ACwing-UAV/ACwing_HW/01 - FC_KiCadProj/README.md

# ACwing FC rev A – KiCad project

**Project:** ACwing · **Author:** Andrea Cirillo

KiCad sources of the ACwing FC rev A board (KiCad 10 project files, 2026-11-07). The board description, schematic PDF, BoM,
JLCPCB files, Gerber, STEP and board views are in [`00 - Docs/00 - FC_Docs`](../00%20-%20Docs/00%20-%20FC_Docs/).

| File / folder | What |
|---|---|
| `ACwing_FC_A.kicad_pro`, `.kicad_sch`, `.kicad_pcb` | project, schematic, routed PCB |
| `*.kicad_sym`, `*.pretty/`, `fp-lib-table`, `sym-lib-table` | project library (symbols, footprints, ACwing logos) |
| `3d/` | STEP models, referenced as `${KIPRJMOD}/3d/...` |
| `generator/` | scripts that generated, routed and checked the design (build_all_h.sh) |
