ACwing-UAV/ACwing_HW/02 - ESC_1S_KiCadProj/README.md

# ACwing ESC 1S rev A – KiCad project

**Project:** ACwing · **Author:** Andrea Cirillo

KiCad sources of the ACwing ESC 1S rev A board (KiCad 10 project files, 2026-11-07). The board description, schematic PDF, BoM,
JLCPCB files, Gerber, STEP and board views are in [`00 - Docs/01 - ESC_1S_Docs`](../00%20-%20Docs/01%20-%20ESC_1S_Docs/).

| File / folder | What |
|---|---|
| `ACwing_ESC1S_A.kicad_pro`, `.kicad_sch`, `.kicad_pcb` | project, schematic, routed PCB |
| `*.kicad_sym`, `*.pretty/`, `fp-lib-table`, `sym-lib-table` | project library (symbols, footprints, ACwing logos) |
| `3d/` | STEP models, referenced as `${KIPRJMOD}/3d/...` |
| `generator/` | scripts that generated, routed and checked the design (build_all_esc.sh) |
