ACwing-UAV/ACwing_HW/00 - Docs/03 - FLOW_Docs/README.md

# ACwing Flow rev A – optical flow + ToF height board for ACwing FC rev A

**Project:** ACwing · **Author:** Andrea Cirillo · **Overview:** [repository README](../../Readme.md)

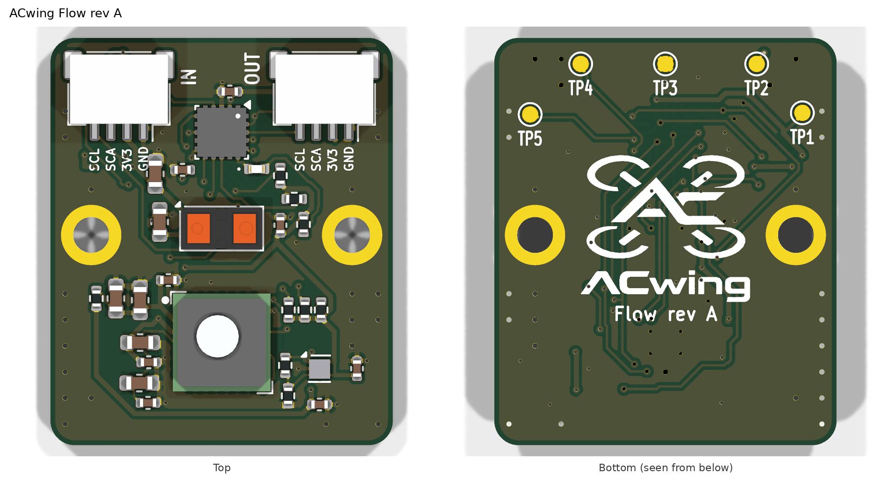
[picture p4: 00 - Docs/03 - FLOW_Docs/ACwing_Flow_A_pcb.png]
ACwing_Flow_A


> **Revisions.** Rev A is the first released revision.

> **Flow board cover (2026-11-13, mechanics, board unchanged).** Frame A1 rev R adds a PETG cover over the sensor side:
> only the PMW3901 lens, the VL53L1X window and LED D1 stay open; the J1 / J2 edge is open. The two board screws become
> **M2 × 6 nylon from below** through the cover. Keep-outs for a future revision: [mechanical handoff §0.24](../04%20-%20System_Docs/ACwing_mechanical_handoff.md).

> **Silkscreen with connector pin names (2026-11-12, still rev A).** The connector labels now carry the pin names (commit 568e74d). Layout and copper unchanged. `ACwing_Flow_A_pcb.png` and `ACwing_Flow_A_3D.png` regenerated with the KiCad 10.0.6 raytracer (`99 - Tools/outputs/k10_renders.sh`, `compose_board_renders.py`).

> **45° routing (2026-11-08, still rev A).** Every track is now at 0 / 45 / 90° (house rule for all ACwing boards):
> 165 off-angle runs replaced by octilinear doglegs, same end points, pads and vias; 0 segments off 45° left; 170 duplicated segments left by the router removed.
> Checked and saved with KiCad 10.0.6: DRC 0 / 0, ERC unchanged; Gerber, drill, STEP, schematic PDF, DRC report and renders regenerated.

> **Back to 1.0 mm (2026-11-07 evening, still rev A).** To save weight, all ACwing boards are **1.0 mm** again (the
> 1.6 mm step of the same morning is reverted): 2 layers, 0.91 mm core, KiCad 10 files, vias unchanged. Layout unchanged.
> The board back is 0.6 mm closer to the tray face again (M2 × 4 nylon screws). Board mass −0.6 g. DRC 0 / 0.

> **Layout and routing update (2026-11-02, still rev A).**
> - **Both Qwiic connectors on the top edge** (they were on the left and right edges): J1 IN at (−6.3, +8.95), J2 OUT
>   at (+6.3, +8.95), mouth +t, labels QWIIC IN / QWIIC OUT under them. The cables to the FC and to the GPS board now
>   leave from the same edge: update cable C in the mechanical handoff.
> - **SWD test pads on the back side (2026-11-03), along the top edge, symmetric**, behind the Qwiic connectors and
>   close to the bridge MCU: TP1 3.3 V (−8.4, +7.9), TP2 NRST (−5.6, +10.9), TP3 GND (0, +10.9), TP4 SWDIO (+5.2, +10.9),
>   TP5 SWCLK (+8.3, +7.8) (sensor-side view; the layout chosen by A. Cirillo mirrored to the top edge). SWD lines
>   SWDIO 7 mm, SWCLK 6 mm (they were 41 / 17 mm with the pads on the bottom edge). The board is programmed off the
>   drone. Schematic numbering as 2026-11-02.
> - **Plated mounting holes (2026-11-03):** H1 / H2 are now Ø2.2 mm PTH with a 3.6 mm copper ring on both sides,
>   tied to GND (as the FC holes).
> - **Bridge MCU pins changed for the routing:** ToF XSHUT on **PA8** (pin 13, was PA0), status LED on **PA10**
>   (pin 15, was PA8). Firmware must follow.
> - No via in an SMD pad (the STM32C011 exposed pad keeps its ground vias); DRC 0.
> - Solder mask expansion 0.05 mm, minimum web 0.09 mm: every pad gap ≥ 0.19 mm, except the LDK130 DFN-6 (0.4 mm
>   pitch, 0.12 mm gaps, "allow solder mask bridges" on the footprint: JLC opens the mask over the pad row).

KiCad 10 project (2026-11-07). A 21 × 25 mm board for indoor flight: it measures ground motion
(optical flow) and height (time of flight). It sits under the battery tray, sensor side down, and connects to the
FC expansion bus (Qwiic) with a standard JST SH 4-pin cable.

## Decisions (2026-10-17)
| Topic | Choice | Why |
|---|---|---|
| Flow sensor | PixArt **PMW3901MB-TXQT** + LN03-ZSZ lens | the de-facto drone flow sensor (80 mm to infinity); no ST part does far-field optical flow |
| Height | ST **VL53L1X** ToF, on the Qwiic bus (0x29) | ST part, 4 m range indoors, standard driver (ULD) |
| Bridge MCU | ST **STM32C011F4U6** (UFQFPN-20) | the PMW3901 needs SPI with exact timing; the bridge reads it at 100 Hz and serves the data over I2C, so the FC needs no extra SPI/CS lines to a cable |
| Link | Qwiic / STEMMA QT (JST SH 4-pin) × 2, pass-through | same bus as the GPS board: flow and GPS boards chain in any order |
| Supply | 3.3 V from the FC expansion LDO (VEXP); 2.0 V for the PMW3901 core from an adjustable LDK130 | the PMW3901 VDD is 1.8–2.1 V |
| Mounting | under the battery tray, sensor side down, 2 × M2 | the FC bottom has no room (1.2 mm limit, frame deck 3 mm below); see the mechanical handoff |

## Contents
| File | What |
|---|---|
| `ACwing_Flow_A_pcb.png` | top and bottom renders of the assembled board |
| [`ACwing_Flow_A_schematic.pdf`](ACwing_Flow_A_schematic.pdf) | schematic |
| `ACwing_Flow_A_BoM.xlsx` | assembly BoM (sheet `BoM`) and costing (sheet `Costing`) |
| `ACwing_Flow_A_BoM_JLCPCB.xlsx`, `ACwing_Flow_A_CPL.xlsx` | JLCPCB BoM (LCSC part numbers) and pick-and-place with rotation corrections (30 parts) |
| `ACwing_Flow_A_gerber.zip` | Gerber (2 copper layers) + Excellon drill files, origin at the lower-left corner: upload as is to JLCPCB |
| `ACwing_Flow_A_DRC.rpt` | KiCad DRC report (0 violations, 0 unconnected pads) |
| `ACwing_Flow_A.step`, `ACwing_Flow_A_3D.png` | STEP of the assembled board; 3D renders (top, isometric, bottom) |
| `ACwing_Flow_A_mech_outline.dxf` | mechanical outline for the frame design |

KiCad sources in [`04 - FLOW_KiCadProj/`](../../04%20-%20FLOW_KiCadProj/):

| File | What |
|---|---|
| `ACwing_Flow_A.kicad_pro / .kicad_sch / .kicad_pcb` | KiCad 10 project, schematic, routed PCB |
| `ACwing_Flow.pretty/`, `3d/` | project library (symbols, footprints incl. the ACwing logos) and STEP models |
| `generator/` | scripts that generated and checked the design (see Regeneration) |

## Circuit
- **J1, J2 (Qwiic).** JST SM04B-SRSS-TB, both on the top edge (J1 IN left, J2 OUT right), wired in parallel: 1 GND, 2 3.3 V,
  3 SDA, 4 SCL. No pull-ups here (they are on the FC).
- **Power.** +3V3 from the bus (FC U11, 300 mA shared with the GPS board). The board draws about 35 mA (flow 9 mA,
  ToF up to 20 mA peak, MCU 3 mA).
  - U2 LDK130PU-R (DFN-6) set to 2.0 V by R5/R6 (15k/10k: 0.8 V × 2.5).
  - PMW3901 VDD through R1 3 Ω with C1/C2 22 µF + C3 100 nF; VDDIO on 3.3 V (C4 10 µF + C5 100 nF); VREG C6 4.7 µF +
    C7 100 nF. This is the datasheet reference circuit (Fig. 8).
- **U1 PMW3901MB.** SPI mode 3, 2 MHz, to the bridge: NCS PA4, SCK PA5, MISO PA6, MOSI PA7, MOTION PA3, NRESET PA2.
  R2/R3/R4 10 k pull-ups keep it deselected and out of reset while the bridge boots.
- **U3 VL53L1X.** On the Qwiic bus at 0x29. XSHUT (PA8) and GPIO1/INT (PA1) go to the bridge, with 10 k pull-ups.
  The bridge can hold the ToF in reset, which allows an address change if a second ToF is ever added.
- **U4 STM32C011F4U6 (flow bridge).** I2C1 target at **0x3B** on PB6/PB7. Planned firmware: read the PMW3901 motion
  burst at 100 Hz, accumulate dX/dY and publish them with SQUAL and shutter, plus a data-ready counter. The register
  map is part of the indoor firmware work.
  - SWD on test pads TP1 3.3 V, TP2 NRST, TP3 GND, TP4 SWDIO, TP5 SWCLK (first programming; later updates through the
    FC are possible with an I2C bootloader).
  - D1 green status LED on PA10 (low = on).
- **Bus map (whole drone).** GPS 0x42, GPS compass 0x1E, ToF 0x29, flow bridge 0x3B: no clash.

## Mechanics
- 21.0 × 25.0 × 1.0 mm (1.6 mm on 2026-11-07 only), R1.5 corners, 2 layers. Two M2 holes (Ø2.2 PTH, 3.6 mm GND ring both sides) at (±8.0, +0.4), keep-out r 2.4 mm.
- **All parts on one side** (the sensor side). Tallest: Qwiic connectors ≈ 2.9 mm, PMW3901 lens 2.28 mm, VL53L1X 1.56 mm.
  The back side has no parts: board name, logo and the five flat SWD test pads (program the board before mounting it).
- Sensor axes (sensor-side view): PMW3901 at (0, −6.2), field of view 42°; VL53L1X at (0, +0.8), 27°.
- Mount it parallel to the propeller plane, no window in front of the sensors. Everything for the frame designer is
  in [`ACwing_mechanical_handoff.md`](../04%20-%20System_Docs/ACwing_mechanical_handoff.md) and the DXF.

## PCB
- Rules: 0.15 mm tracks / 0.12 mm clearance (Default), 0.3 mm for power; vias 0.45/0.2 mm; copper to edge 0.3 mm.
- GND pours on both layers. Every small GND pad has its own via (the sensor side is crowded and its pour breaks up),
  4 vias at the PMW3901 ground pad corners, GND stitching on a grid, and a final check that joins any isolated
  ground island with a via.
- The LDK130 DFN-6 (0.4 mm pitch) escape is pre-routed and locked: IN/EN joined outside pin 5, GND via, short stubs.
- Routing: 733 tracks, 92 vias (2026-11-03: SWD lines re-routed to the back-side test pads), no via in an SMD or test pad.

## Checks
- Netlist: 0 errors (`check_net.py`, 44 nets).
- KiCad DRC (`ACwing_Flow_A_DRC.rpt`): 0 violations, 0 unconnected pads, 0 footprint errors.
- Silkscreen: QWIIC IN / QWIIC OUT on the sensor side; TP1–TP5, logo and board name on the back; no part references.

## Fabrication (JLCPCB)
- 2 layers, **1.0 mm** FR-4 (0.91 mm core), 1 oz. All parts on the top (sensor) side: single-sided assembly.
- BoM `ACwing_Flow_A_BoM_JLCPCB.xlsx`; every line has an LCSC number (PMW3901 C43496881, VL53L1X C190004,
  STM32C011F4U6TR C5456188, LDK130PU-R C157446).
- **PMW3901 lens.** The LN03-ZSZ lens is a separate item in the PixArt ordering table. Check that the LCSC/JLC part
  includes it; otherwise order the lens separately and press it on after reflow (it is not reflow-safe if it is a
  plastic lens).
- CPL rotations: the corrections learned on the FC are applied (DFN-6 +270°). Check U1 pin 1, U2, U3 and U4 in the JLC
  preview before ordering.
- Cost: about **11.1 USD per board at 10 boards, 9.4 USD at 100** (components only). The PMW3901 is about half of it.

## To check before ordering
1. ERC: **done with KiCad 10.0.6 (2026-11-07)**. The 1 error is a power-flag case: PMW_VDD is fed through R1 (a
   passive pin), so add a PWR_FLAG on it. The library warnings come from the KiCad setup.
2. PMW3901 land pattern: COB-28, 6 × 6 mm, 28 pads at 0.65 mm pitch on rows ±2.625 mm, centre pad 2.4 × 1.9 mm.
   The optical axis is at the footprint centre, which the mechanics use (t = −6.2 on the board, frame centre).
3. Lens: LCSC stocks the PMW3901MB-TXQT (C43496881, 162 pcs on 2026-11-07), not the LM19-LSI lens. JLC does not list
   lens fitting during assembly. Buy the LM19-LSI from a PixArt distributor and fit it by hand after assembly, following the PixArt
   lens mounting note.
4. JLC preview of the CPL.
5. The STM32C011 bridge firmware is not written yet: the board can be tested first with the ToF only (direct on the bus).

## Regeneration
`generator/run_sch.sh`, `gen_pcb_flow.py`, `loop_route.sh`, `post_route.sh`. Uses `kisch.py`, `sexp.py`, `silk_refs.py`,
`step_mesh.py` from the FC generator and `make_3d_e.py` for the missing STEP models. Freerouting is not deterministic:
`loop_route.sh` reruns it until the DRC has no unconnected item.

> The generator scripts were run in the original build environment: absolute paths inside them (`/home/claude/...`) must be adapted before running them again. The ACwing logos and silkscreen labels were added afterwards with the tools in [`brand/tools`](https://github.com/ACwing-UAV/ACwing/tree/main/brand/tools) of the ACwing system repository.
