ACwing-UAV/ACwing_HW/00 - Docs/00 - FC_Docs/README.md

# ACwing FC rev A – universal flight controller: 1S–6S, commercial 4-in-1 ESCs, up to 8 motors

**Project:** ACwing · **Author:** Andrea Cirillo · **Overview:** [repository README](../../Readme.md)

ACwing_FC_A

> **Revisions.** Rev A is the first released revision. Earlier letters, marked *draft* in this document (drafts C–G), are internal design iterations that were never manufactured.

> **Silkscreen with connector pin names (2026-11-12, still rev A).** The connector labels now carry the pin names (commit 568e74d). Layout and copper unchanged. `ACwing_FC_A_pcb.png` and `ACwing_FC_A_3D.png` regenerated with the KiCad 10.0.6 raytracer (`99 - Tools/outputs/k10_renders.sh`, `compose_board_renders.py`).

> **45° routing and no battery pads (2026-11-08, still rev A).**
> - **Every track is now at 0 / 45 / 90°** (house rule for all ACwing boards): 374 off-angle runs from Freerouting
>   replaced by octilinear doglegs or a short octilinear A* detour, same end points, pads and vias; 0 segments off 45°
>   left (checked on the exact coordinates). 93 duplicated segments and 3 dangling stubs left by the router removed.
> - **Battery pads J7 / J8 removed** (and the "- BAT +" label). The FC is supplied **only through ESC link A J2 pin 2
>   (VBAT)**, as on commercial FC / 4-in-1 ESC stacks. The Qwiic ports stay 3.3 V I2C only (VEXP is an output of the FC).
>   With separate ESCs + PDB, crimp a JST SH 8-pin lead with GND / VBAT on pins 1 / 2 (JST SH: 1 A per contact, the FC
>   draws < 0.5 A).
> - Checks with KiCad 10.0.6: zones refilled, DRC 0 violations / 0 unconnected, schematic parity: no missing or extra
>   footprint, ERC the same 2 power-flag errors as before. Gerber, drill, STEP, schematic PDF, DRC report, renders and
>   routing plot regenerated; CPL checked against the KiCad position export (unchanged).

> **Layout update 2 and 1.0 mm (2026-11-07 evening, still rev A).**
> - **ESC A (J2) on the front edge just after the front-left arc**: centre (−10.5, +16.85), body u −16.4 … −4.6
>   (0.6 mm from the end of the R3 arc), right above ESC 1S J1: cable A is a short, straight 1:1 loop. **ESC B (J6)**
>   takes the old ESC A place, (+3.64, +16.85). ESC A M1–M4 run from J2 to R20–R23 as a B.Cu bus under J2 / J6.
> - **Front-left corner R3 again** (the ESC 1S charge port moved under the FC USB-C at the rear-right chamfer).
> - **RGB LEDs at the corner tips, the same on both corners** (point-symmetric): D1 (−15.1, −18.4), D2 (−18.4, −15.1),
>   D3 (+15.1, +18.4), D4 (+18.4, +15.1); each pair 5.4 mm apart (was 10.5 mm). Decoupling C40 / C41 / C42 / C45 next to them.
> - ~~Battery pads J7 / J8 down the left edge~~ (removed on 2026-11-08, see above).
> - **BLE antenna AE1 down the left edge**: (−18.6, +4.3), keep-out u −20.5 … −17.5, v −1.2 … +10.3; RF line from
>   the MLPF ≈ 16 mm, straight, 50 Ω on F.Cu over In1 GND (was 22.4 mm).
> - **Magnetometer U3 and barometer U4** right of the MCU, front-right quadrant: U3 (+16.0, +10.0), U4 (+13.4, +13.8),
>   ≈ 36 mm from the buck inductor L3. Decoupling on the bottom below them. LED supply kept ≥ 4.5 mm from U3.
>   `generator/emi_check.py`: static field at U3 39.5 µT upper bound (was 42.6 µT), L3 stray field 0.05 µT; IMU unchanged.
> - **Board 1.0 mm again** (JLC04101H-7628: same 0.21 mm 7628 prepreg under F.Cu, so RF line and USB pair unchanged).
>   J1 USB-C shell legs stick out ≈ 0.8 mm under the board again. Board mass −1.8 g.

KiCad 10 project (2026-11-07). Rev A turns the FC into a **standard FC that works with any power
stage that uses the common 4-in-1 ESC connector**:
- **Mini drone (1S, brushed coreless):** the ACwing 1S power board (ACwing ESC 1S rev A) carries the
  motor stages, the battery connector and pads, the 1S USB-C charger and the current sensor. To the FC it looks like
  any ESC: VBAT (1S) and CUR on the 8-pin cable.
- **Larger drone (3S–6S brushless, payload > 2 kg):** a commercial 20 × 20 4-in-1 ESC replaces the power board and
  supplies the FC through the same cable. Hexa / octo frames add a second 4-in-1 ESC on ESC link B.

The FC has one USB-C port for data, DFU flashing and bench supply only. Battery charging lives on the 1S power board
(its own USB-C), because only the 1S battery can be charged that way.

## Layout update (2026-10-24, still rev A: no board made yet)
| Item | Before | Now | Why |
|---|---|---|---|
| **MCU U2** | (−3.0, +3.0) | **(0, 0), board centre** | symmetric layout; RF line to the antenna 22.4 mm (≈ 0.2 dB more loss than before), 50 Ω microstrip over solid In1 GND |
| **IMU U1** | (0, −3.6), rot 0 | **(0, −7.6), rot 270** | room for the pin escape south of the centred MCU; INT1 / MISO face MCU pins 42 / 44 (straight pre-routed lines). **Firmware: remap the IMU axes** (sensor X = board −v, Y = board +u) |
| **J6 ESC link B** | left edge | **front edge, next to J5 (ELRS)**, same mouth direction, centre (−8.2, +16.85) | both cable ports together on the front edge; J6 body ≥ 3.4 mm from the antenna keep-out |
| **Input buck U12 / L3** | rear-left corner, between the rear LEDs D1 / D2 | **left edge** (old J6 spot): L3 (−16.9, −4.6), U12 (−12.1, −5.0) | L3 no longer between the two LEDs; 41 mm from the magnetometer, 17 mm from the IMU |
| LDO U5, C8, R3, R4 | south of the IMU | west of the IMU, (−4.6, −7.8) | IMU escape channel |
| **LEDs D3 / D4** | supply pins toward the magnetometer | **rotated 180°**, supply (VSYS since 2026-10-27, was VLED behind D11) pre-routed on B.Cu along the board interior | the LED current changes with the colour: kept ≥ 4.8 mm from the magnetometer (was 3.9 mm, and a LED data line crossed it) |

Stack: the GPS board Qwiic J1 moved to v = +3.6 so it sits right above FC J3 (straight cable). The ESC link (FC J2 /
ESC J1) stays 8 mm offset: FC J2 can move only 0.8 mm before the USB-C, and ESC J1 cannot reach the rear-edge centre
(motor M1 pads, fixed by the frame).

## Layout and routing update (2026-11-02, still rev A: no board made yet)
| Item | Before | Now | Why |
|---|---|---|---|
| **J2 ESC link A** | rear edge, (+1.5, −16.9), mouth −v | **front edge, next to J6**, (+3.6, +16.85), mouth +v | both ESC links on the same edge (one cable direction for one or two 4-in-1 ESCs) |
| **J5 ELRS** | front edge, (+2.0, +16.85) | **rear edge**, J2's old spot, (+1.5, −16.9), mouth −v | swapped with J2 |
| C2 (VBAT at J2), R42 (CUR) | (−1.6, −12.4) / bottom (+0.6, −17.2) | top (+5.2, +12.35) / bottom (+0.6, +12.4) | follow J2 |
| R21–R23 (PWM M2–M4, bottom) | — | moved 2 mm east | room for the new J2 escape |
| **Test pads TP1–TP8** (pogo grid, bottom) | numbered out of order | **ascending in reading order (bottom view)**: TP1 BOOT0, TP2 NRST, TP3 SWCLK, TP4 SWDIO (upper row), TP5 CRSF_RX, TP6 CRSF_TX, TP7 GND, TP8 VDD (lower row) | readable pogo fixture; schematic renumbered to match |
| **Vias in pads** | vias on several SMD pads (GND, PWM, HSE, VBAT_SNS, USB ESD) | **none**: vias moved next to the pad with a short stub (dog-bone), or the net rerouted | no solder wicking, no via plugging needed. Only the exposed thermal pads of U2 (STM32WB55, its VSS is the EP) and U12 (LM5166) keep their vias, by design |
| **U8 MLPF-WB55 (CSP-6, 0.5 × 0.587 mm pitch)** | 0.20 mm pads, own mask margin | **0.25 mm pads**, board mask expansion; 0.25 mm gap between pads | the 0.25 mm minimum asked for the ball pads; still ≥ 0.19 mm pad-to-pad for the mask dams |
| **U1 / U3 / U4 LGA pads** | 0.35 mm wide, 0.15 mm gaps | **0.31 mm wide** (U3 IIS2MDC 0.30 × 0.35, U4 LPS22HH 0.31 × 0.38): every gap ≥ 0.19 mm | solder mask dam between every pad (see Fabrication) |
| Silkscreen | references of passives and ICs removed (2026-11) | connector labels only: ESC A / ESC B (front), ELRS (rear), GPS / FLOW, USB, TP1–TP8 on the bottom, logo and board name on both sides | |

ESC link A now leaves from the front edge: the cable to the ESC 1S (its J1 is on the rear side) is longer than the
17 mm of the Mech A1 stack. **Update the cable A length and route in the mechanical handoff before ordering cables.**

## EMI check (magnetometer U3, IMU U1)
`generator/emi_check.py`: Biot–Savart on every routed track of the current-carrying nets (contributions added in
magnitude, no cancellation by the return path: an upper bound), dipole estimate for the inductors, distances on every
layer, In1 GND under the sensors.

| Source at the magnetometer | Before | Now |
|---|---|---|
| LED supply (VSYS branch to the LEDs, 144 mA at full white, **varies with the colour**) | 6.3 µT, LED data line under the sensor | **4.7 µT**, nothing crosses the sensor |
| VSYS / VBAT / VBUS / VEXP / VDD / VREG (DC, calibrated as hard iron) | 18.0 µT | 14.9 µT |
| Buck switch node / L3 stray field | 0.23 / 0.02 µT | 0.39 / 0.03 µT |
| Closest aggressor copper | LED data line 0 mm | LED data line 3.4 mm, LED supply 4.1 mm |

**2026-11-02 rerun** (J2 on the front edge, rerouted board): static field at the magnetometer, upper bound,
**42.6 µT** (was 32.1 µT on the 2026-10-27 board with the same script): VSYS 31.6 µT (was 23.7), VBAT 5.3 µT
(was 2.7: the battery now enters 9.8 mm from the sensor, on the top layer), the rest unchanged. All DC terms, removed
by the hard-iron calibration; the closest switching / colour-dependent copper is unchanged (LED data line 3.4 mm).
IMU: unchanged (VBUS on In2 under the sensor, UART ≥ 1.7 mm).

- Magnetometer: In1 GND 84 % under the sensor (+1 mm), no slots. The only colour-dependent term is the LED supply:
  firmware either compensates it (LED current is known from the commanded colour) or keeps the LED pattern fixed while
  the compass is used. The motor currents on the ESC 1S below (≈ 2 µT per motor at full throttle, 18 mm away) are
  throttle-dependent: calibrate them with a throttle/compass fit. Outdoors, use the GPS board compass for the heading.
- IMU: nearest switching node ≥ 7 mm (STM32 SMPS L1), buck ≥ 12 mm; In1 GND 83 % under the IMU, no slots. Only the
  USB 5 V (DC, bench) and the ELRS UART (≥ 1.7 mm) pass nearby: no concern for a digital MEMS sensor. Vibration remains
  the dominant disturbance (tap test on the first build).

## Changes from draft G
| Item | Draft G | Rev A | Why |
|---|---|---|---|
| **Input converter** | TPS62160 buck, 3–17 V (1S–3S) | **U12 LM5166DRCT**: 3–65 V in (abs. max 68 V), 500 mA, PFM, PFET high side with 100 % duty cycle, L3 22 µH (SWPA5040S, Isat 1.9 A), C47 4.7 µF 50 V + C49 10 nF in, C6 100 µF + C46 22 µF out, R47/R48 470k/200k → **VREG 4.1 V** | one converter for **1S–6S** with margin for ESC voltage spikes; on 1S it passes the battery through (VREG ≈ VBAT − I × 1.1 Ω), as drafts F/G did |
| RC filter R1 / C6 | 1 Ω + 100 µF on VREG | removed (C6 is now the buck output capacitor) | VREG is regulated |
| **USB charger, 1S charge gate** | U6 STC4054, D10, R5–R7, C10, C11; Q6/Q7, R43, R45 | **removed** | charging moves to the 1S power board |
| **External current input** | TP9/TP10 → PA6 | removed | PA6 is now motor M8 |
| **Motor outputs** | 4 (TIM2) | **8**: M1–M4 TIM2 (J2), M5–M7 TIM1 CH1–CH3 (PA8–PA10), M8 TIM16 CH1 (PA6) on **ESC link B (J6)** | hexa / octo frames with two 4-in-1 ESCs |
| **ESC link B (new)** | – | J6 JST SH 8-pin, top side, **front edge next to J5** (layout update), mouth toward the front; R25–R28 100 Ω; pins 2–4 (VBAT, CUR, TLM) open | same connector and cable as ESC link A; two ESC supplies are never tied together on the FC |
| **Second Qwiic port (new)** | J3 only | J3 (right edge, front) + **J4 (right edge, rear)** in parallel | GPS board and flow board get their own cables; no daisy chain under the stack |
| ELRS (J5) | USART1 PA9/PA10 | USART1 **PB6/PB7** (alternate pins) | PA9/PA10 are TIM1 for M6/M7 |
| RGB LEDs | PB6 TIM16_CH1N | **PA7 TIM17_CH1** + DMA | PB6 is USART1 TX |
| ESC A telemetry | PB7 | PB0 (GPIO/EXTI, optional) | bidirectional DShot / EDT is the main telemetry path |
| VBAT sense | 470k/100k (17 V max) | **100k/10k**: × 1/11, 25.2 V → 2.29 V, full scale 34 V | 6S |
| C2 (VBAT at J2) | 10 µF 25 V 0805, bottom | 4.7 µF **50 V** 1206 X7R, top | 6S; the 1206 is too tall for the bottom side |
| Power path | Q5 / D9 rear-left | same circuit, moved east of the IMU | the input buck takes the rear-left corner |

Outline: preliminary-draft frame outline (40 × 40, R3) + 0.8 mm USB-corner step as drafts F/G (the **front-left chamfer** v − u = 36.6 of 2026-10-18 was removed on 2026-11-07; it came from the stack check with the
power board rev A charge port below; the chip antenna stays inside, DRC 0). Unchanged: 20 × 20 grommet holes, MCU / IMU / compass / baro / flash,
RF front end and antenna, LDOs U5 (3.1 V) and U11 (VEXP 3.31 V), 4 RGB LEDs and their positions, J1 USB-C, J2 ESC A,
J3 Qwiic, J5 ELRS positions, pogo grid.

## Supported configurations
| Power stage | Battery | VREG | Charging | Current measurement |
|---|---|---|---|---|
| ACwing 1S power board (brushed coreless) | 1S | ≈ VBAT (100 % duty cycle) | on the power board (its USB-C) | CUR pin, 0.1 V/A |
| Commercial 20 × 20 4-in-1 ESC (2–6S class) | 2S–6S | 4.1 V | external balance charger | CUR pin (scale in firmware) or EDT |
| Two 4-in-1 ESCs (hexa / octo) | 2S–6S | 4.1 V | external | ESC A CUR + EDT on all motors |
| Separate ESCs + PDB | 2S–6S | 4.1 V | external | EDT; FC supplied through a JST SH lead on J2 pins 1 / 2 |

- **Maximum 6S (25.2 V).** LM5166 abs. max is 68 V, so 6S has a wide margin for regenerative spikes. The 50 V input
  capacitors and the 100k/10k divider (34 V full scale) set a practical limit of 6S–7S.
- **FC load on VREG ≤ 0.5 A** (LM5166). Typical load: MCU + BLE + sensors ≈ 60 mA, ELRS receiver 50–150 mA, GPS board
  ≤ 100 mA, flow board 35 mA, 4 LEDs up to 150 mA at full white.
- **1S end of discharge:** below about 3.3 V the 3.1 V LDO (VDD) and the 3.31 V VEXP leave regulation (dropout).
  The buck itself runs down to 2.45 V. Same behaviour as drafts F/G.

## Power architecture
```
ESC A J2 pin 2 ─── VBAT 1S–6S ── U12 LM5166 (PFM) ── VREG 4.1 V ── Q5 ──┬── VSYS ── U5 LDO 3.1 V (VDD: MCU, sensors)
                         │                                           │         ├─ U11 LDO 3.31 V (VEXP: Qwiic J3/J4)
                         └─ R8/R9 → VBAT_SNS (PA5)          USB VBUS ── D9 ─┘         ├─ 4 × XL-2020RGBC-WS2812B (data: PA7 → U13 buffer)
                                                                                        └─ J5 ELRS supply
```
- Q5 (AO3401A) is on with the battery only; USB on its gate turns it off, so USB never back-feeds the buck or the
  ESC (the LM5166 high-side body diode would otherwise connect VREG to VBAT).
- Q5's body diode points from VREG to VSYS. With USB and battery both present, VSYS comes from USB (4.65 V > 4.1 V –
  body-diode drop).
- **LEDs on VSYS, data through U13** (2026-10-27): the XL-2020RGBC-WS2812B needs VDD ≥ 3.5 V and a data high level of
  0.7 × VDD (2.45–3.26 V over the VSYS range), above or too close to the 3.1 V GPIO. U13 (TI **SN74LV1T34DCKR**,
  single-supply buffer, SC-70-5, bottom side next to D1) runs from VSYS: its input threshold is TTL-level
  (VIH ≤ 2.0 V at 5 V, 5 V tolerant) and its push-pull output swings to VSYS, so the LED input always sees a full-level
  edge, on battery and on USB alone. C50 100 nF decouples it; R39 33 Ω sits between U13 and D1. Propagation delay
  ≈ 5 ns, negligible against the 800 kHz WS2812 bit time.

## ESC link A (J2) and ESC link B (J6)
| Pin | J2 (ESC A, front edge) | J6 (ESC B, front edge) |
|---|---|---|
| 1 | GND | GND |
| 2 | VBAT 1S–6S → U12, VBAT_SNS, C2 | open |
| 3 | CUR → R42 1 k → PA4 (ADC IN9), C1 | open |
| 4 | TLM → R24 100 Ω → PB0 (optional) | open |
| 5–8 | M1–M4 → 100 Ω → PA0–PA3 (TIM2 CH1–CH4) | M5–M8 → 100 Ω → PA8, PA9, PA10 (TIM1 CH1–CH3), PA6 (TIM16 CH1) |

1:1 JST SH 8-pin cables, ≈ 50 mm. Check the pin order of any third-party ESC before plugging it in; re-pin the
cable if it differs.

## Firmware pin map (rev A)
See `ACwing_FC_A_pinmap.md`. Summary:
| Function | Pin | Peripheral |
|---|---|---|
| Motors M1–M4 / M5–M7 / M8 | PA0–PA3 / PA8–PA10 / PA6 | TIM2 CH1–CH4 / TIM1 CH1–CH3 / TIM16 CH1, all with DMA: 32 kHz PWM (brushed) or DShot300/600 + bidirectional DShot / EDT |
| ESC current / VBAT sense | PA4 / PA5 | ADC1 IN9 / IN10 |
| ESC A telemetry (optional) | PB0 | GPIO / EXTI (software UART) |
| ELRS (J5) | PB6 TX / PB7 RX | USART1, CRSF 420 kbaud |
| SPI1 IMU + flash | PB3 / PB4 / PB5, CS PC14 (IMU), PE4 (flash) | SPI1 |
| IMU INT1 / RGB LEDs / VBUS detect | PA15 / PA7 / PB1 | EXTI / TIM17 CH1 + DMA / GPIO |
| Qwiic J3 + J4 / USB / SWD / BOOT0 / HSE | PB8–PB9 / PA11–PA12 / PA13–PA14 / PH3 / 32 MHz | as draft F |

- Free: PB2. Not connected: PC15. No second UART is free: GNSS goes on I2C (ACwing GPS, u-blox DDC).

## Add-on boards
- **GPS board (ACwing GPS rev A)**, optional (outdoor variant), stacked above on the 20 × 20 holes with a **6 mm** gap
  (GPS rev A has its Qwiic connectors on the top side; the GPS draft C needed 8 mm): cable from FC **J3** (right edge, front) to
  GPS J1 (right edge). GPS J2 is an optional pass-through.
- **Flow board (ACwing Flow rev A)**, under the frame: cable from FC **J4** (right edge, rear) down through the deck to
  flow J1.
- Bus addresses: GNSS 0x42, GPS compass 0x1E, ToF 0x29, flow bridge 0x3B (no clash). VEXP 300 mA covers both boards.

## Placement (board frame u right, v front; FC top view)
| Part | Where |
|---|---|
| U2 MCU | top, **(0, 0)**, rot 180; MLPF U8 (−1.0, +6.1), crystal Y1 (−5.6, +2.4) |
| U1 IMU | top, (0, −7.6), rot 270; LDO U5 (−4.6, −7.8) west of it |
| U12 LM5166, L3 (5 × 5 × 4 mm), C47, C49, R47/R48 | top, **left edge**: L3 (−16.9, −4.6), U12 (−12.1, −5.0), C47 (−11.8, −1.9) rot 180 (VBAT pad toward U12 pin 7), C49 (−9.0, −2.8) |
| C6, C46 (VREG bulk) | top, (−15.6, −9.7), (−13.45, −13.3) |
| C2 (VBAT at J2) | top, (−4.7, +11.3) |
| Q5, D9, C7, R2 (power path) | top, east of the IMU, (+6.6, −4.4) / (+5.2, −7.3) |
| **J2 ESC A** | top, **front edge after the front-left arc**, (−10.5, +16.85), mouth +v; pins v = +14.85, u = −7.0 (pin 1) … −14.0 (pin 8); right above ESC 1S J1 |
| **J6 ESC B** | top, **front edge**, (+3.64, +16.85), mouth +v; pins v = +14.85, u = +7.14 (pin 1) … +0.14 (pin 8) |
| J5 ELRS | top, **rear edge**, (+1.5, −16.9), mouth −v |
| J3 Qwiic (GPS) | top, right edge, (+16.9, +3.6), mouth +u; GPS J1 right above it |
| J4 Qwiic (flow) | top, right edge, (+16.9, −4.3), mouth +u |
| LEDs D1–D4 | top, corner tips, point-symmetric: D1 (−15.1, −18.4) rot 180, D2 (−18.4, −15.1) rot 270, D3 (+15.1, +18.4) rot 0, D4 (+18.4, +15.1) rot 90 |
| U3 magnetometer, U4 baro | top, front-right quadrant, (+16.0, +10.0) / (+13.4, +13.8) |
| J1 USB-C, antenna AE1, pogo grid, flash U10 (bottom) | J1 (+15.8, −15.8) at the chamfer, AE1 left edge middle (−18.6, +4.3), pogo grid TP1–TP8 bottom rear centre (ascending, bottom view), U10 bottom (+8.9, −3.6) |

## PCB
- **4 layers, 1.0 mm (1.6 mm on 2026-11-07 only), JLCPCB JLC04101H-7628:** F.Cu 35 µm · 7628 prepreg 0.21 mm · In1 15 µm ·
  core 1.065 mm · In2 15 µm · 7628 prepreg 0.21 mm · B.Cu 35 µm (stack-up stored in the board file). The F.Cu → In1
  dielectric is the same 0.21 mm 7628 as the 1.0 mm stack-up, so the **0.36 mm RF line stays 50 Ω** and the USB pair
  is unchanged. Rules as drafts F/G. Net class **HV** (VBAT, BUCK_SW): 0.3 mm tracks, 0.15 mm
  clearance (6S). VREG in the Power class (0.3 mm).
- U12: GND pins (3 ILIM, 5 RT, 10) tied straight into the exposed pad, two 0.3 mm vias in the pad to the In1 GND plane;
  VIN pin 7 pre-routed (0.3 mm) to C47.
- Routing (2026-11-02): 1498 tracks, 205 vias, **no via in an SMD pad** (exposed thermal pads of U2 and U12 excepted).
  Locked pre-routes: RF chain, crystal, MCU ground, DFN / VSON details, pogo stubs, IMU fan-out; the rest Freerouting
  plus a grid A* router for the reroutes around J2 and the via-in-pad fixes. Some VSYS / VBUS runs on In2 are 0.2 mm
  (≤ 0.3 A, inner layer); PWM_M2 has one 0.127 mm section between the MCU and R21.

## Checks
- Netlist: 0 errors (`check_net.py`, 91 nets).
- KiCad DRC (`ACwing_FC_A_DRC.rpt`, 2026-11-07): **0 violations, 0 unconnected pads, 0 footprint errors**. Rerun after the 2026-11-08 changes with KiCad 10.0.6: 0 / 0 / 0.
- EMI check (`emi_check.py`): see above.
- Silkscreen: connector labels, + / − at the battery pads, TP1–TP8, logo and board name; no references of passives
  or ICs (they stay on the Fab layer for the assembly drawing). No text over pads or clipped by the mask.

## Fabrication (JLCPCB)
- 4 layers, **1.0 mm** FR-4 (JLC04101H-7628); parts on both sides (top 36, bottom 57).
- **Solder mask (2026-11-02):** JLCPCB keeps a mask dam between pads only if the pad spacing is ≥ 0.19 mm (green,
  blue, red, purple). Board setup: mask expansion **0.05 mm** per side, minimum mask web **0.09 mm** (0.19 − 2 × 0.05),
  so the KiCad DRC flags any pad pair closer than 0.19 mm. All pads pass, except the two DFN-6 LDOs U5 and U11
  (0.4 mm pitch, 0.12 mm gaps, footprint flag "allow solder mask bridges"): JLC opens the mask over the whole pad row
  there (gang relief), which is normal for this package.
- New LCSC parts: **LM5166DRCT C181495** (350 in stock on 2026-10-18: check before ordering), SWPA5040S220MT C68434,
  4.7 µF 50 V 1206 X7R C29823 (Basic), 470 kΩ C25790, 200 kΩ C25764, 10 nF 50 V C15195.
- CPL: rotation corrections learned from the JLC placement previews (2026-10-16 and 2026-10-27, see `generator/cpl.py`).
  Fixed after the 2026-10-27 preview:
  - **bottom side**: JLC mirrors bottom parts about the Y axis and counts the angle from below, so the CPL rotation is
    180° − KiCad rotation + correction (it was KiCad rotation + correction: U10, U11, U13 were 90° / 180° off);
  - U10 WSON-8 270° (bottom → 90), U11 → 90, U13 SOT-353 180° (bottom → 0), U12 VSON-10 0° (→ 90, was 90° off);
  - LEDs D1–D4 (XL-2020 library part) 180°: the DO / DI / + / − marks were 180° off;
  - J1 USB-C: the JLC part origin is the pad-area centre, 1.46 mm behind the KiCad origin (body centre), so the CPL
    position is moved 1.46 mm toward the pins (the receptacle was drawn ~1.5 mm outside the board edge).
  Check the new preview once more before paying: pin-1 dots on U2, U10–U13, the LED marks and J1 on its pads.
- **Cost:** about **29.4 USD per board at 10 boards, 24.6 USD at 100** (components only, 2026-10-27 prices with the
  LPS22HH barometer and the U13 buffer; draft G 26.1 / 20.6). The LM5166
  (3.7 USD) replaces the TPS62160 + charger + charge gate (≈ 2.4 USD).

## To check before ordering
0. **Parts (2026-10-27):** STM32WB55CGU6 out of stock at LCSC/JLC → consigned part (Mouser/DigiKey/ST) or JLC
   Global Sourcing. Barometer changed to **LPS22HHTR** (C2827824, same footprint and pinout as the LPS22HBTR, out of
   stock; firmware: WHO_AM_I 0xB3), low LCSC stock. R40 LCSC number fixed (C25792, 47 kΩ 0402).
   RGB LEDs changed to **XINGLIGHT XL-2020RGBC-WS2812B** (C5349955, same footprint and pinout; WS2812B-2020 out of
   stock). Its VDD minimum is 3.5 V (Worldsemi: 3.3 V), so the Schottky D11 is removed and the LEDs run straight from
   VSYS (3.5–4.2 V on 1S, 4.1 V on 2S–6S, ≈ 4.65 V on USB only; LED max 5.5 V). The LED data line goes through the
   new level-shifting buffer **U13 SN74LV1T34DCKR** (TI, C78541, SC-70-5) powered from VSYS, so the data level is right
   in every supply case (see Power architecture). Check the LED and U13 pin-1 marks in the JLC preview (CPL
   corrections updated after the 2026-10-27 preview).
1. ERC: **done with KiCad 10.0.6 (2026-11-07)**, no real error. The 2 errors are power-flag cases:
   - VREG is driven by the buck through L3 (a passive pin);
   - VLXSMPS (U2 pin 33) is the SMPS switch node, typed power input in the symbol.
   Add a PWR_FLAG on each net to clear them. Warnings: the QSPI flash IO2 / IO3 tied high to the LDO output, and one
   2.54 mm dangling wire stub near U5 OUT (cosmetic). The library warnings come from a KiCad setup without the global
   symbol libraries, not from the design.
2. Stock on 2026-11-07:
   - LM5166DRCR C481392: 2,509 at LCSC (the DRCT reel C181495 had 350 on 2026-10-18);
   - LPS22HHTR C2827824: 70 at LCSC, enough for a first batch but order now;
   - STM32WB55CGU6 C404023: still out of stock at LCSC (extended part, assembly possible): use a consigned part or
     JLC Global Sourcing.
3. Bench test of the buck at 1S (3.0–4.2 V, 100 % duty cycle) and 6S (25.2 V), with the full FC load: VREG ripple
   (PFM, 1.25 A peak) after the LDOs, and LDO dropout at the 1S end of discharge.
4. C6/C46 effective capacitance at 4.1 V (≈ 50 µF together, against ≈ 100 µF asked for PFM by the datasheet
   formula): fine for the LDOs downstream. **Decision (2026-11-07): order as is**, and keep the footprint option of a
   second 22 µF 0805 near L3 for the bench, if the VREG ripple is high (bring-up list, issue #10).
5. Antenna tuning with the board above the ESC; JLC CPL preview (U10–U13, LEDs, J1).

## Contents
| File | What |
|---|---|
| `ACwing_FC_A_pcb.png` | top and bottom renders of the assembled board |
| [`ACwing_FC_A_schematic.pdf`](ACwing_FC_A_schematic.pdf) | schematic |
| [`ACwing_FC_A_pinmap.md`](ACwing_FC_A_pinmap.md) | pin map, ESC links, add-on ports |
| `ACwing_FC_A_BoM.xlsx` | assembly BoM (sheet `BoM`) and costing (sheet `Costing`) |
| `ACwing_FC_A_BoM_JLCPCB.xlsx`, `ACwing_FC_A_CPL.xlsx` | JLCPCB BoM (LCSC part numbers) and pick-and-place with rotation and origin corrections (94 parts) |
| `ACwing_FC_A_gerber.zip` | Gerber (4 copper layers) + Excellon drill files, origin at the lower-left corner: upload as is to JLCPCB |
| `ACwing_FC_A_DRC.rpt` | KiCad DRC report (0 violations, 0 unconnected pads) |
| `ACwing_FC_A.step`, `ACwing_FC_A_3D.png`, `ACwing_FC_A_routing.png` | STEP of the assembled board, 3D renders, copper routing |
| `ACwing_FC_A_outline.dxf` | mechanical outline for the frame design |

KiCad sources in [`01 - FC_KiCadProj/`](../../01%20-%20FC_KiCadProj/):

| File | What |
|---|---|
| `ACwing_FC_A.kicad_pro / .kicad_sch / .kicad_pcb` | KiCad 10 project, schematic, routed PCB |
| `ACwing.kicad_sym`, `ACwing.pretty/`, `3d/` | project library (symbols, footprints incl. the ACwing logos) and STEP models |
| `generator/` | scripts that generated and checked the design (see Regeneration) |

## Regeneration
`generator/build_all_h.sh` (helpers from the draft E generator, Freerouting 1.9 capped at 20 min). The result changes
with any placement change: check the DRC after editing the placement.

> The generator scripts were run in the original build environment: absolute paths inside them (`/home/claude/...`) must be adapted before running them again. The ACwing logos and silkscreen labels were added afterwards with the tools in [`brand/tools`](https://github.com/ACwing-UAV/ACwing/tree/main/brand/tools) of the ACwing system repository.

## Sources
- [TI LM5166 datasheet](https://www.ti.com/lit/ds/symlink/lm5166.pdf), [LCSC C181495](https://www.lcsc.com/product-detail/DC-DC-Converters_TI_LM5166DRCT_LM5166DRCT_C181495.html)
- [TI TPS55165-Q1 datasheet](https://www.ti.com/lit/ds/symlink/tps55165-q1.pdf): rejected, needs VIN ≥ 5.3 V to start (no 1S start)
- [TI LMR36506 datasheet](https://www.ti.com/lit/ds/symlink/lmr36506.pdf): smaller and cheaper, but its 2 × 2 mm VQFN-HR land pattern could not be verified here
- [Sunlord SWPA5040S220MT (JLCPCB C68434)](https://jlcpcb.com/partdetail/Sunlord-SWPA5040S220MT/C68434)
- ST pin data `STM32WB55CGUx.xml` (STM32_open_pin_data) for the alternate functions
