ACwing-UAV/ACwing_HW/00 - Docs/02 - GPS_Docs/README.md

# ACwing GPS rev A – GNSS + compass expansion board for ACwing FC rev A

**Project:** ACwing · **Author:** Andrea Cirillo · **Overview:** [repository README](../../Readme.md)

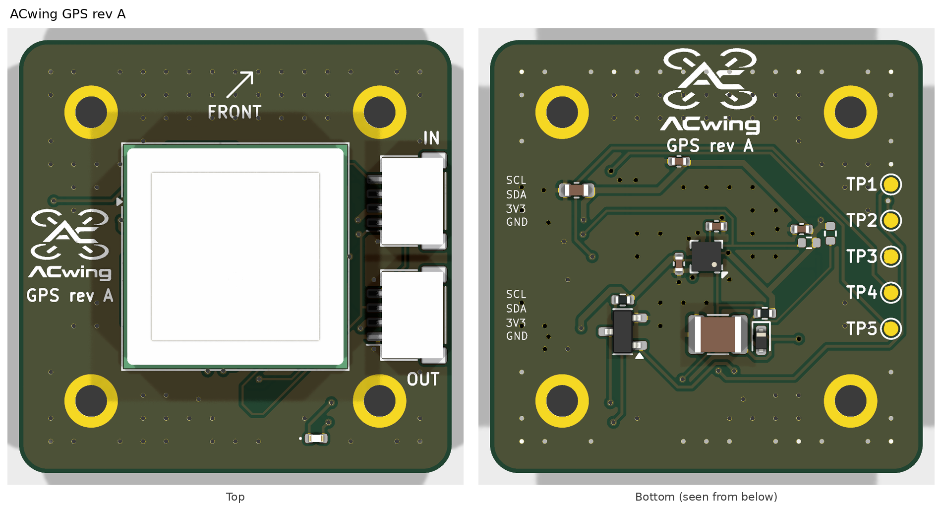
[picture p6: 00 - Docs/02 - GPS_Docs/ACwing_GPS_A_pcb.png]
ACwing_GPS_A


> **Revisions.** Rev A is the first released revision. Earlier letters, marked *draft* in this document (drafts A–C), are internal design iterations that were never manufactured.

> **Silkscreen with connector pin names (2026-11-12, still rev A).** The connector labels now carry the pin names (commit 568e74d). Layout and copper unchanged. `ACwing_GPS_A_pcb.png` and `ACwing_GPS_A_3D.png` regenerated with the KiCad 10.0.6 raytracer (`99 - Tools/outputs/k10_renders.sh`, `compose_board_renders.py`).

> **45° routing (2026-11-08, still rev A).** Every track is now at 0 / 45 / 90° (house rule for all ACwing boards):
> 11 off-angle runs replaced by octilinear doglegs, same end points, pads and vias; 0 segments off 45° left; 8 duplicated segments removed.
> Checked and saved with KiCad 10.0.6: DRC 0 / 0, ERC 0 errors; Gerber, drill, STEP, schematic PDF, DRC report and renders regenerated.

> **Back to 1.0 mm (2026-11-07 evening, still rev A).** To save weight, all ACwing boards are **1.0 mm** again (the
> 1.6 mm step of the same morning is reverted): 2 layers, 0.91 mm core, KiCad 10 files, vias unchanged. Layout unchanged.
> The GPS board sits 1.2 mm lower than with the 1.6 mm boards; 6 mm standoffs unchanged. Board mass −1.0 g. DRC 0 / 0.

> **Layout update (2026-10-24, still rev A).** Qwiic J1 moved from v = 0 to v = +3.6, right above FC J3; re-routed,
> DRC 0. Nothing else changed.

> **Layout and routing update (2026-11-02, still rev A).**
> - **Both Qwiic connectors on the right edge:** J1 IN at (u, v) = (+11.9, +3.85), right above FC J3 (v = +3.6);
>   J2 OUT at (+11.9, −4.05), both mouth +u. Labels "QWIIC IN" / "QWIIC OUT" at the two ends of the connector column.
>   The pass-through cable to the flow board now leaves from the right edge too.
> - No via in an SMD pad; re-routed, DRC 0.
> - Compass U3 (IIS2MDC LGA-12) pads 0.35 × 0.30 mm (were 0.375 × 0.35): every pad gap ≥ 0.19 mm, the JLCPCB
>   minimum for a solder mask dam. Board mask expansion 0.05 mm, minimum web 0.09 mm.
> - Mounting-hole courtyard r 2.0 mm (was 2.45: it blocked the connector column).
> - Silkscreen: connector labels, FRONT arrow, TP1–TP5, logo and board name only.

KiCad 10 project (2026-11-07). A 30 × 30 mm board that stacks on top of the flight controller on the
same **20 × 20 mm** holes, on **6 mm** nylon standoffs. Circuit identical to drafts B/C (Qwiic expansion bus, GNSS on
DDC, compass).

## Changes from draft C
| Draft C | Rev A | Why |
|---|---|---|
| Qwiic J1 / J2 on the bottom side | **J1 / J2 on the top side**: J1 right edge (11.88, **+3.6**, right above FC J3), mouth +u; J2 rear edge (0, −11.88), mouth −v | stack check with mated plugs: on the bottom, the J1 plug sat right above FC rev A J3/J4 and hit them (−0.6 mm at 6 mm standoffs) |
| SAM-M10Q rotated 45° | **SAM-M10Q axis-aligned (0°)**, centred | the 45° module leaves only 4 mm at the edge midpoints; at 0° there are 7.25 mm strips for the connectors |
| 8 mm standoffs needed with FC rev A | **6 mm standoffs** (as designed): bottom side ≤ 1.1 mm (compass, backup, test pads) | stack check: 0 clashes, closest items 0.39 mm (mounting hardware, unchanged) |

Schematic: notes and title block only. Same LCSC parts, same firmware, same compass rotation matrix.

### Notes on the change
- The connectors (2.9 mm) sit 0.6 mm from the module side walls (6.3 mm). They are lower than the antenna top and
  outside the module footprint; GNSS performance should be checked outdoors (C/N0) against draft C.
- Cable: FC J3 (FC top, right edge) → GPS J1 (GPS top, right edge, aligned with FC J3), a short straight loop outside the right edge.
  GPS J2 is a pass-through only: the flow board now has its own FC port (J4).

## Changes from draft A (kept in draft B and C)
| Draft A | Draft B | Why |
|---|---|---|
| JST SH 6-pin link (UART + I2C + VIN) to FC J3 draft D | **two Qwiic ports** (JST SH 4-pin, pass-through): J1 in (right edge), J2 out (rear edge) | draft E has one shared expansion bus for GPS and flow boards; J2 continues the chain down to the flow board |
| GNSS on the FC UART (USART1) | GNSS on **DDC (I2C, 0x42)** on the bus | USART1 is the ELRS port on draft E; u-blox M10 DDC carries the same UBX/NMEA stream |
| UART to the FC | UART on test pads TP4 TXD / TP5 RXD | u-center and firmware updates with a 3.3 V USB-UART |
| AP2112K LDO from FC VSYS | **no LDO**: 3.3 V from the FC expansion LDO (VEXP, 300 mA) | the bus already carries a clean, dedicated 3.3 V rail |
| — | GND fan-out via for every small GND pad | keeps every ground pad tied to the plane when tracks cut the pour |

Unchanged from draft B: IIS2MDC compass at the board centre (bottom), supercap backup (R1, D1, C5),
PPS LED (D2/Q1/R2), safeboot/reset pads, M2 holes and the stack.

## Contents
| File | What |
|---|---|
| `ACwing_GPS_A_pcb.png` | top and bottom renders of the assembled board |
| [`ACwing_GPS_A_schematic.pdf`](ACwing_GPS_A_schematic.pdf) | schematic |
| `ACwing_GPS_A_BoM.xlsx` | assembly BoM (sheet `BoM`) and costing (sheet `Costing`) |
| `ACwing_GPS_A_BoM_JLCPCB.xlsx`, `ACwing_GPS_A_CPL.xlsx` | JLCPCB BoM (LCSC part numbers) and pick-and-place with rotation corrections (15 parts) |
| `ACwing_GPS_A_gerber.zip` | Gerber (2 copper layers) + Excellon drill files, origin at the lower-left corner: upload as is to JLCPCB |
| `ACwing_GPS_A_DRC.rpt` | KiCad DRC report (0 violations, 0 unconnected pads) |
| `ACwing_GPS_A.step`, `ACwing_GPS_A_3D.png` | STEP of the assembled board; 3D renders (top, isometric, bottom) |

KiCad sources in [`03 - GPS_KiCadProj/`](../../03%20-%20GPS_KiCadProj/):

| File | What |
|---|---|
| `ACwing_GPS_A.kicad_pro / .kicad_sch / .kicad_pcb` | KiCad 10 project, schematic, routed PCB |
| `ACwing_GPS.pretty/`, `3d/` | project library (symbols, footprints incl. the ACwing logos) and STEP models |
| `generator/` | scripts that generated and checked the design (see Regeneration) |

## Circuit
- **J1 / J2 (Qwiic).** JST SM04B-SRSS-TB on the top side (rev A), both on the right edge (mouth +X, since
  2026-11-02): J1 IN toward the front, J2 OUT toward the rear. Wired in parallel: 1 GND, 2 3.3 V, 3 SDA, 4 SCL. Standard 1:1 Qwiic cables.
- **3.3 V.** From the bus (FC U11, VEXP 3.31 V). C1 10 µF at the input covers the GNSS start-up inrush (up to 100 mA).
- **GNSS U1, SAM-M10Q-00B.** VCC/V_IO on 3.3 V (C3/C4 100 nF under the pins).
  - DDC (I2C) on the bus: SDA pin 9, SCL pin 12, address 0x42, up to 400 kHz. The FC polls the DDC stream (register
    0xFD/0xFE = bytes available, 0xFF = data).
  - UART TXD/RXD only on TP4/TP5. Default 9600 baud: u-center works directly on the pads.
  - Backup: 3.3 V → R1 1 k → D1 → V_BCKP with C5 CPH3225A (11 mF), about 10 min of hot-start backup.
  - Recovery: TP1 SAFEBOOT_N, TP2 RESET_N, TP3 GND.
- **PPS LED.** D2 (top) driven by Q1 from TIMEPULSE (gate only, no pull-down on the SAFEBOOT strap).
- **Compass U3, IIS2MDCTR.** Bottom side, board centre, on the bus at 0x1E. CS to 3.3 V, C6 220 nF, C7 100 nF.
  R3/R4 4.7 k are DNP (pull-ups are on the FC).
- **Bus map.** GPS 0x42, compass 0x1E, ToF 0x29, flow bridge 0x3B.

### Compass orientation (firmware)
Same as draft A (bottom side, 0°, FC compass top side at 45°):
```
m_fc = R · m_gps,   R = [  0.7071  -0.7071   0 ]
                        [ -0.7071  -0.7071   0 ]
                        [  0        0       -1 ]
```

## Mechanics
- 30 × 30 × 1.0 mm (1.6 mm on 2026-11-07 only), R2 corners, centred on the FC. 4 × M2 (Ø2.2 PTH, 3.6 mm copper ring on both sides tied to GND, since 2026-11-03) on the 20 × 20 pattern, keep-out r 2.6 mm.
- Stack: FC on its grommets → 6 mm gap → GPS board (Mech A1: printed S2 spacer on the M2 screw column, titanium or
  A4 stainless screws, see `04 - System_Docs`). Top of the module ≈ 13.3 mm above the FC top.
- Cables: FC rev A J3 (top, right edge, v = +3.6) → GPS J1 (top, right edge, v = +3.6): the two connectors are
  aligned, the cable goes straight up outside the right edge (layout update 2026-10-24; J1 was at v = 0).
  The flow board has its own FC port (rev A J4); GPS J2 is an optional pass-through.
- Stack check (ACwing ESC 1S A + FC A + GPS A, 6 mm standoffs, all plugs mated): no clash; wherever a GPS bottom part sits above an
  FC rev A top part the vertical gap is ≥ 3.0 mm.
- RF: as draft C, 30 mm ground plane; nothing conductive above the module. The top-side connectors stay lower than the
  module (2.9 vs 6.3 mm).

## PCB
- Rules (JLC 2-layer standard): Default 0.2/0.15 mm, Power (+3V3, GND) 0.4 mm, Fine (I2C, MAG_C1) 0.15 mm with
  0.15 mm clearance (draft B: the I2C runs are longer and pass vias). Vias 0.5/0.3 mm.
- GND pours on both layers, SAM-M10Q ground pads solid to the top pour. 127 GND vias (stitching grid + fan-out).
- Compass escape pre-routed and locked as draft A; the rest autorouted. 208 tracks, 123 vias (2026-11-02), no via in an SMD pad.

## Checks
- Netlist: 0 errors (`check_net.py`, 19 nets).
- KiCad DRC: 0 violations, 0 unconnected pads, 0 footprint errors.
- Silkscreen: QWIIC IN / QWIIC OUT, TP1–TP5, the FRONT arrow, logo and board name (no part references).
- Connectors: J1 at (u, v) = (+11.9, +3.85), J2 at (+11.9, −4.05), both top side, right edge, mouth +u.

## Fabrication (JLCPCB)
- 2 layers, **1.0 mm** FR-4 (0.91 mm core). Parts on both sides (top: U1, D2, J1, J2).
- Solder mask: expansion 0.05 mm, minimum web 0.09 mm, every pad gap ≥ 0.19 mm (JLCPCB dam rule for green / blue / red / purple mask).
- U1 SAM-M10Q and C5 CPH3225A are not stocked by LCSC: consigned parts or hand soldering (as draft A).
- CPL: SOT-23 +180° (Q1). Check U1 pin 1, J1/J2 (tabs toward the edges), C5 polarity and D1 in the JLC preview.
- Cost: about **27.6 USD per board at 10 boards, 23.4 USD at 100** (components only, the SAM-M10Q is ~80 %).

## To check before ordering
1. ERC: **done with KiCad 10.0.6 (2026-11-07): 0 errors** (library warnings only, from the KiCad setup).
2. SAM-M10Q land pattern. u-blox gives the SAM-M10Q as pin- and footprint-compatible with the SAM-M8Q. The
   footprint has 20 pads of 1.5 × 1.8 mm at 1.9 mm pitch on a 15.5 mm body, with the copper / paste keep-out pattern
   under the module, as the SAM-M8Q integration manual. DDC at 400 kHz with the flow board on the bus: bench test,
   issue #10.
3. CPH3225A on the 1210 (3225 metric) footprint: pads 1.15 × 2.7 mm, 2.95 mm apart. Check them against the Seiko
   land pattern in the JLC preview: the part has end terminals and needs no special pad.
4. JLC CPL preview.
5. Compass rotation on the bench.

## Regeneration
`generator/build_all_gps.sh` (uses `kisch.py`, `sexp.py`, `silk_refs.py`, `step_mesh.py` from the FC generator,
`gnd_bridge.py` from the flow generator and `make_3d_e.py`). Freerouting is not deterministic: `loop_route.sh` reruns
it until the DRC is clean.

> The generator scripts were run in the original build environment: absolute paths inside them (`/home/claude/...`) must be adapted before running them again. The ACwing logos and silkscreen labels were added afterwards with the tools in [`brand/tools`](https://github.com/ACwing-UAV/ACwing/tree/main/brand/tools) of the ACwing system repository.
