ACwing-UAV/ACwing_HW/00 - Docs/04 - System_Docs/ACwing_frame_C2_mechanical_answer.md

# ACwing frame C2 – mechanical answer to the electronics handoff

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

**Author:** Andrea Cirillo (ACwing). **From:** mechanical / frame design. **To:** electronics design (ACwing ESC 1S,
ACwing FC, ACwing GPS, ACwing Flow).
**Date:** 2026-10-19. **Answers:** `ACwing_mechanical_handoff.md` (§0.1–0.11, §2–§8) as of 2026-10-19.
**Inputs used:** the stack-check geometry of the GPS rev A package (`stack_data.js`, config D6 = ESC 1S A + FC A + GPS A,
6 mm standoffs), the FC A pin map, the ESC 1S A / Flow A hardware notes and the Flow A DXF.
**Electronics reply:** `ACwing_frame_C2_electronics_reply.md`.

> The frame files listed in §10 (STL, GLB, renders) belong to the frame design and are not part of this repository.

## 0. Decision 2026-10-19 – baseline configuration of the 1S mini drone: indoor, no GPS

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

## 1. What changed in the frame (C → C2)

| Item | Frame C2 | Handoff item |
|---|---|---|
| Stack bosses | 4 bosses on the **20 × 20** pattern (board (±10, ±10) = frame (0, ±14.14), (±14.14, 0)), Ø5.2 top (= ESC keep-out r 2.6), Ø6.6 at the deck, **3 mm** tall: the ESC sits directly on them, at the old FC height (bottom −2.0) | 0.1, 0.2 |
| Fastening | **Hangtife HLTI-M2-001** hot-melt insert (M2 × 3 × Ø3.0) in a Ø2.8 × 3.4 seat in each boss; Ø2.2 clearance below | 0.2 |
| Openings | top bridge removed on **both** ±X sides. The FC USB-C plug (+X) and the ESC 1S A charge-port plug (−X) pass between the two duct rings of that side: the gap between the rings is 13.2 mm, so a plug overmold up to **13.2 mm wide** fits (checked, 0 mm³). The rings are not cut (the 14 mm stack-check envelope with its +1.7 mm side margin would break them). Use slim USB-C cables. | 0.7, 0.10 |
| ESC cable | no frame part behind the rear edge between the board and the M1 duct ring; cable modelled and checked (§4) | 0.3, 0.7 |
| Qwiic slot | new deck slot for the flow cable, board (u 20.4…22.6, v −11.1…−6.9), behind FC J4 | 3 |
| Flow tray | 1.2 mm plate fused under the bay lips (front part of the bay, clear of the rear latch tongue), 2 downward bosses Ø4.8 × 2.4 with the same M2 inserts, lightening window | 2.4 |
| Mass | frame 15.6 g PETG (frame C 14.8 g): +0.8 g for the bosses and the flow plate | 0.3 |

All the frame-C items that do not depend on the stack (cage ducts, motor holders, TPU sleeves, legs, battery bay and
latch, motor-lead clips and deck slots, battery-lead notch) are unchanged. The motor leads still reach the ESC pads at
the edge midpoints exactly as they reached the frame-C FC pads.

## 2. Stack and hardware (per corner, bottom to top)

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

## 3. USB-C access, outline steps, LEDs

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

## 4. Cables (modelled wire by wire, pin 1 to pin 1)

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

- Colours in the model: A = GND black, VBAT red, CUR yellow, TLM white, M1 blue, M2 green, M3 orange, M4 purple;
  Qwiic = GND black, 3V3 red, SDA blue, SCL yellow.
- **Battery pads polarity:** modelled with pad 1 (inboard) = VBAT+ and pad 2 (corner tip) = GND, as the frame-C
  BattPads footprint (confirmed by the electronics reply).
- Cable C stays ≥ 10 mm from the M2 motor leads (§3 rule), and out of the propeller discs and the optical cones.
- Checked: wires × frame, × propellers, × all stack parts, × hardware, × the other cables, × optical cones: **0 mm³**.

## 5. Flow board (§2, §8.1–8.2)

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

## 6. Vibration (FC on the damping balls)

Same beam model as frame C for the isolation modes (it reproduces the frame-C isolation band, 62–95 Hz):

| Grommet stiffness per corner (axial / radial, N/mm) | FC A isolation modes |
|---|---|
| 0.7 / 0.6 (frame-C assumption) | **92–120 Hz** |
| 1.4 / 1.2 (both balls clamped, realistic for this column) | 130–167 Hz |
| 0.45 / 0.4 | 75–96 Hz |

The FC is lighter (≈ 5.5 g against 7.9 g) and the holes are farther out (r 14.1 against 11.3), so the same grommet
gives higher modes than in frame C. With both balls of each grommet working, the band is above the 60–100 Hz target.
**Action:** tap test on the first build (FC IMU at ≥ 1 kHz, FFT); if the peak is above ≈ 110 Hz, use softer (gel)
balls or a longer S1/S2 pair that preloads the balls less. The structural modes of the frame were not re-run with the
frame-C calibration; the structure is unchanged except for the bosses and the flow plate, but the central mass grew by
≈ 14 g, so re-check the frame modes on the bench with the same tap test.

## 7. Weight budget (§0.3)

| Item | g |
|---|---|
| Frame C2 (PETG, from the mesh) | 15.6 |
| TPU sleeves ×4 | 2.2 |
| Battery 1S 20 × 40 × 8 | 20.0 |
| Motors 8520 ×4 | 11.0 |
| Propellers + motor leads | 2.0 |
| ACwing ESC 1S A (doc) | 5.0 |
| ACwing FC A (estimate: 4.0 bare + parts) | 5.5 |
| ACwing GPS A (estimate, SAM-M10Q ≈ 4 g) | 6.0 |
| ACwing Flow A (doc) | 1.5 |
| Cables + PH pigtail | 1.2 |
| 4 × M2 × 16 steel, 6 inserts, 4 grommets, spacers | 3.4 |
| **Total** | **73.2** (frame C: 55.8) |

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

## 8. Larger battery (§6)

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

## 9. ELRS receiver (§4) – proposal, not modelled yet

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

## 10. Files (frame design, not in this repository)

| File | What |
|---|---|
| `C2_frame.stl` | frame C2, PETG, watertight, 15.6 g |
| `C2_spacers_S1x4_S2x4_PETG.stl` | 4 × S1 (2.57 mm) + 4 × S2 (3.57 mm) |
| `Variant_C_sleeve_TPU_x4.stl` | TPU sleeves (unchanged from frame C) |
| `ACwing_C2_assembly_view.glb` | colour assembly (frame, motors, propellers – front ones green, boards, hardware, cables wire by wire) |
| `ACwing_C2_3D_overview.png`, `ACwing_C2_hero.png`, `ACwing_C2_cables.png` | renders |
| `assembly_checks.json` | interference results and cable lengths |
