ACwing-UAV/ACwing_HW/00 - Docs/00 - FC_Docs/ACwing_FC_A_routing.png

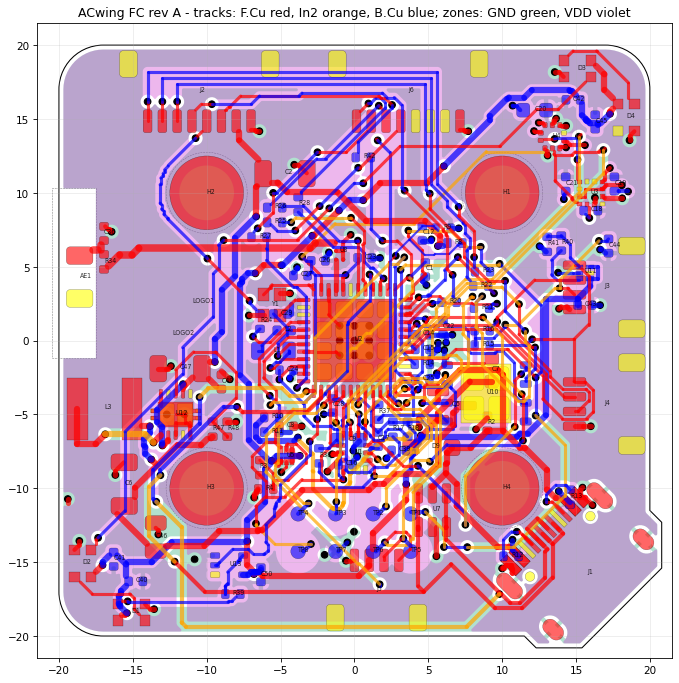
00 - Docs/00 - FC_Docs/ACwing_FC_A_routing.png
