ACwing-UAV/ACwing_HW/00 - Docs/01 - ESC_1S_Docs/ACwing_ESC1S_A_3D.png

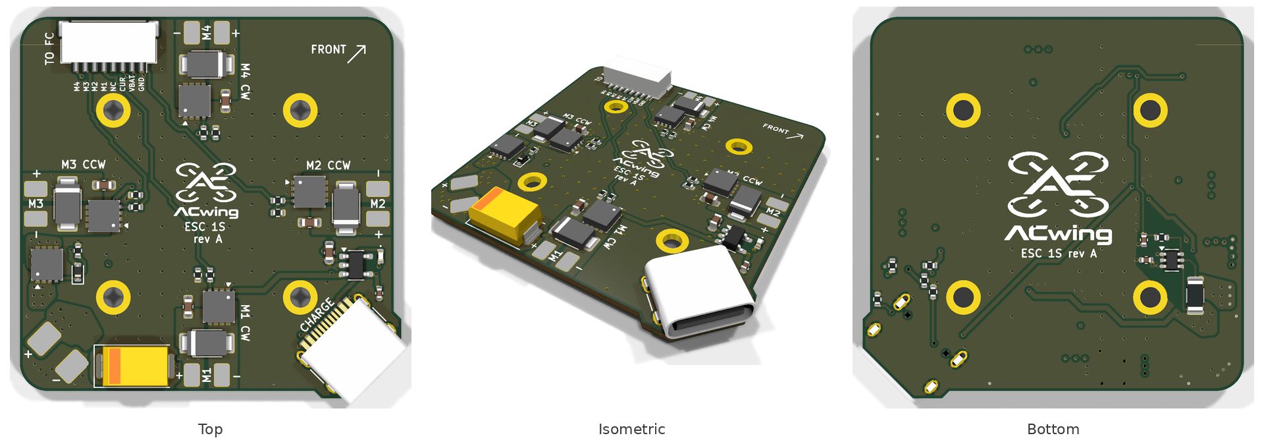
00 - Docs/01 - ESC_1S_Docs/ACwing_ESC1S_A_3D.png
