ACwing-UAV/ACwing_HW/00 - Docs/02 - GPS_Docs/ACwing_GPS_A_3D.png

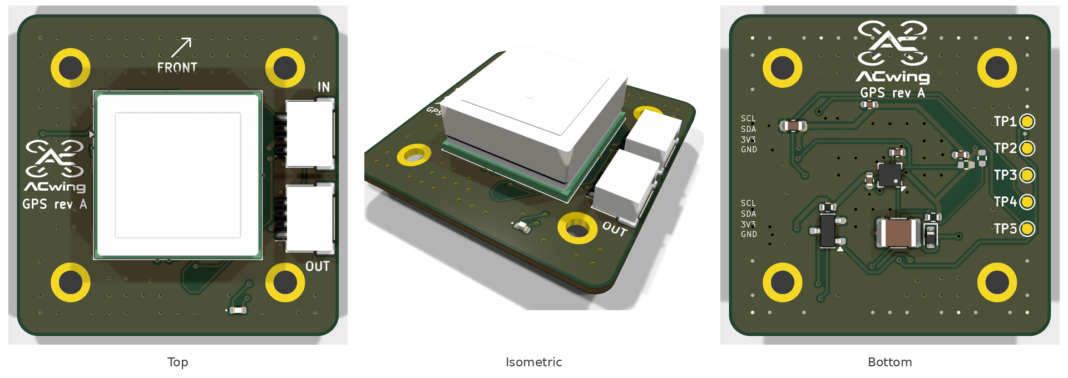
00 - Docs/02 - GPS_Docs/ACwing_GPS_A_3D.png
