ACwing-UAV/ACwing_HW/00 - Docs/03 - FLOW_Docs/ACwing_Flow_A_3D.png

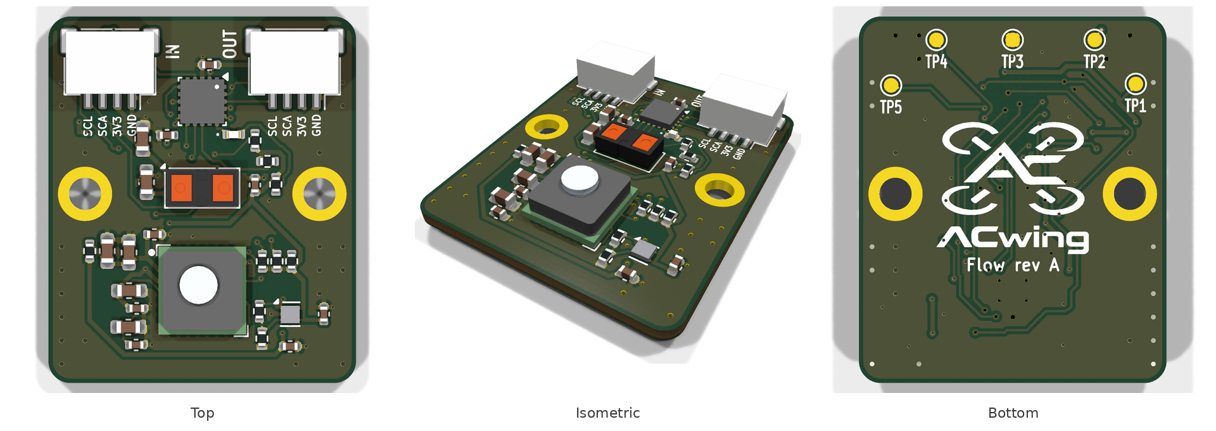
00 - Docs/03 - FLOW_Docs/ACwing_Flow_A_3D.png
