ACwing-UAV/ACwing_HW/00 - Docs/00 - FC_Docs/ACwing_FC_A_BoM.xlsx

ACwing FC rev A - assembly BoM (1 board)
Source: ACwing_FC_A.kicad_sch / ACwing_FC_A.kicad_pcb. MPNs = parts as assembled by JLCPCB (LCSC part numbers checked on 2026-10-16/18); equivalents are noted where they replace the originally specified part.
Item | Quantity | Part Reference | Value | MPN | Manufacturer | LCSC / JLCPCB # | Package | Description | Side | Notes
1 | 1 | AE1 | 2450AT18A0100001E | 2450AT18A0100001E | Johanson Technology | C17430588 | 1206 (3.2 x 1.6 x 1.3 mm) | Chip antenna, 2.4 GHz, 0.5 dBi, 50 Ohm | Top | Johanson global P/N of the legacy 2450AT18A100E (same part). Left board edge, in the copper keep-out; R34 = 0R, C36 not fitted
2 | 19 | C1, C12, C14, C15, C16, C17, C19, C21, C23, C24, C25, C26, C28, C39, C40, C41, C42, C45, C50 | 100nF | CL05B104KO5NNNC | Samsung Electro-Mechanics | C1525 | 0402 (1005 metric) | Capacitor, MLCC, 100 nF, 16 V, X7R, 10% | Bottom | Decoupling (MCU, sensors, NRST). JLC Basic part (replaces Murata GRM155R71C104KA88D)
3 | 2 | C2, C47 | 4.7uF 50V | 1206B475K500NT | FH (Guangdong Fenghua) | C29823 | 1206 (3216 metric), h 1.6 mm | Capacitor, MLCC, 4.7 uF, 50 V, X7R, 10% | Top | VBAT (up to 6S): buck input (C47), ESC link A (C2). JLC Basic part
4 | 1 | C6 | 100uF 6.3V | CL31A107MQHNNNE | Samsung Electro-Mechanics | C15008 | 1206 (3216 metric), h 1.6 mm | Capacitor, MLCC, 100 uF, 6.3 V, X5R, 20% | Top | Buck output (VREG). Replaces Murata GRM31CR60J107ME39L
5 | 1 | C7 | 4.7uF | CL10A475KO8NNNC | Samsung Electro-Mechanics | C19666 | 0603 (1608 metric), h 0.8 mm | Capacitor, MLCC, 4.7 uF, 16 V, X5R, 10% | Top | VSYS (C7) and MCU VDD bulk (C9). JLC Basic part, 16 V rating (replaces Murata GRM188R61A475KE15D)
6 | 1 | C8 | 1uF | CL05A105KA5NQNC | Samsung Electro-Mechanics | C52923 | 0402 (1005 metric) | Capacitor, MLCC, 1 uF, 25 V, X5R, 10% | Top | LDO output (C8), VDDA (C22). JLC Basic part (replaces Murata GRM155R61A105KE15D)
7 | 1 | C9 | 4.7uF | CL10A475KO8NNNC | Samsung Electro-Mechanics | C19666 | 0603 (1608 metric), h 0.8 mm | Capacitor, MLCC, 4.7 uF, 16 V, X5R, 10% | Bottom | VSYS (C7) and MCU VDD bulk (C9). JLC Basic part, 16 V rating (replaces Murata GRM188R61A475KE15D)
8 | 1 | C18 | 220nF | CL05B224KO5NNNC | Samsung Electro-Mechanics | C16772 | 0402 (1005 metric) | Capacitor, MLCC, 220 nF, 16 V, X7R, 10% | Bottom | IIS2MDC C1 (ESR < 200 mOhm). Replaces Murata GRM155R71C224KA12D
9 | 1 | C20 | 10uF 6.3V | CL10A106KP8NNNC | Samsung Electro-Mechanics | C19702 | 0603 (1608 metric), h 0.8 mm | Capacitor, MLCC, 10 uF, 10 V, X5R, 10% | Bottom | VDD bulk, bottom side. JLC Basic part, 10 V rating (replaces Murata GRM188R60J106ME47D)
10 | 2 | C22, C43 | 1uF | CL05A105KA5NQNC | Samsung Electro-Mechanics | C52923 | 0402 (1005 metric) | Capacitor, MLCC, 1 uF, 25 V, X5R, 10% | Bottom | LDO output (C8), VDDA (C22). JLC Basic part (replaces Murata GRM155R61A105KE15D)
11 | 1 | C27 | 100pF | 0402CG101J500NT | FH (Guangdong Fenghua) | C1546 | 0402 (1005 metric) | Capacitor, MLCC, 100 pF, 50 V, C0G, 5% | Bottom | VDDRF high-frequency decoupling. JLC Basic part (replaces Murata GRM1555C1H101JA01D)
12 | 1 | C29 | 4.7uF | CL05A475MP5NRNC | Samsung Electro-Mechanics | C23733 | 0402 (1005 metric) | Capacitor, MLCC, 4.7 uF, 10 V, X5R, 20% | Bottom | SMPS output (VFBSMPS). Replaces Murata GRM155R61A475MEAAD
13 | 1 | C44 | 2.2uF | CL05A225MQ5NSNC | Samsung Electro-Mechanics | C12530 | 0402 (1005 metric) | Capacitor, MLCC, 2.2 uF, 6.3 V, X5R, 20% | Bottom | Expansion LDO output (VEXP). JLC Basic part
14 | 1 | C46 | 22uF 25V | CL21A226MAQNNNE | Samsung Electro-Mechanics | C45783 | 0805 (2012 metric), h 1.25 mm | Capacitor, MLCC, 22 uF, 25 V, X5R, 20% | Top | Buck output (with C6). JLC Basic part
15 | 1 | C49 | 10nF | CL05B103KB5NNNC | Samsung Electro-Mechanics | C15195 | 0402 (1005 metric) | Capacitor, MLCC, 10 nF, 50 V, X7R, 10% | Top | -. JLC Basic part
16 | 4 | D1, D2, D3, D4 | XL-2020RGBC-WS2812B | XL-2020RGBC-WS2812B | XINGLIGHT | C5349955 | 2.0 x 2.0 x 0.65 mm, 4 pad (WS2812B-2020 footprint and pinout) | LED, RGB addressable, integrated driver, 2.0 x 2.0 mm | Top | Status LEDs D1 rear, D2 left, D3 front, D4 right: one chain from PA7 (TIM17_CH1 + DMA); D3 / D4 supply pins face away from the magnetometer. VDD 3.5-5.5 V, supplied from VSYS; data through the U13 buffer (replaces WS2812B-2020, out of stock)
17 | 1 | D9 | PMEG2010AEH | PMEG2010AEH,115 | Nexperia | C110921 | SOD-123F | Diode, Schottky, 20 V, 1 A, Vf ~0.35 V | Top | USB VBUS -> VSYS
18 | 1 | J1 | USB-C (HRO TYPE-C-31-M-12) | TYPE-C-31-M-12 | HRO (Korea Hroparts) | C165948 | USB-C receptacle, 16 pin, SMD + THT shell | Connector, USB Type-C receptacle, USB 2.0, top mount | Top | Mouth 0.35 mm past the right-corner chamfer
19 | 1 | J2 | ESC link | SM08B-SRSS-TB(LF)(SN) | JST | C160407 | JST SH 8P side entry, h 2.9 mm | Connector, JST SH, 8 positions, 1.0 mm pitch, side entry | Top | ESC links (top side): J2 ESC A rear edge (power, CUR, M1-M4); J6 ESC B front edge next to J5 (M5-M8)
20 | 2 | J3, J4 | Qwiic | SM04B-SRSS-TB(LF)(SN) | JST | C160404 | JST SH 4P side entry, SMD, h 2.9 mm | Connector, JST SH, 4 positions, 1.0 mm pitch, side entry, SMD | Top | Qwiic / STEMMA QT expansion port (GPS, flow): 1 GND, 2 3.3 V, 3 SDA, 4 SCL. Qwiic / STEMMA QT expansion port
21 | 1 | J5 | ELRS | SM04B-SRSS-TB(LF)(SN) | JST | C160404 | JST SH 4P side entry, SMD, h 2.9 mm | Connector, JST SH, 4 positions, 1.0 mm pitch, side entry, SMD | Top | ELRS receiver port (CRSF, USART1): 1 GND, 2 VSYS, 3 RX, 4 TX. ELRS receiver port (CRSF)
22 | 1 | J6 | ESC link B | SM08B-SRSS-TB(LF)(SN) | JST | C160407 | JST SH 8P side entry, h 2.9 mm | Connector, JST SH, 8 positions, 1.0 mm pitch, side entry | Top | ESC link B (M5-M8), top side, front edge next to the ELRS port J5, mouth toward the front
23 | 1 | L1 | 2.2uH | MPH201210S2R2MT | Sunlord | C55755 | 0805 (2012 metric), h 1.0 mm | Inductor, multilayer power, 2.2 uH, 20%, 420 mA, DCR 0.25 Ohm, 2.0 x 1.2 x 1.0 mm | Bottom | SMPS inductor for the 8 MHz SMPS clock (DS13252 table 6). SMPS inductor, 8 MHz SMPS clock; replaces Wurth 74479774222 (not at LCSC)
24 | 1 | L2 | 10nH | LQG15HS10NJ02D | Murata | C77103 | 0402 (1005 metric) | Inductor, multilayer, 10 nH, 5%, 500 mA | Bottom | SMPS output filter, AN5290. Replaces LQG15WZ10NJ02D (same value, LCSC stocked)
25 | 1 | L3 | 22uH | SWPA5040S220MT | Sunlord | C68434 | SMD 5 x 5 x 4 mm, shielded | Inductor, shielded power, 22 uH, 20%, Irated 1.5 A, Isat 1.9 A, DCR 168 mOhm, 5 x 5 x 4 mm | Top | Input buck inductor (top, left edge, ~41 mm from the magnetometer)
26 | 1 | Q5 | AO3401A | AO3401A | Alpha & Omega Semiconductor | C15127 | SOT-23 | MOSFET, P-channel, 30 V, 4 A | Top | Battery/USB load sharing
27 | 1 | R2 | 100k | 0402WGF1003TCE | UNI-ROYAL | C25741 | 0402 (1005 metric) | Resistor, 100 kOhm, 1%, 1/16 W | Top | Q5 gate pull-down (R2), VBUS sense divider (R10, R11). JLC Basic part
28 | 1 | R3 | 287k 1% | RC-02K2873FT | FH (Guangdong Fenghua) | C42921050 | 0402 (1005 metric) | Resistor, 287 kOhm, 1%, 1/16 W | Top | LDO feedback (VOUT = 3.10 V)
29 | 1 | R4 | 100k 1% | 0402WGF1003TCE | UNI-ROYAL | C25741 | 0402 (1005 metric) | Resistor, 100 kOhm, 1%, 1/16 W | Top | LDO feedback (R4), VBAT sense divider top (R8). JLC Basic part
30 | 1 | R8 | 100k 1% | 0402WGF1003TCE | UNI-ROYAL | C25741 | 0402 (1005 metric) | Resistor, 100 kOhm, 1%, 1/16 W | Bottom | LDO feedback (R4), VBAT sense divider top (R8). JLC Basic part
31 | 4 | R9, R14, R37, R38 | 10k | 0402WGF1002TCE | UNI-ROYAL | C25744 | 0402 (1005 metric) | Resistor, 10 kOhm, 1%, 1/16 W | Bottom | BOOT0 pull-down (R14), FLASH_CS / IMU_CS pull-ups (R37, R38), VBAT sense divider bottom (R9). JLC Basic part
32 | 2 | R10, R11 | 100k | 0402WGF1003TCE | UNI-ROYAL | C25741 | 0402 (1005 metric) | Resistor, 100 kOhm, 1%, 1/16 W | Bottom | Q5 gate pull-down (R2), VBUS sense divider (R10, R11). JLC Basic part
33 | 2 | R12, R13 | 5.1k | 0402WGF5101TCE | UNI-ROYAL | C25905 | 0402 (1005 metric) | Resistor, 5.1 kOhm, 1%, 1/16 W | Bottom | USB-C CC pull-downs. JLC Basic part
34 | 2 | R15, R16 | 2.2k | 0402WGF2201TCE | UNI-ROYAL | C25879 | 0402 (1005 metric) | Resistor, 2.2 kOhm, 1%, 1/16 W | Bottom | I2C1 pull-ups. JLC Basic part
35 | 2 | R17, R18 | 4.7k | 0402WGF4701TCE | UNI-ROYAL | C25900 | 0402 (1005 metric) | Resistor, 4.7 kOhm, 1%, 1/16 W | Bottom | Sensor hub pull-ups. JLC Basic part
36 | 9 | R20, R21, R22, R23, R24, R25, R26, R27, R28 | 100R | 0402WGF1000TCE | UNI-ROYAL | C25076 | 0402 (1005 metric) | Resistor, 100 Ohm, 1%, 1/16 W | Bottom | ESC link series resistors (M1-M8, TLM). JLC Basic part
37 | 1 | R34 | 0R | 0402WGF0000TCE | UNI-ROYAL | C17168 | 0402 (1005 metric) | Resistor, 0 Ohm jumper, 1/16 W | Top | R34: antenna tuning, series position (replace with L/C after tuning). JLC Basic part
38 | 1 | R39 | 33R | 0402WGF330JTCE | UNI-ROYAL | C25105 | 0402 (1005 metric) | Resistor, 33 Ohm, 1%, 1/16 W | Bottom | RGB data line series resistor. JLC Basic part
39 | 1 | R40 | 47k 1% | 0402WGF4702TCE | UNI-ROYAL | C25792 | 0402 (1005 metric) | Resistor, 47 kOhm, 1%, 1/16 W | Bottom | VEXP divider, top. JLC Basic part
40 | 1 | R41 | 15k 1% | 0402WGF1502TCE | UNI-ROYAL | C25756 | 0402 (1005 metric) | Resistor, 15 kOhm, 1%, 1/16 W | Bottom | VEXP divider, bottom. JLC Basic part
41 | 1 | R42 | 1k | 0402WGF1001TCE | UNI-ROYAL | C11702 | 0402 (1005 metric) | Resistor, 1 kOhm, 1%, 1/16 W | Bottom | ADC RC on ESC_CUR (R42). JLC Basic part
42 | 1 | R47 | 470k 1% | 0402WGF4703TCE | UNI-ROYAL | C25790 | 0402 (1005 metric) | Resistor, 470 kOhm, 1%, 1/16 W | Top | VBAT sense divider. JLC Basic part
43 | 1 | R48 | 200k 1% | 0402WGF2003TCE | UNI-ROYAL | C25764 | 0402 (1005 metric) | Resistor, 200 kOhm, 1%, 1/16 W | Top | Buck feedback, bottom. JLC Basic part
44 | 1 | U1 | LSM6DSV16X | LSM6DSV16XTR | STMicroelectronics | C5267406 | LGA-14, 2.5 x 3 x 0.83 mm | IMU, 6-axis (accelerometer + gyroscope), I2C/I3C/SPI, sensor hub | Top | Top, just south of the centred MCU (0, -7.6), rotated 270 deg (remap the axes in firmware); SPI1, shared with the log flash
45 | 1 | U2 | STM32WB55CGU6 | STM32WB55CGU6 | STMicroelectronics | C404023 | UFQFPN-48, 7 x 7 x 0.55 mm, EP 5.6 mm | MCU, Cortex-M4 + M0+ radio core, BLE 5 / 802.15.4, 1 MB flash, 256 KB RAM, SMPS | Top | EP to GND through a 3x3 via array. Out of stock at LCSC/JLC (2026-10-27): consigned part (buy at Mouser/DigiKey/ST and ship to JLC) or JLC Global Sourcing
46 | 1 | U3 | IIS2MDC | IIS2MDCTR | STMicroelectronics | C2655002 | LGA-12, 2 x 2 x 0.7 mm | Magnetometer, 3-axis, +-50 gauss, 16 bit, I2C/SPI, industrial grade (LIS2MDL-compatible) | Top | Front corner; read through the LSM6DSV16X sensor hub, address 0x1E
47 | 1 | U4 | LPS22HH | LPS22HHTR | STMicroelectronics | C2827824 | HLGA-10, 2 x 2 x 0.73 mm | Pressure sensor (barometer), 260-1260 hPa, I2C/SPI, 24-bit | Top | Altitude hold; address 0x5D (WHO_AM_I 0xB3). Keep the vent hole clear. Replaces LPS22HBTR (out of stock): same HLGA-10 2 x 2 footprint and pinout; low LCSC stock on 2026-10-27, check before ordering
48 | 1 | U5 | LD39130SPUR | LD39130SPUR | STMicroelectronics | C2798213 | DFN-6, 1.2 x 1.3 mm | LDO regulator, adjustable, 300 mA, 1 uA quiescent | Top | Set to 3.10 V by R3/R4
49 | 1 | U7 | USBLC6-2SC6 | USBLC6-2SC6 | STMicroelectronics | C7519 | SOT-23-6 | ESD protection, 2-line, low capacitance, for USB 2.0 | Top | Next to the USB-C connector
50 | 1 | U8 | MLPF-WB55-01E3 | MLPF-WB55-01E3 | STMicroelectronics | C2651048 | CSP-6 (bumps), 1.0 x 1.6 mm approx., pitch 0.5 mm | 2.4 GHz low-pass filter with integrated impedance matching for STM32WB55 RF1 | Top | Between U2 RF1 and the antenna feed (AN5290 IPD BoM)
51 | 1 | U10 | W25Q128JV | W25Q128JVPIQ | Winbond | C190862 | WSON-8, 6 x 5 x 0.75 mm | NOR flash, 128 Mbit (16 MB), SPI/QSPI 133 MHz, WSON-8 6x5 mm | Bottom | Flight log (blackbox); SPI1, CS PE4; bottom side
52 | 1 | U11 | LDK130PU-R | LDK130PU-R | STMicroelectronics | C157446 | DFN-6, 1.2 x 1.3 mm | LDO, adjustable 0.8-5.1 V, 300 mA, DFN-6 1.2 x 1.3 mm | Bottom | Expansion bus 3.3 V (VEXP), set to 3.31 V by R40/R41. Set to 3.31 V by R40/R41 (47k/15k)
53 | 1 | U12 | LM5166DRCT | LM5166DRCT | Texas Instruments | C181495 | VSON-10 (DRC), 3 x 3 mm | Step-down converter, 3-65 V in, 500 mA, PFET high side (100% duty cycle), VSON-10 3x3 | Top | 1S-6S input buck: VREG = 4.1 V (about VBAT on 1S). 350 in stock at LCSC on 2026-10-18: check before ordering
54 | 1 | U13 | SN74LV1T34DCKR | SN74LV1T34DCKR | Texas Instruments | C78541 | SC-70-5 (SOT-353) | Single buffer, single supply 1.6-5.5 V, TTL-level inputs (VIH 2.0 V at 5 V), 5 V tolerant, SC-70-5 | Bottom | LED data level shifter: PA7 (3.1-3.3 V) -> VSYS level for the LED chain; VCC = VSYS, C50 decoupling; bottom side. LED data level shifter; ~24k in stock at LCSC on 2026-10-27
55 | 1 | Y1 | 32MHz | NX2016SA-32MHZ-STD-CZS-5 | NDK | C843260 | SMD 2016, 4 pad, 2.0 x 1.6 mm | Crystal, 32 MHz, 8 pF, +-10 ppm, SMD 2016, HSE for the STM32WB radio | Top | No load capacitors: internal HSE trimming (AN5042). Also the RF wake-up (HSE/1024) and RTC (HSE/32) clock: no LSE. Same NDK NX2016SA family and load capacitance (8 pF) as the ST-listed EXS00A-CS06654; no load capacitors (internal HSE trimming)
Total |  | Total placements (assembled parts) | - |  | line items (unique MPN / side) | - | - | - | - | Not-assembled items listed below
Not assembled (PCB features / off-board)
Item | Quantity | Part Reference | Value | MPN | Manufacturer | LCSC / JLCPCB # | Package | Description | Side | Notes
NA1 | 8 | TP1, TP2, TP3, TP4, TP5, TP6, TP7, TP8 | pogo pad | N/A (PCB feature) | N/A | N/A | TestPoint_Pad_D1.0mm: 1.0 mm round SMD pad | Programming / debug pads, 2 x 4 grid at 2.54 mm pitch | Bottom | Row 1: SWDIO, SWCLK, NRST, BOOT0; row 2: VDD, GND, CRSF_TX, CRSF_RX (USART1, PB6/PB7). Use a 2.54 mm pogo-pin fixture
NA2 | 4 | H1, H2, H3, H4 | D3.2 PTH | N/A (PCB feature) | N/A | N/A | Grommet_PTH_3.2mm_Pad5.0mm: plated 3.2 mm hole, 5.0 mm ring | Mounting holes for M2 anti-vibration grommets, 20 x 20 mm pattern | Both (plated through) | Exposed 5.0 mm GND copper ring on both sides (grommet seat). Grommets supplied with the frame
NA3 | 1 | C36 | DNP | TBD after VNA tuning (C0G capacitor or chip inductor) | Murata (GRM1555C1H C0G or LQG15HS series) | - | 0402 (1005 metric) | Antenna tuning, shunt position at the antenna side | Top | Do not populate. Fit only if the VNA measurement asks for it; R34 (series) is the other tuning spot
