ACwing-UAV/ACwing_HW/00 - Docs/01 - ESC_1S_Docs/ACwing_ESC1S_A_BoM.xlsx

Sheet: BoM
ACwing ESC 1S rev A - assembly BoM (1 board)
Source: ACwing_ESC1S_A.kicad_sch / ACwing_ESC1S_A.kicad_pcb. LCSC part numbers from the draft E FC BoM (2026-10-15/17); J1 C160407, rev B parts (Q5 AON7423 C99711, U2 STC4054GR C262930, J4 TYPE-C-31-M-12 C165948) checked 2026-10-18. D1-D4: SS34F fitted in place of STPS3L45AF (same outline).
Item | Quantity | Part Reference | Value | MPN | Manufacturer | LCSC / JLCPCB # | Package | Description | Side | Notes
1 | 1 | C1 | 470uF 6.3V polymer | T520D477M006ATE015 | KEMET | C696809 | 7343-31 (EIA D), h 2.8 mm | Capacitor, tantalum polymer, 470 uF, 6.3 V, 15 mOhm | Top | Bulk at the battery entry, + to VBAT. Low LCSC stock: any 470 uF 6.3 V 7343 polymer fits
2 | 4 | C2, C3, C4, C5 | 10uF 10V | CL10A106KP8NNNC | Samsung Electro-Mechanics | C19702 | 0603 (1608 metric) | Capacitor, MLCC, 10 uF, 10 V, X5R | Top | Local decoupling next to each MOSFET (hot loop)
3 | 2 | C6, C7 | 100nF | CL05B104KO5NNNC | Samsung Electro-Mechanics | C1525 | 0402 (1005 metric) | Capacitor, MLCC, 100 nF, 16 V, X7R | Bottom | U1 supply (C7) and CUR filter (C6)
4 | 1 | C8 | 1uF | CL05A105KA5NQNC | Samsung Electro-Mechanics | C52923 | 0402 (1005 metric) | Capacitor, MLCC, 1 uF, 25 V, X5R | Top | Charger input (VBUS)
5 | 1 | C9 | 4.7uF 10V | CL10A475KO8NNNC | Samsung Electro-Mechanics | C19666 | 0603 (1608 metric) | Capacitor, MLCC, 4.7 uF, 16 V, X5R | Top | Charger output RC (with R16)
6 | 4 | D1, D2, D3, D4 | STPS3L45AF | SS34F | GOODWORK | C908669 | SMAF (DO-221AC) | Diode, Schottky, 40 V, 3 A, Vf 0.55 V @ 3 A | Top | Motor freewheel diode. Replaces STPS3L45AF (low LCSC stock), same DO-221AC outline. Cathode to VBAT
7 | 1 | D5 | RB521S30 | RB521S30T1G | onsemi | C8523 | SOD-523 | Diode, Schottky, 30 V, 200 mA | Top | VBUS -> Q5 gate (charge switch off while charging)
8 | 1 | D6 | green | XL-1005UGC | XINGLIGHT | C965793 | 0402 (1005 metric) | LED, green 525 nm, 0402 | Top | Charge LED (on = charging), top side next to the charge port
9 | 1 | J1 | ESC link | SM08B-SRSS-TB(LF)(SN) | JST | C160407 | JST SH 8P side entry, h 2.9 mm | Connector, JST SH, 8 positions, 1.0 mm pitch, side entry | Top | ESC link to the FC: 1 GND, 2 VBAT, 3 CUR, 4 TLM (n.c.), 5-8 M1-M4. Mouth at the rear edge
10 | 1 | J4 | USB-C (HRO TYPE-C-31-M-12) | TYPE-C-31-M-12 | HRO (Korea Hroparts) | C165948 | USB-C receptacle, 16 pin, SMD + THT shell | Connector, USB Type-C receptacle, top mount | Top | Charge port (power only), front-left chamfer
11 | 4 | Q1, Q2, Q3, Q4 | AON7524 | AON7524 | Alpha & Omega Semiconductor | C431195 | DFN 3x3 EP (DFN3x3A_8L_EP1) | MOSFET, N-channel, 30 V, 30 A, logic level | Top | Low-side motor switch, one per channel. Land pattern: Vishay PowerPAK 1212-8 (check against the AOS drawing)
12 | 1 | Q5 | AON7423 | AON7423 | Alpha & Omega Semiconductor | C99711 | DFN 3x3 EP | MOSFET, P-channel, 20 V, 50 A, 4.9 mOhm @ -2.5 V, Vgs +-8 V | Top | Charge switch Q5: board supply off while the charge port is plugged in
13 | 4 | R1, R2, R3, R4 | 22R | 0402WGF220JTCE | UNI-ROYAL | C25092 | 0402 (1005 metric) | Resistor, 22 Ohm, 5 %, 1/16 W | Top | MOSFET gate resistors
14 | 5 | R5, R6, R7, R8, R11 | 100k | 0402WGF1003TCE | UNI-ROYAL | C25741 | 0402 (1005 metric) | Resistor, 100 kOhm, 1 %, 1/16 W | Top | Gate pull-downs: MOSFETs off with the cable unplugged or the FC booting (R5-R8); Q5 gate pull-down (R11)
15 | 1 | R9 | 2m | RLM12FTCMR002 | TA-I Tech | C710257 | 1206 (3216 metric) | Resistor, current sense, 2 mOhm, 1 %, 1 W | Bottom | Battery shunt, bottom side, Kelvin-connected to U1
16 | 2 | R10, R15 | 1k | 0402WGF1001TCE | UNI-ROYAL | C11702 | 0402 (1005 metric) | Resistor, 1 kOhm, 1 %, 1/16 W | Bottom | CUR filter (1k / 100 nF, 1.6 kHz) (R10); charge LED (R15)
17 | 2 | R12, R13 | 5.1k | 0402WGF5101TCE | UNI-ROYAL | C25905 | 0402 (1005 metric) | Resistor, 5.1 kOhm, 1 %, 1/16 W | Bottom | USB-C CC pull-downs (sink)
18 | 1 | R14 | 2.2k 1% | 0402WGF2201TCE | UNI-ROYAL | C25879 | 0402 (1005 metric) | Resistor, 2.2 kOhm, 1 %, 1/16 W | Bottom | Charger R_PROG: 455 mA
19 | 1 | R16 | 1R | FRC0402F1R00TS | FOJAN | C2909329 | 0402 (1005 metric) | Resistor, 1 Ohm, 1 %, 1/16 W | Bottom | Charger output RC (with C9)
20 | 1 | U1 | TSC213 | TSC213ICT | STMicroelectronics | C1858319 | SC70-6 (SOT-363) | Current-sense amplifier, gain 50 V/V, zero drift | Bottom | Battery current: CUR = 0.1 V/A on J1 pin 3
21 | 1 | U2 | STC4054GR | STC4054GR | STMicroelectronics | C262930 | TSOT-23-5 | Li-ion linear charger, 4.2 V, up to 800 mA | Top | 1S charger, 455 mA (R14 2.2k)
Total |  | Total placements (assembled parts) | - |  | line items | - | - | - | - | Not-assembled items listed below
Not assembled (PCB features / DNP)
Item | Quantity | Part Reference | Value | MPN | Manufacturer | LCSC / JLCPCB # | Package | Description | Side | Notes
NA1 | 4 | H1, H2, H3, H4 | M2 | N/A (PCB feature) | N/A | N/A | NPTH 2.2 mm | Mounting hole, M2, 20 x 20 pattern | Top | Hard mount to the frame bosses; keep-out r 2.6 mm on both sides
NA2 | 4 | M1, M2, M3, M4 | coreless 8520 | N/A (PCB feature) | N/A | N/A | MotorPads_1x02_SMD | Motor lead solder pads (8.5 x 20 mm coreless brushed motors, 3.7 V) | Top | Soldered by hand; "+" pad (silk mark) to the red/blue lead. M1/M4 CW, M2/M3 CCW
NA3 | 1 | J2 | BATT 1S | N/A (PCB feature) | N/A | N/A | BattPads_1x02_SMD | Battery lead solder pads, 1S LiPo, AWG 22-24 | Top | Rear corner; "+" silk mark on the VBAT pad
NA4 | 1 | - (soldered to J2) | JST PH 2.0 pigtail | PH 2.0 male lead, 30-40 mm, 24 AWG (any brand) | N/A | N/A | off-board | Battery plug pigtail soldered to J2 (rated 2 A) | Top | Hand-soldered: red to +. Match the polarity of the battery plug (not standardised)

Sheet: Costing
ACwing ESC 1S rev A - component costing (assembled parts, USD)
Blue = input prices; black = formulas. "Estimate" rows are typical distributor prices, not quotes. PCB (4 layers), assembly fees, motors and the 8-pin cable are not included.
References | Qty / board | MPN | Source | Unit price @10 boards | Unit price @100 boards | Cost / board @10 | Cost / board @100 | Price basis
C1 | 1 | T520D477M006ATE015 | C696809 | $1.631 | $1.265 |  |  | LCSC quote
C2, C3, C4, C5 | 4 | CL10A106KP8NNNC | C19702 | $0.029 | $0.029 |  |  | LCSC quote
C6, C7 | 2 | CL05B104KO5NNNC | C1525 | $0.005 | $0.005 |  |  | LCSC quote
C8 | 1 | CL05A105KA5NQNC | C52923 | $0.007 | $0.007 |  |  | LCSC quote
C9 | 1 | CL10A475KO8NNNC | C19666 | $0.021 | $0.016 |  |  | LCSC quote
D1, D2, D3, D4 | 4 | SS34F | C908669 | $0.033 | $0.033 |  |  | LCSC quote
D5 | 1 | RB521S30T1G | C8523 | $0.030 | $0.020 |  |  | Estimate
D6 | 1 | XL-1005UGC | C965793 | $0.012 | $0.008 |  |  | Estimate
J1 | 1 | SM08B-SRSS-TB(LF)(SN) | C160407 | $0.350 | $0.250 |  |  | Estimate
J4 | 1 | TYPE-C-31-M-12 | C165948 | $0.173 | $0.137 |  |  | LCSC quote
Q1, Q2, Q3, Q4 | 4 | AON7524 | C431195 | $0.232 | $0.178 |  |  | LCSC quote
Q5 | 1 | AON7423 | C99711 | $0.899 | $0.766 |  |  | LCSC quote
R1, R2, R3, R4 | 4 | 0402WGF220JTCE | C25092 | $0.002 | $0.002 |  |  | Estimate
R5, R6, R7, R8, R11 | 5 | 0402WGF1003TCE | C25741 | $0.002 | $0.002 |  |  | Estimate
R9 | 1 | RLM12FTCMR002 | C710257 | $0.048 | $0.039 |  |  | LCSC quote
R10, R15 | 2 | 0402WGF1001TCE | C11702 | $0.002 | $0.002 |  |  | Estimate
R12, R13 | 2 | 0402WGF5101TCE | C25905 | $0.002 | $0.002 |  |  | Estimate
R14 | 1 | 0402WGF2201TCE | C25879 | $0.002 | $0.002 |  |  | Estimate
R16 | 1 | FRC0402F1R00TS | C2909329 | $0.003 | $0.002 |  |  | Estimate
U1 | 1 | TSC213ICT | C1858319 | $0.600 | $0.450 |  |  | Estimate
U2 | 1 | STC4054GR | C262930 | $1.447 | $1.096 |  |  | LCSC quote
Total per board
