ACwing-UAV/ACwing_HW/00 - Docs/02 - GPS_Docs/ACwing_GPS_A_BoM.xlsx

Sheet: BoM
ACwing GPS rev A - assembly BoM (1 board)
Source: ACwing_GPS_A.kicad_sch / ACwing_GPS_A.kicad_pcb. LCSC part numbers checked on 2026-10-17. U1 and C5 are not stocked by LCSC: consigned parts or hand soldering.
Item | Quantity | Part Reference | Value | MPN | Manufacturer | LCSC / JLCPCB # | Package | Description | Side | Notes
1 | 1 | C1 | 10uF | CL10A106KP8NNNC | Samsung Electro-Mechanics | C19702 | 0603 (1608 metric), h 0.9 mm | Capacitor, MLCC, 10 uF, 10 V, X5R | Bottom
2 | 3 | C3, C4, C7 | 100nF | CL05B104KO5NNNC | Samsung Electro-Mechanics | C1525 | 0402 (1005 metric) | Capacitor, MLCC, 100 nF, 16 V, X7R | Bottom
3 | 1 | C5 | 11mF | CPH3225A | Seiko Instruments | Consigned (not at LCSC) | 3225 (1210), h 0.9 mm | Electric double-layer capacitor, 11 mF, 3.3 V, reflow capable | Bottom | GNSS backup supply (hot start). Check the land pattern against the Seiko drawing; + toward D1
4 | 1 | C6 | 220nF | CL05B224KO5NNNC | Samsung Electro-Mechanics | C16772 | 0402 (1005 metric) | Capacitor, MLCC, 220 nF, 16 V, X7R | Bottom | IIS2MDC C1 (ESR < 200 mOhm)
5 | 1 | D1 | RB521S30 | RB521S30 | Changjiang (JCET) | C8523 | SOD-523 | Diode, Schottky, 30 V, 200 mA | Bottom | Backup supply blocking diode
6 | 1 | D2 | green | XL-1005UGC | XINGLIGHT | C965793 | 0402 (1005 metric) | LED, green, 0402 | Top | PPS indicator, top side
7 | 1 | J1 | Qwiic IN | SM04B-SRSS-TB(LF)(SN) | JST | C160404 | JST SH 4P side entry, h 2.9 mm | Connector, JST SH, 4 positions, 1.0 mm pitch, side entry | Top | Qwiic in: top side, right edge at v = +3.6 (aligned with FC J3), mouth +X; cable from FC J3
8 | 1 | J2 | Qwiic OUT | SM04B-SRSS-TB(LF)(SN) | JST | C160404 | JST SH 4P side entry, h 2.9 mm | Connector, JST SH, 4 positions, 1.0 mm pitch, side entry | Top | Qwiic out: top side, mouth at the rear edge; optional pass-through
9 | 1 | Q1 | 2N7002 | 2N7002 | Changjiang (JCET) | C8545 | SOT-23 | MOSFET, N-channel, 60 V, 115 mA | Bottom | PPS LED driver, gate on TIMEPULSE only
10 | 1 | R1 | 1k | 0402WGF1001TCE | UNI-ROYAL | C11702 | 0402 (1005 metric) | Resistor, 1 kOhm, 1 %, 1/16 W | Bottom | Supercap charge limit
11 | 1 | R2 | 220R | 0402WGF2200TCE | UNI-ROYAL | C25091 | 0402 (1005 metric) | Resistor, 220 Ohm, 1 %, 1/16 W | Bottom | LED current ~1.4 mA
12 | 1 | U1 | SAM-M10Q-00B | SAM-M10Q-00B | u-blox | Consigned (not at LCSC) | LGA-20 15.5 x 15.5 x 6.3 mm | GNSS antenna module, u-blox M10, GPS/Galileo/BeiDou/GLONASS, UART + I2C | Top | Buy from DigiKey/Mouser and send to JLC as consigned parts, or solder by hand. MSL 4: bake before reflow if the bag was opened
13 | 1 | U3 | IIS2MDC | IIS2MDCTR | STMicroelectronics | C2655002 | LGA-12 (2x2) | 3-axis magnetometer, I2C 0x1E | Bottom | Axes aligned with the FC; same part as the FC compass
Total |  | Total placements (assembled parts) | - |  | line items | - | - | - | - | Not-assembled items listed below
Not assembled (PCB features / DNP)
Item | Quantity | Part Reference | Value | MPN | Manufacturer | LCSC / JLCPCB # | Package | Description | Side | Notes
NA1 | 4 | H1, H2, H3, H4 | M2 | N/A (PCB feature) | N/A | N/A | NPTH 2.2 mm | Mounting hole, M2, 20 x 20 pattern | Top | Keep-out r 2.6 mm on both sides for the nylon standoff / nut
NA2 | 5 | TP1, TP2, TP3, TP4, TP5 | Test pad | N/A (PCB feature) | N/A | N/A | SMD pad 1.0 mm | Test pads SAFEBOOT_N, RESET_N, GND, GNSS TXD, GNSS RXD | Bottom | Firmware recovery: short TP1 to TP3 at power-up; u-center over a 3.3 V USB-UART on TP4/TP5
NA3 | 1 | R3 | 4.7k | 0402WGF4701TCE | UNI-ROYAL | C25900 (DNP) | 0402 (1005 metric) | Resistor, 4.7 kOhm, 1 %, 1/16 W | Bottom | Do not populate: the I2C pull-ups are on the FC (R15/R16). Fit only for a host without pull-ups
NA4 | 1 | R4 | 4.7k | 0402WGF4701TCE | UNI-ROYAL | C25900 (DNP) | 0402 (1005 metric) | Resistor, 4.7 kOhm, 1 %, 1/16 W | Bottom | Do not populate: the I2C pull-ups are on the FC (R15/R16). Fit only for a host without pull-ups

Sheet: Costing
ACwing GPS rev A - component costing (assembled parts, USD)
Blue = input prices; black = formulas. "Estimate" rows are typical distributor prices, not quotes. PCB, assembly fees and the cable are not included.
References | Qty / board | MPN | Source | Unit price @10 boards | Unit price @100 boards | Cost / board @10 | Cost / board @100 | Price basis
C1 | 1 | CL10A106KP8NNNC | C19702 | $0.029 | $0.029 |  |  | LCSC quote
C3, C4, C7 | 3 | CL05B104KO5NNNC | C1525 | $0.005 | $0.005 |  |  | LCSC quote
C5 | 1 | CPH3225A | Consigned (not at LCSC) | $1.300 | $1.000 |  |  | Estimate
C6 | 1 | CL05B224KO5NNNC | C16772 | $0.005 | $0.005 |  |  | LCSC quote
D1 | 1 | RB521S30 | C8523 | $0.012 | $0.008 |  |  | Estimate
D2 | 1 | XL-1005UGC | C965793 | $0.012 | $0.008 |  |  | Estimate
J1 | 1 | SM04B-SRSS-TB(LF)(SN) | C160404 | $0.250 | $0.180 |  |  | Estimate
J2 | 1 | SM04B-SRSS-TB(LF)(SN) | C160404 | $0.250 | $0.180 |  |  | Estimate
Q1 | 1 | 2N7002 | C8545 | $0.012 | $0.008 |  |  | Estimate
R1 | 1 | 0402WGF1001TCE | C11702 | $0.001 | $0.001 |  |  | Estimate
R2 | 1 | 0402WGF2200TCE | C25091 | $0.001 | $0.001 |  |  | Estimate
U1 | 1 | SAM-M10Q-00B | Consigned (not at LCSC) | $22.000 | $19.000 |  |  | Estimate
U3 | 1 | IIS2MDCTR | C2655002 | $3.690 | $2.980 |  |  | LCSC quote
Total per board
Share of U1 (SAM-M10Q) |  |  |  |  |  |  |  | The GNSS module is most of the cost
