ACwing-UAV/ACwing_HW/00 - Docs/03 - FLOW_Docs/ACwing_Flow_A_BoM.xlsx

Sheet: BoM
ACwing Flow rev A - assembly BoM (1 board)
Source: ACwing_Flow_A.kicad_sch / ACwing_Flow_A.kicad_pcb. LCSC part numbers checked on 2026-10-17. Check the PMW3901 lens (LN03-ZSZ) supply before ordering.
Item | Quantity | Part Reference | Value | MPN | Manufacturer | LCSC / JLCPCB # | Package | Description | Side | Notes
1 | 2 | C1, C2 | 22uF | CL10A226MQ8NRNC | Samsung Electro-Mechanics | C59461 | 0603 (1608 metric) | Capacitor, MLCC, 22 uF, 6.3 V, X5R | Top | PMW3901 VDD (PixArt reference)
2 | 6 | C3, C5, C7, C10, C12, C14 | 100nF | CL05B104KO5NNNC | Samsung Electro-Mechanics | C1525 | 0402 (1005 metric) | Capacitor, MLCC, 100 nF, 16 V, X7R | Top | Decoupling
3 | 1 | C4 | 10uF | CL10A106KP8NNNC | Samsung Electro-Mechanics | C19702 | 0603 (1608 metric) | Capacitor, MLCC, 10 uF, 10 V, X5R | Top | PMW3901 VDDIO
4 | 3 | C6, C11, C13 | 4.7uF | CL10A475KO8NNNC | Samsung Electro-Mechanics | C19666 | 0603 (1608 metric) | Capacitor, MLCC, 4.7 uF, 16 V, X5R | Top | PMW3901 VREG, VL53L1X and MCU bulk
5 | 2 | C8, C9 | 1uF | CL05A105KA5NQNC | Samsung Electro-Mechanics | C52923 | 0402 (1005 metric) | Capacitor, MLCC, 1 uF, 25 V, X5R | Top | LDO input / output
6 | 1 | D1 | green | XL-1005UGC | XINGLIGHT | C965793 | 0402 (1005 metric) | LED, green, 0402 | Top | Status LED (PA8)
7 | 2 | J1, J2 | Qwiic | SM04B-SRSS-TB(LF)(SN) | JST | C160404 | JST SH 4P side entry, h 2.9 mm | Connector, JST SH, 4 positions, 1.0 mm pitch, side entry | Top | Qwiic in/out (pass-through), left and right edges
8 | 1 | R1 | 3R | 0402WGF300KTCE | UNI-ROYAL | C423196 | 0402 (1005 metric) | Resistor, 3 Ohm, 1 %, 1/16 W | Top | PMW3901 VDD filter (PixArt reference)
9 | 5 | R2, R3, R4, R9, R10 | 10k | 0402WGF1002TCE | UNI-ROYAL | C25744 | 0402 (1005 metric) | Resistor, 10 kOhm, 1 %, 1/16 W | Top | Pull-ups (NRESET, NCS, MOTION, XSHUT, INT)
10 | 1 | R5 | 15k 1% | 0402WGF1502TCE | UNI-ROYAL | C25756 | 0402 (1005 metric) | Resistor, 15 kOhm, 1 %, 1/16 W | Top | LDO divider, top
11 | 1 | R6 | 10k 1% | 0402WGF1002TCE | UNI-ROYAL | C25744 | 0402 (1005 metric) | Resistor, 10 kOhm, 1 %, 1/16 W | Top | LDO divider, bottom
12 | 1 | R11 | 1k | 0402WGF1001TCE | UNI-ROYAL | C11702 | 0402 (1005 metric) | Resistor, 1 kOhm, 1 %, 1/16 W | Top | LED current
13 | 1 | U1 | PMW3901MB-TXQT | PMW3901MB-TXQT | PixArt Imaging | C43496881 | COB-28 6 x 6 mm (lens 6 x 6 x 2.28) | Optical flow sensor, far field (80 mm to infinity), SPI 2 MHz | Top | Needs the LN03-ZSZ lens assembly: check whether the LCSC/JLC part includes it, otherwise order the lens separately and fit it after reflow
14 | 1 | U2 | LDK130PU-R | LDK130PU-R | STMicroelectronics | C157446 | DFN-6 1.2 x 1.3 mm | LDO, adjustable, 300 mA | Top | PMW3901 VDD 2.0 V (R5/R6)
15 | 1 | U3 | VL53L1CXV0FY/1 | VL53L1CXV0FY/1 | STMicroelectronics | C190004 | LGA-12 4.9 x 2.5 x 1.56 mm | Time-of-flight distance sensor, up to 4 m, I2C 0x29 | Top | Height above ground; keep the cover-glass area clear (no window)
16 | 1 | U4 | STM32C011F4U6 | STM32C011F4U6TR | STMicroelectronics | C5456188 | UFQFPN-20 3 x 3 mm | MCU Cortex-M0+, 48 MHz, 16 KB flash, 6 KB RAM | Top | Flow bridge: reads the PMW3901 on SPI, I2C target 0x3B on the Qwiic bus
Total |  | Total placements (assembled parts) | - |  | line items | - | - | - | - | Not-assembled items listed below
Not assembled (PCB features / DNP)
Item | Quantity | Part Reference | Value | MPN | Manufacturer | LCSC / JLCPCB # | Package | Description | Side | Notes
NA1 | 2 | H1, H2 | M2 | N/A (PCB feature) | N/A | N/A | NPTH 2.2 mm | Mounting hole, M2, 16 x 16 pattern | Top | Keep-out r 2.4 mm on both sides for the nylon screw / standoff
NA2 | 5 | TP1, TP2, TP3, TP4, TP5 | Test pad | N/A (PCB feature) | N/A | N/A | SMD pad 1.0 mm | SWD pads: SWDIO, SWCLK, NRST, 3.3 V, GND | Bottom | First programming of the STM32C011 with a pogo fixture or tag-connect style probe

Sheet: Costing
ACwing Flow rev A - component costing (assembled parts, USD)
Blue = input prices; black = formulas. "Estimate" rows are typical distributor prices, not quotes. PCB, assembly fees and the cable are not included.
References | Qty / board | MPN | Source | Unit price @10 boards | Unit price @100 boards | Cost / board @10 | Cost / board @100 | Price basis
C1, C2 | 2 | CL10A226MQ8NRNC | C59461 | $0.012 | $0.010 |  |  | Estimate
C3, C5, C7, C10, C12, C14 | 6 | CL05B104KO5NNNC | C1525 | $0.005 | $0.005 |  |  | LCSC quote
C4 | 1 | CL10A106KP8NNNC | C19702 | $0.029 | $0.029 |  |  | LCSC quote
C6, C11, C13 | 3 | CL10A475KO8NNNC | C19666 | $0.021 | $0.016 |  |  | LCSC quote
C8, C9 | 2 | CL05A105KA5NQNC | C52923 | $0.007 | $0.007 |  |  | LCSC quote
D1 | 1 | XL-1005UGC | C965793 | $0.012 | $0.008 |  |  | Estimate
J1, J2 | 2 | SM04B-SRSS-TB(LF)(SN) | C160404 | $0.250 | $0.180 |  |  | Estimate
R1 | 1 | 0402WGF300KTCE | C423196 | $0.002 | $0.002 |  |  | Estimate
R2, R3, R4, R9, R10 | 5 | 0402WGF1002TCE | C25744 | $0.002 | $0.002 |  |  | Estimate
R5 | 1 | 0402WGF1502TCE | C25756 | $0.002 | $0.002 |  |  | Estimate
R6 | 1 | 0402WGF1002TCE | C25744 | $0.002 | $0.002 |  |  | Estimate
R11 | 1 | 0402WGF1001TCE | C11702 | $0.002 | $0.002 |  |  | Estimate
U1 | 1 | PMW3901MB-TXQT | C43496881 | $5.200 | $4.600 |  |  | Estimate
U2 | 1 | LDK130PU-R | C157446 | $0.419 | $0.318 |  |  | LCSC quote
U3 | 1 | VL53L1CXV0FY/1 | C190004 | $3.200 | $2.700 |  |  | Estimate
U4 | 1 | STM32C011F4U6TR | C5456188 | $1.633 | $1.230 |  |  | LCSC quote
Total per board
Share of U1 (PMW3901) |  |  |  |  |  |  |  | The flow sensor is the largest single cost
