ACwing-UAV/ACwing_HW/00 - Docs/00 - FC_Docs/ACwing_FC_A.step

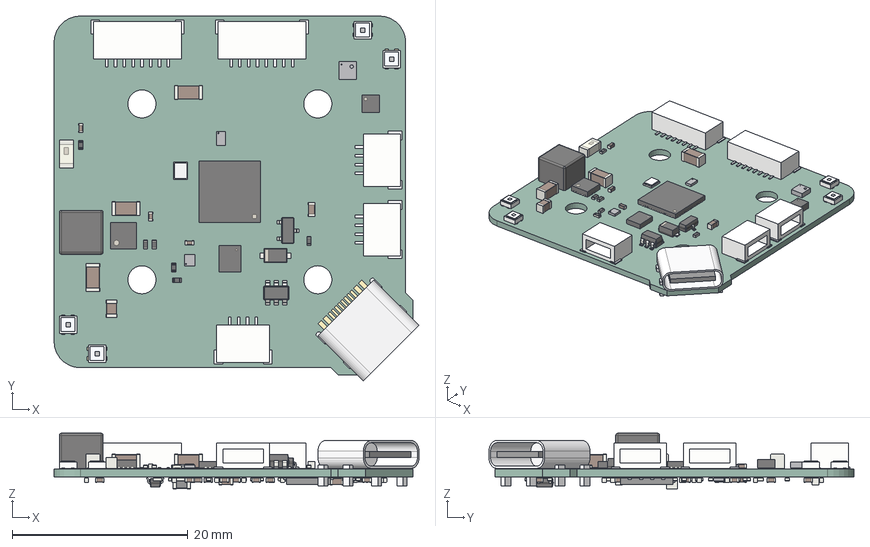
[picture p12: CAD file, 2026-11-08]
00 - Docs/00 - FC_Docs/ACwing_FC_A.step
41.5 x 41.5 x 6.34 mm
D_SOD_123F
DFN-6_1.3x1.2mm_P0.4mm x 2
C_1206_3216Metric x 3
JST_SH_SM04B-SRSS-TB_1x04-1MP_P1.00mm_Horizontal x 3
SOT_23
C_0805_2012Metric
R_0402_1005Metric x 32
a69dfe88-8551-11ed-a139-00155d22e2d7_part
a69dffdc-8551-11ed-a139-00155d22e2d7_part
a69e005e-8551-11ed-a139-00155d22e2d7_part
VSON_10_1EP_3x3mm_Pitch05mm_ThermalPad
QFN-48-1EP_7x7mm_Pitch0.5mm
LED_WS2812B-2020_PLCC4_2.0x2.0mm x 4
C_0603_1608Metric x 3
SOT_23_6
C_0402_1005Metric x 28
JST_SH_SM08B-SRSS-TB_1x08-1MP_P1.00mm_Horizontal x 2
ST_HLGA-10_2x2mm
LGA_14_3x25mm_P05mm_LayoutBorder3x4y
USB_C_Receptacle_HRO_TYPE-C-31-M-12
LGA_12_2x2mm_P05mm
ST_MLPF-WB55-01E3
Crystal_SMD_2016-4Pin_2.0x1.6mm
Johanson_2450AT18x100
SOT_353_SC_70_5
L_0402_1005Metric
L_0805_2012Metric
WSON-8-1EP_6x5mm_P1.27mm_EP3.4x4mm
ACwing_FC_A_PCB
