ACwing-UAV/ACwing_HW/00 - Docs/01 - ESC_1S_Docs/ACwing_ESC1S_A.step

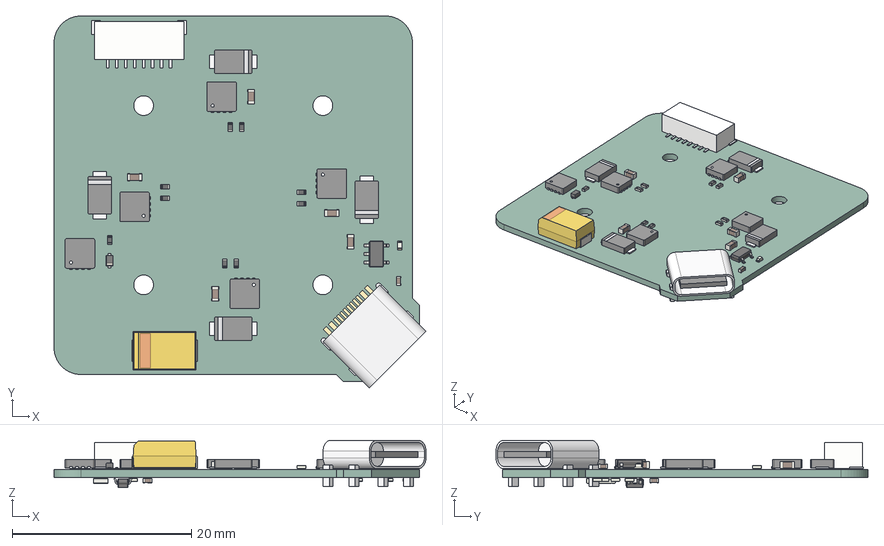
[picture p13: CAD file, 2026-11-08]
00 - Docs/01 - ESC_1S_Docs/ACwing_ESC1S_A.step
41.5 x 41.5 x 5.30 mm
R_0402_1005Metric x 15
C_0603_1608Metric x 5
D_SMAflat x 4
TSOT_23_5
JST_SH_SM08B-SRSS-TB_1x08-1MP_P1.00mm_Horizontal
PowerPAK_1212-8_Single x 5
D_SOD_523
LED_0402_1005Metric
CP_EIA_7343_31_Kemet_D
USB_C_Receptacle_HRO_TYPE-C-31-M-12
C_0402_1005Metric x 3
R_1206_3216Metric
SOT_363_SC_70_6
ACwing_ESC1S_A_PCB
