ACwing-UAV/ACwing_HW/00 - Docs/02 - GPS_Docs/ACwing_GPS_A.step

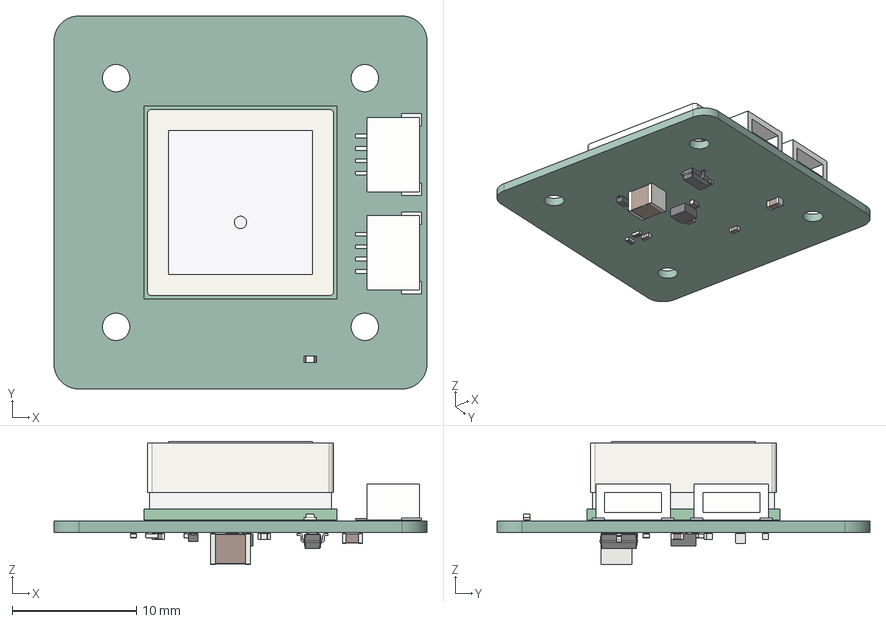
[picture p14: CAD file, 2026-11-08]
00 - Docs/02 - GPS_Docs/ACwing_GPS_A.step
30.0 x 30.0 x 9.90 mm
LED_0402_1005Metric
JST_SH_SM04B-SRSS-TB_1x04-1MP_P1.00mm_Horizontal x 2
ublox_SAM-M10Q
R_0402_1005Metric x 4
C_0402_1005Metric x 4
C_1210_3225Metric
SOT_23
D_SOD_523
C_0603_1608Metric
LGA_12_2x2mm_P05mm
ACwing_GPS_A_PCB
