ACwing-UAV/ACwing_HW/00 - Docs/03 - FLOW_Docs/ACwing_Flow_A.step

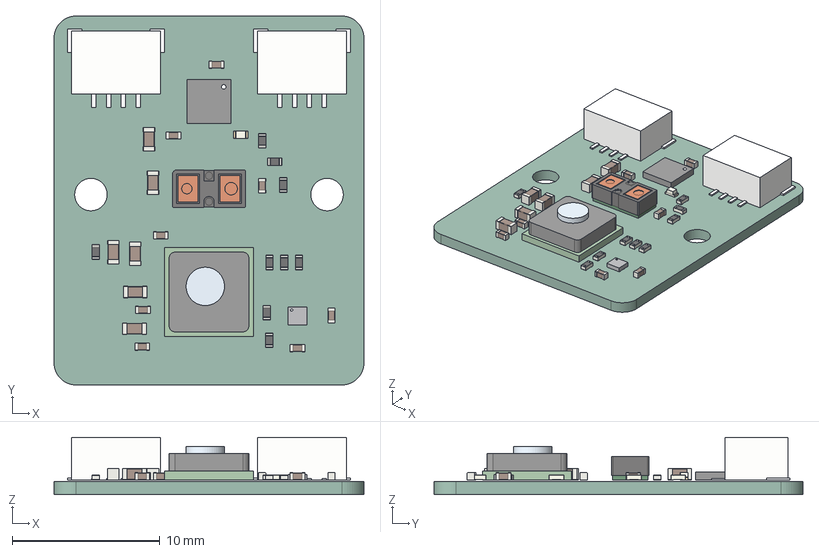
[picture p15: CAD file, 2026-11-08]
00 - Docs/03 - FLOW_Docs/ACwing_Flow_A.step
21.0 x 25.0 x 3.90 mm
ST_UFQFPN-20_3x3mm_P0.5mm
R_0402_1005Metric x 9
C_0402_1005Metric x 8
C_0603_1608Metric x 6
PixArt_PMW3901MB_COB-28_6x6mm
ST_VL53L1x
JST_SH_SM04B-SRSS-TB_1x04-1MP_P1.00mm_Horizontal x 2
DFN-6_1.3x1.2mm_P0.4mm
LED_0402_1005Metric
ACwing_Flow_A_PCB
