ACwing-UAV/ACwing_HW/01 - FC_KiCadProj/3d/SOT-353_SC-70-5.step

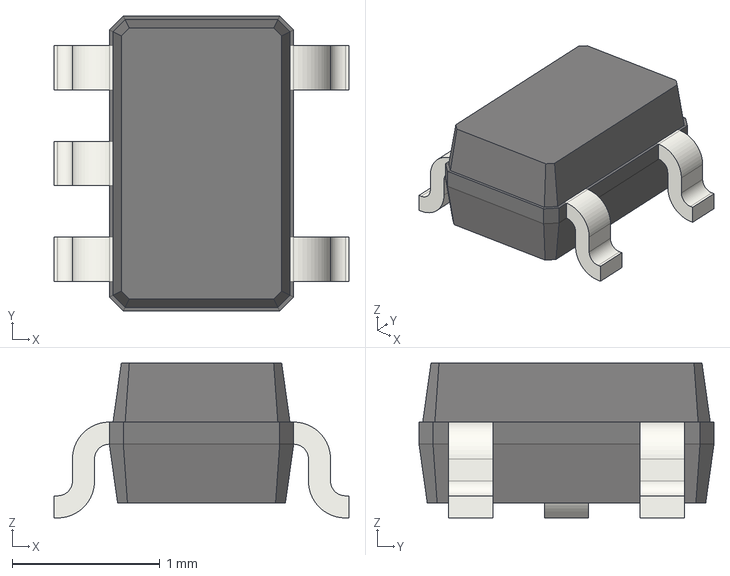
[picture p16: CAD file, 2026-10-27]
01 - FC_KiCadProj/3d/SOT-353_SC-70-5.step
2.00 x 2.00 x 1.05 mm
