ACwing-UAV/ACwing_HW/02 - ESC_1S_KiCadProj/3d/R_1206_3216Metric.step

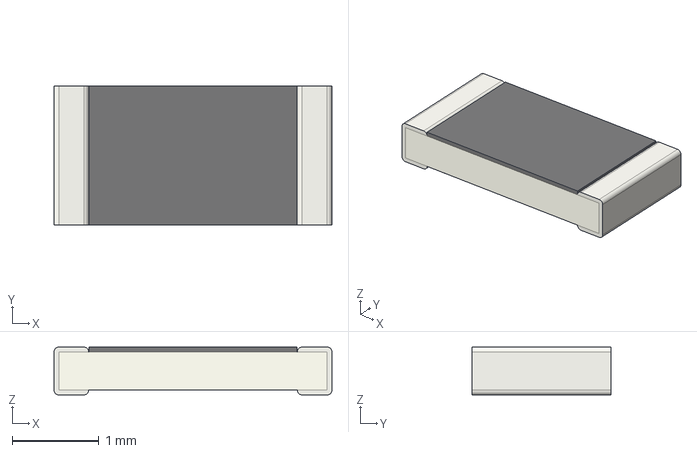
[picture p17: CAD file, 2026-10-19]
02 - ESC_1S_KiCadProj/3d/R_1206_3216Metric.step
3.20 x 1.60 x 0.55 mm
