ACwing-UAV/ACwing_HW/03 - GPS_KiCadProj/3d/C_1210_3225Metric.step

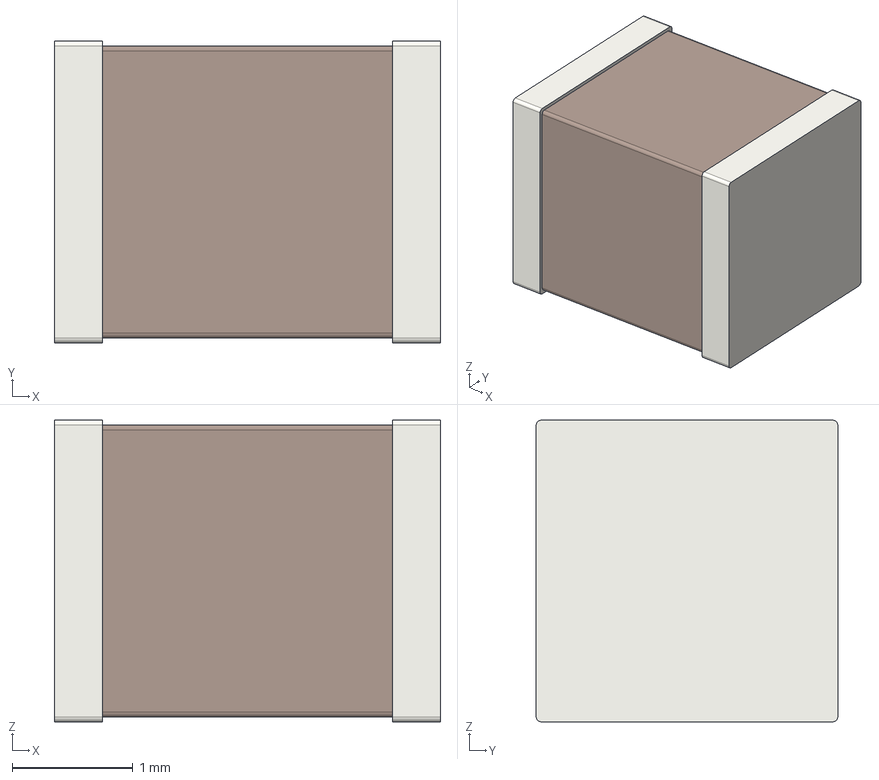
[picture p18: CAD file, 2026-10-19]
03 - GPS_KiCadProj/3d/C_1210_3225Metric.step
3.20 x 2.50 x 2.50 mm
