ACwing-UAV/ACwing_HW/04 - FLOW_KiCadProj/3d/JST_SH_SM04B-SRSS-TB_1x04-1MP_P1.00mm_Horizontal.step

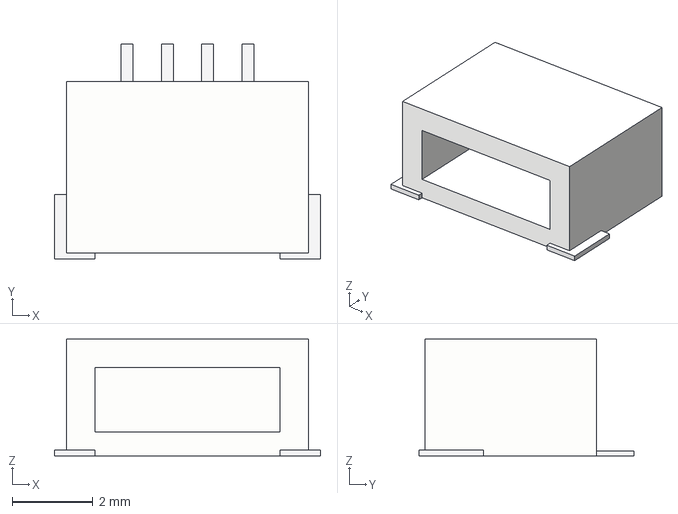
[picture p19: CAD file, 2026-10-19]
04 - FLOW_KiCadProj/3d/JST_SH_SM04B-SRSS-TB_1x04-1MP_P1.00mm_Horizontal.step
6.60 x 5.32 x 2.90 mm
