ACwing-UAV/ACwing_HW/00 - Docs/00 - FC_Docs/ACwing_FC_A_outline.dxf

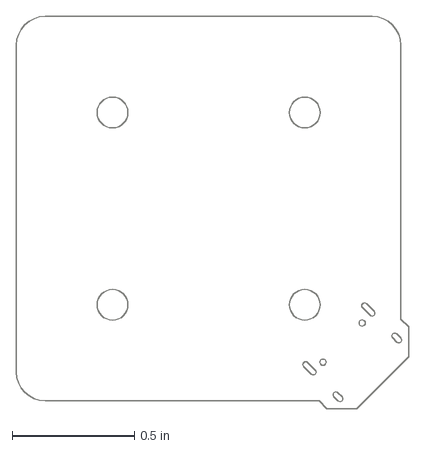
[picture p20: CAD file, 2026-11-08]
00 - Docs/00 - FC_Docs/ACwing_FC_A_outline.dxf
1.61 x 1.61 in
