ACwing-UAV/ACwing_HW/00 - Docs/03 - FLOW_Docs/ACwing_Flow_A_mech_outline.dxf

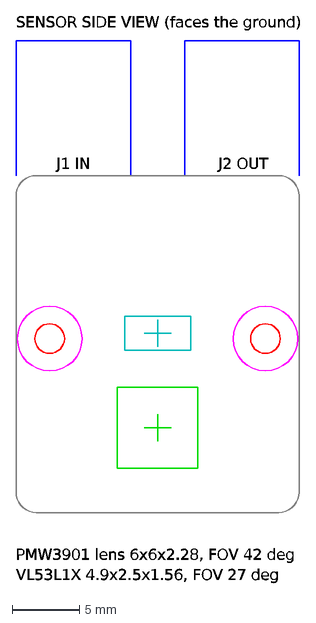
[picture p21: CAD file, 2026-11-03]
00 - Docs/03 - FLOW_Docs/ACwing_Flow_A_mech_outline.dxf
SENSOR SIDE VIEW (faces the ground)
PMW3901 lens 6x6x2.28, FOV 42 deg
VL53L1X 4.9x2.5x1.56, FOV 27 deg
J1 IN
J2 OUT
