ACwing-UAV/ACwing_HW/01 - FC_KiCadProj/3d/LED_WS2812B-2020_PLCC4_2.0x2.0mm.step

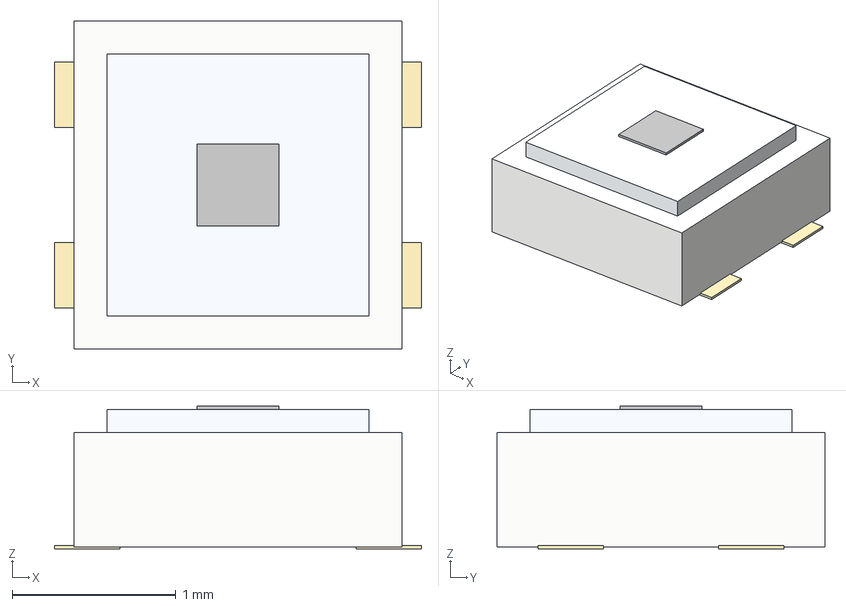
[picture p22: CAD file, 2026-10-19]
01 - FC_KiCadProj/3d/LED_WS2812B-2020_PLCC4_2.0x2.0mm.step
2.24 x 2.00 x 0.87 mm
