ACwing-UAV/ACwing_HW/02 - ESC_1S_KiCadProj/3d/D_SOD-523.step

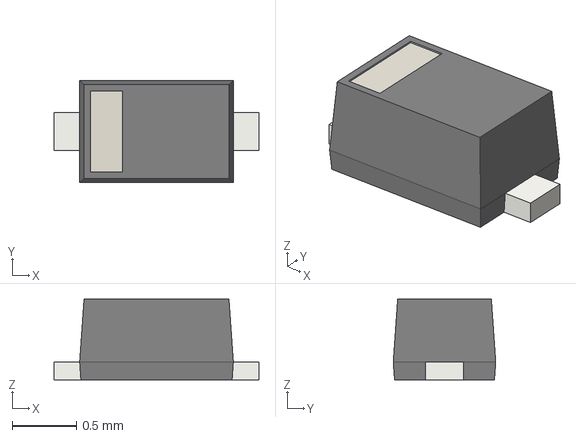
[picture p23: CAD file, 2026-10-19]
02 - ESC_1S_KiCadProj/3d/D_SOD-523.step
1.60 x 0.8 x 0.63 mm
