ACwing-UAV/ACwing_HW/04 - FLOW_KiCadProj/3d/ST_VL53L1x.step

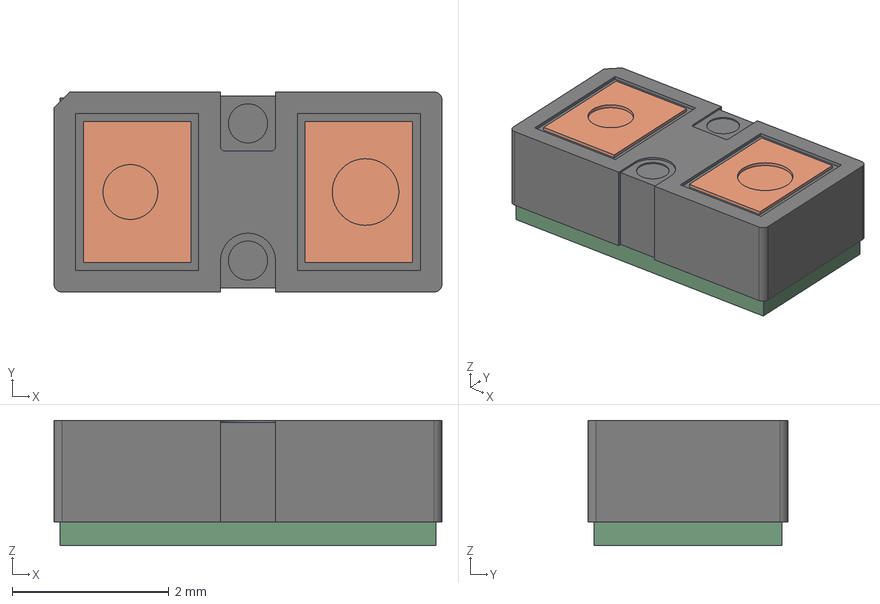
[picture p24: CAD file, 2026-10-19]
04 - FLOW_KiCadProj/3d/ST_VL53L1x.step
4.95 x 2.55 x 1.60 mm
