ACwing-UAV/ACwing_HW/01 - FC_KiCadProj/3d/C_0805_2012Metric.step

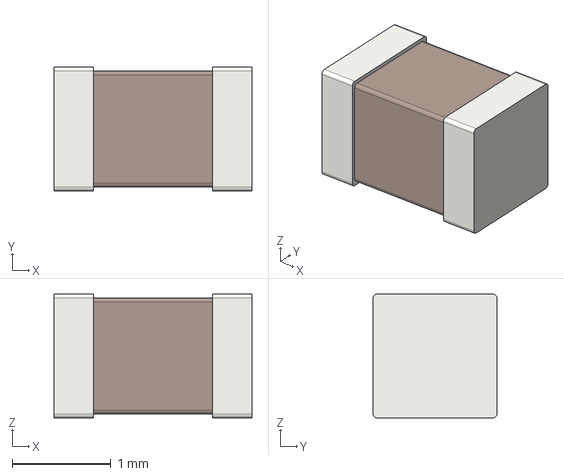
[picture p25: CAD file, 2026-10-19]
01 - FC_KiCadProj/3d/C_0805_2012Metric.step
2.00 x 1.25 x 1.25 mm
