ACwing-UAV/ACwing_HW/02 - ESC_1S_KiCadProj/3d/JST_SH_SM08B-SRSS-TB_1x08-1MP_P1.00mm_Horizontal.step

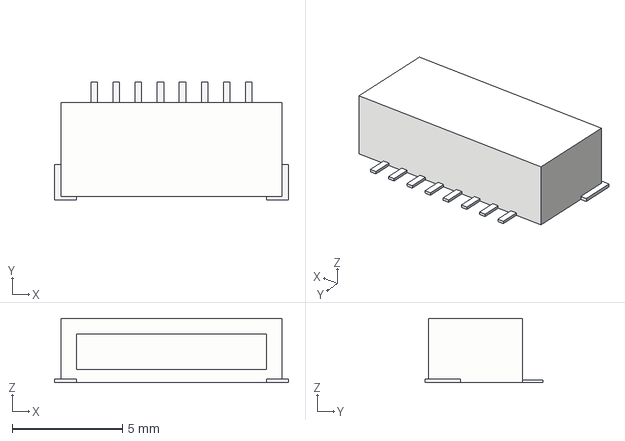
[picture p26: CAD file, 2026-10-19]
02 - ESC_1S_KiCadProj/3d/JST_SH_SM08B-SRSS-TB_1x08-1MP_P1.00mm_Horizontal.step
10.6 x 5.32 x 2.90 mm
