ACwing-UAV/ACwing_HW/03 - GPS_KiCadProj/3d/ublox_SAM-M10Q.step

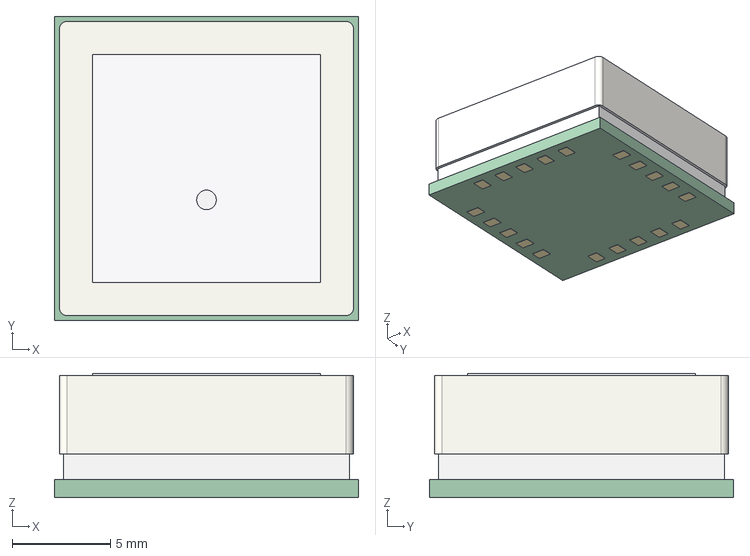
[picture p27: CAD file, 2026-10-19]
03 - GPS_KiCadProj/3d/ublox_SAM-M10Q.step
15.5 x 15.5 x 6.34 mm
