ACwing-UAV/ACwing_HW/04 - FLOW_KiCadProj/3d/PixArt_PMW3901MB_COB-28_6x6mm.step

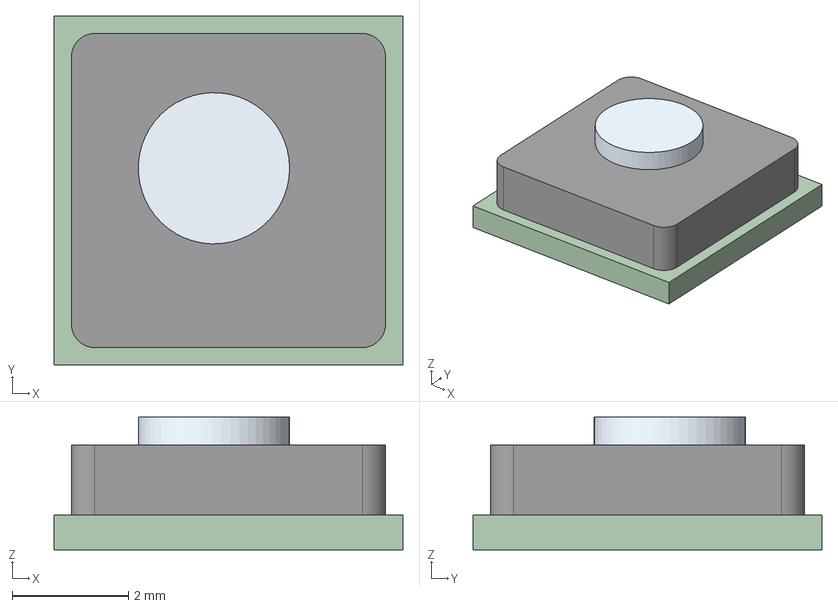
[picture p28: CAD file, 2026-10-19]
04 - FLOW_KiCadProj/3d/PixArt_PMW3901MB_COB-28_6x6mm.step
6.00 x 6.00 x 2.28 mm
