ACwing-UAV/ACwing_HW/02 - ESC_1S_KiCadProj/3d/D_SMAflat.step

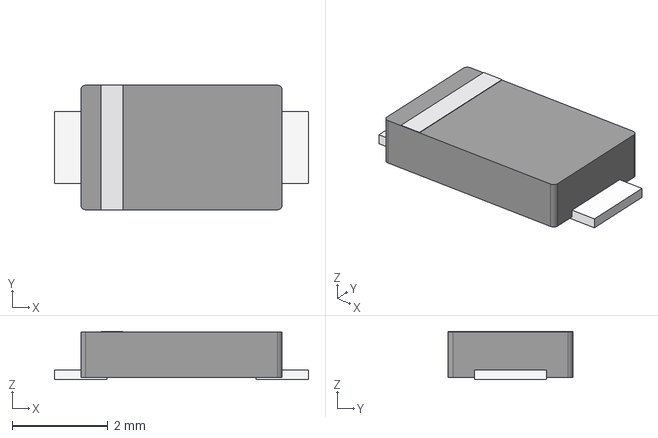
[picture p29: CAD file, 2026-10-16]
02 - ESC_1S_KiCadProj/3d/D_SMAflat.step
5.30 x 2.60 x 1.01 mm
