ACwing-UAV/ACwing_HW/04 - FLOW_KiCadProj/3d/ST_UFQFPN-20_3x3mm_P0.5mm.step

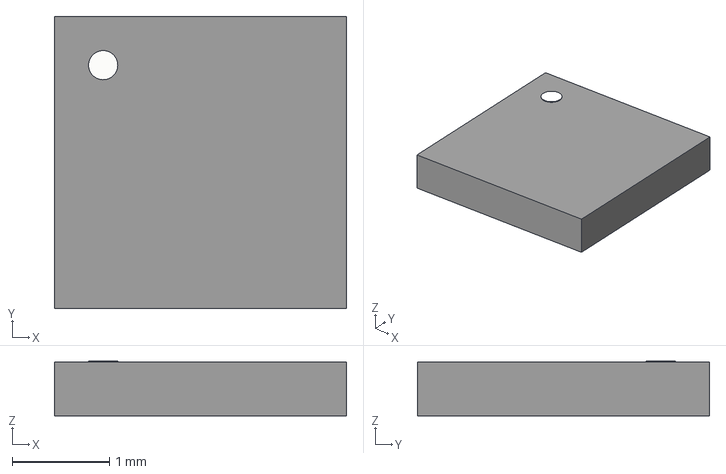
[picture p30: CAD file, 2026-10-19]
04 - FLOW_KiCadProj/3d/ST_UFQFPN-20_3x3mm_P0.5mm.step
3.00 x 3.00 x 0.56 mm
