ACwing-UAV/ACwing_HW/02 - ESC_1S_KiCadProj/3d/C_0402_1005Metric.step

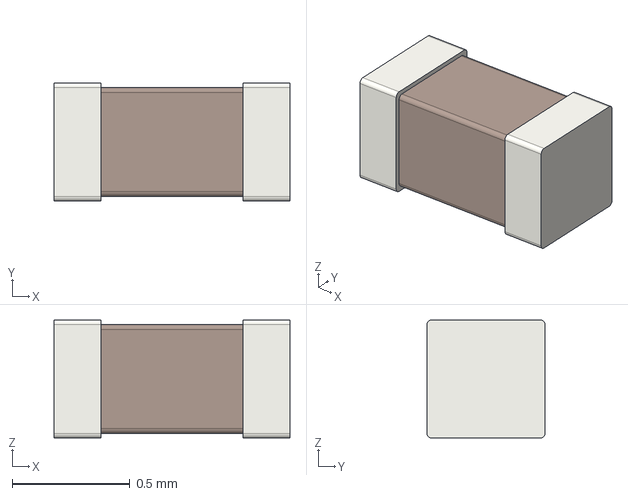
[picture p31: CAD file, 2026-10-16]
02 - ESC_1S_KiCadProj/3d/C_0402_1005Metric.step
1.00 x 0.5 x 0.5 mm
