ACwing-UAV/ACwing_HW/03 - GPS_KiCadProj/3d/LED_0402_1005Metric.step

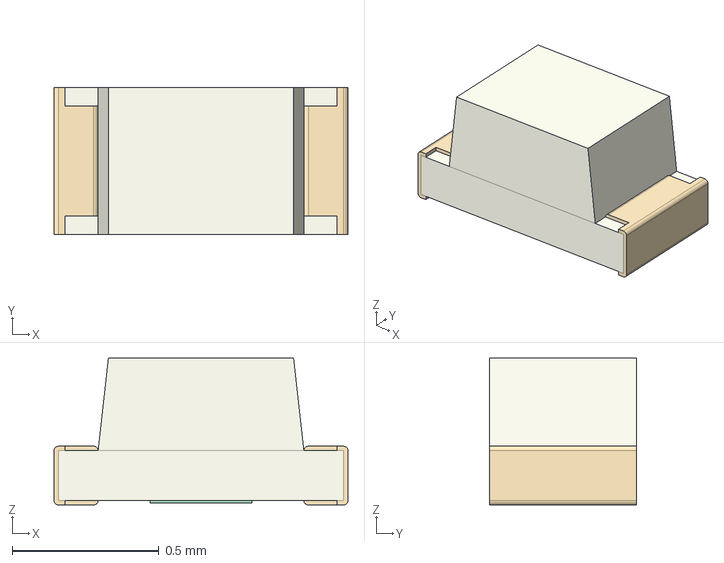
[picture p32: CAD file, 2026-10-16]
03 - GPS_KiCadProj/3d/LED_0402_1005Metric.step
1.00 x 0.5 x 0.5 mm
