ACwing-UAV/ACwing_HW/03 - GPS_KiCadProj/3d/SOT-23.step

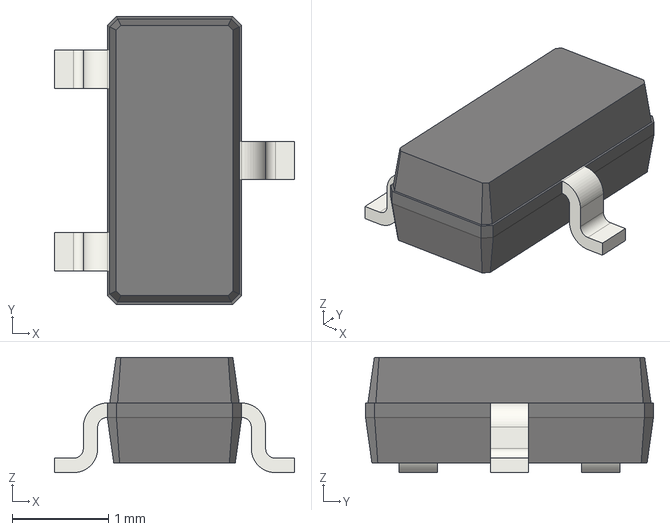
[picture p33: CAD file, 2026-10-16]
03 - GPS_KiCadProj/3d/SOT-23.step
2.50 x 3.00 x 1.20 mm
