ACwing-UAV/ACwing_HW/04 - FLOW_KiCadProj/3d/R_0402_1005Metric.step

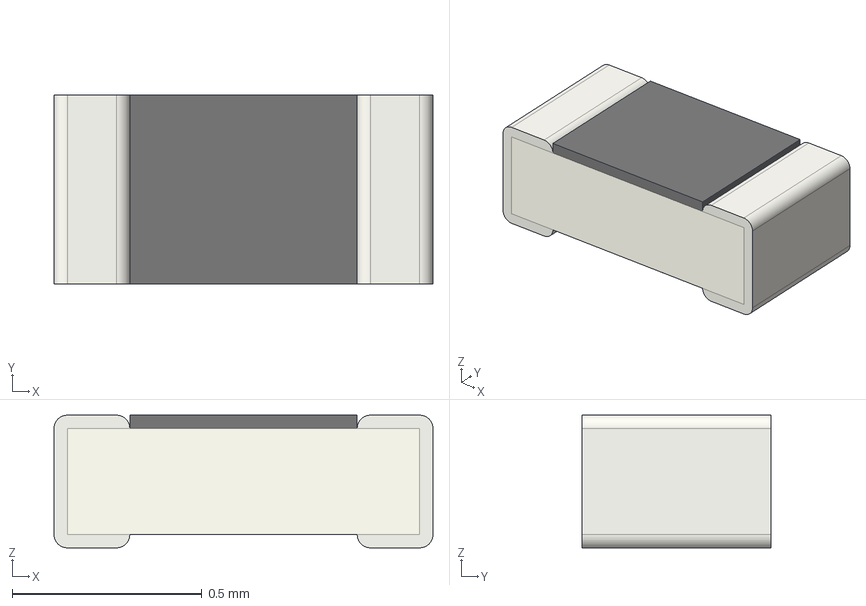
[picture p34: CAD file, 2026-10-16]
04 - FLOW_KiCadProj/3d/R_0402_1005Metric.step
1.00 x 0.5 x 0.35 mm
