ACwing-UAV/ACwing_HW/01 - FC_KiCadProj/3d/Crystal_SMD_2016-4Pin_2.0x1.6mm.step

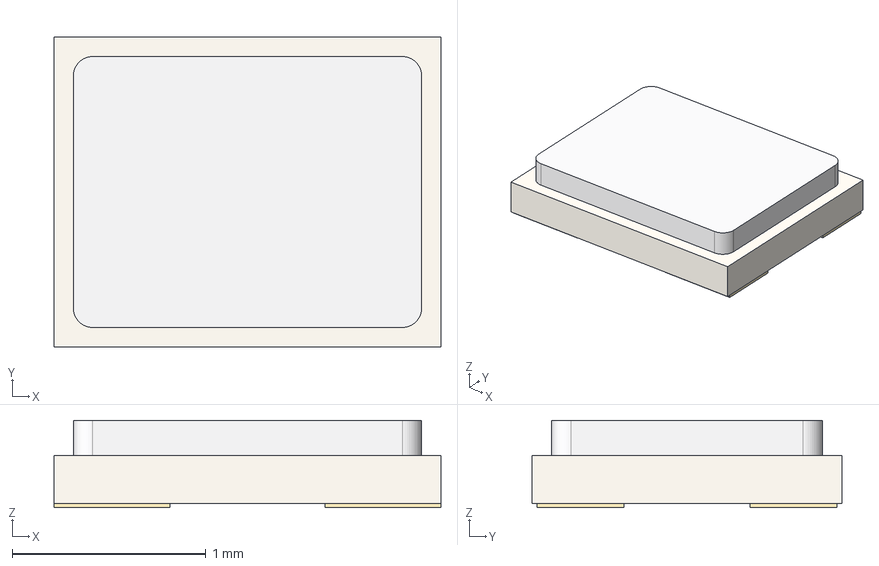
[picture p35: CAD file, 2026-10-19]
01 - FC_KiCadProj/3d/Crystal_SMD_2016-4Pin_2.0x1.6mm.step
2.00 x 1.60 x 0.45 mm
