ACwing-UAV/ACwing_HW/02 - ESC_1S_KiCadProj/3d/SOT-363_SC-70-6.step

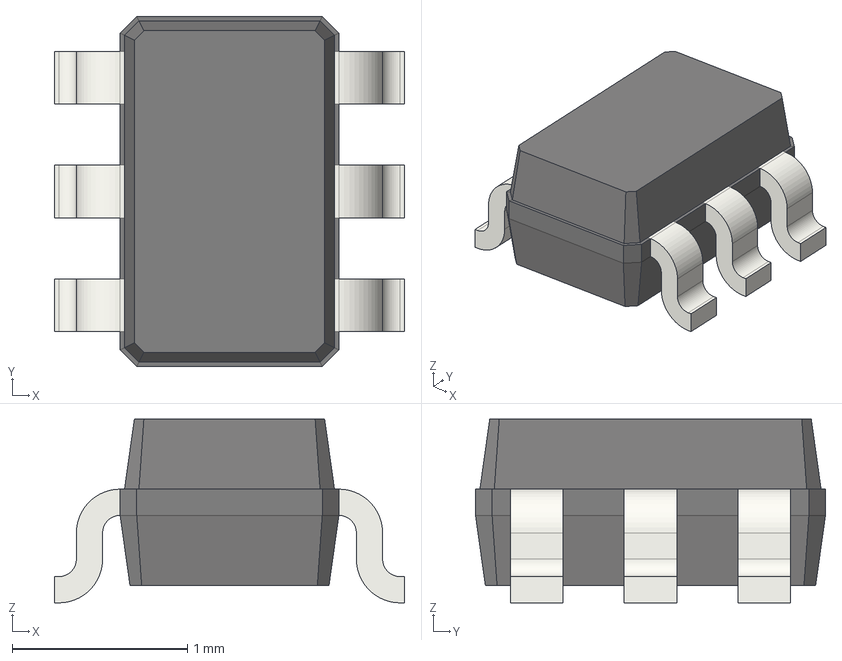
[picture p36: CAD file, 2026-10-16]
02 - ESC_1S_KiCadProj/3d/SOT-363_SC-70-6.step
2.00 x 2.00 x 1.05 mm
