ACwing-UAV/ACwing_HW/02 - ESC_1S_KiCadProj/3d/USB_C_Receptacle_HRO_TYPE-C-31-M-12.step

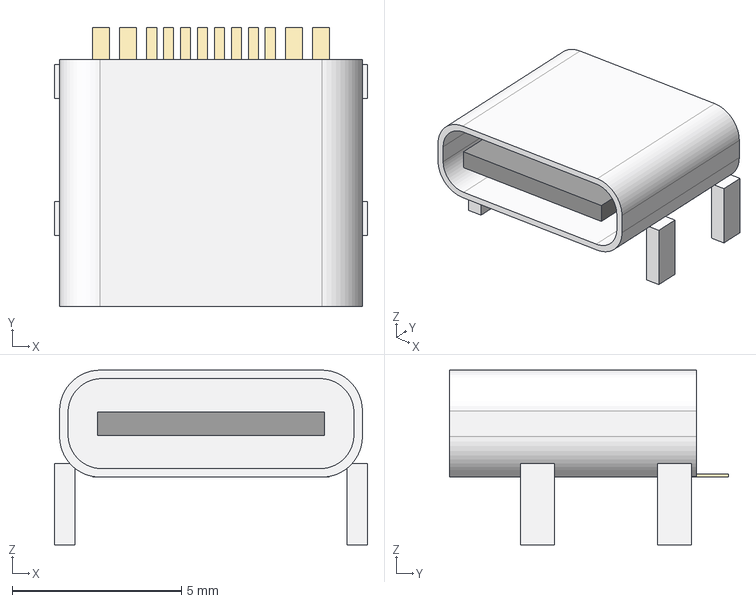
[picture p37: CAD file, 2026-10-16]
02 - ESC_1S_KiCadProj/3d/USB_C_Receptacle_HRO_TYPE-C-31-M-12.step
9.24 x 8.25 x 5.16 mm
