ACwing-UAV/ACwing_HW/03 - GPS_KiCadProj/3d/LGA-12_2x2mm_P0.5mm.step

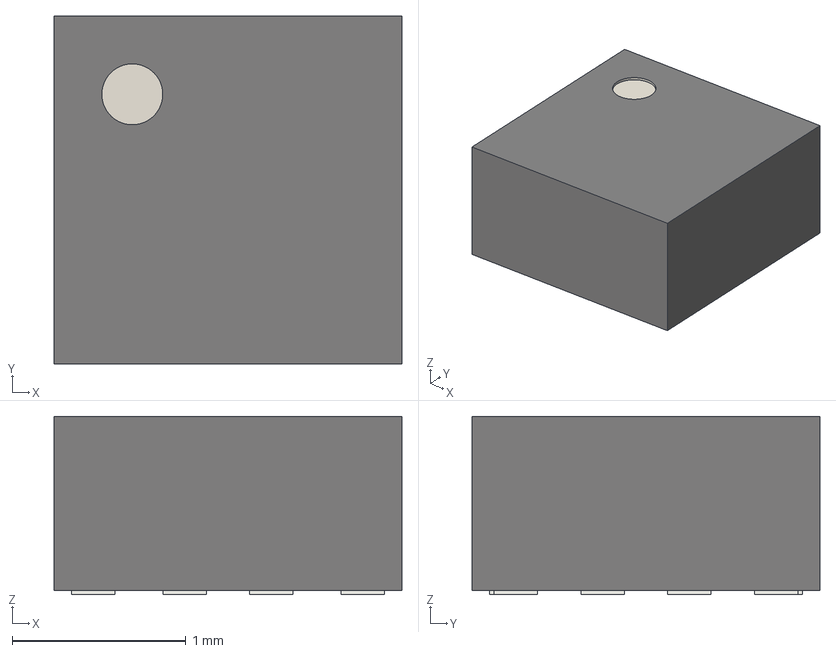
[picture p38: CAD file, 2026-10-16]
03 - GPS_KiCadProj/3d/LGA-12_2x2mm_P0.5mm.step
2.00 x 2.00 x 1.02 mm
