ACwing-UAV/ACwing_HW/04 - FLOW_KiCadProj/3d/DFN-6_1.3x1.2mm_P0.4mm.step

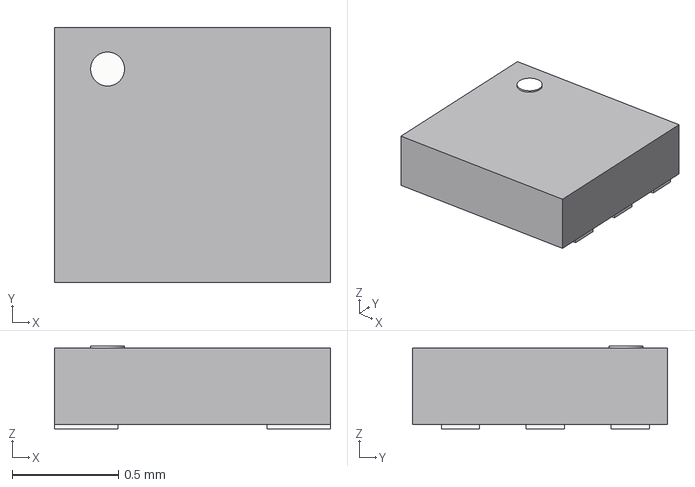
[picture p39: CAD file, 2026-10-16]
04 - FLOW_KiCadProj/3d/DFN-6_1.3x1.2mm_P0.4mm.step
1.30 x 1.20 x 0.39 mm
