ACwing-UAV/ACwing_HW/01 - FC_KiCadProj/3d/Texas_DRC0010J.step

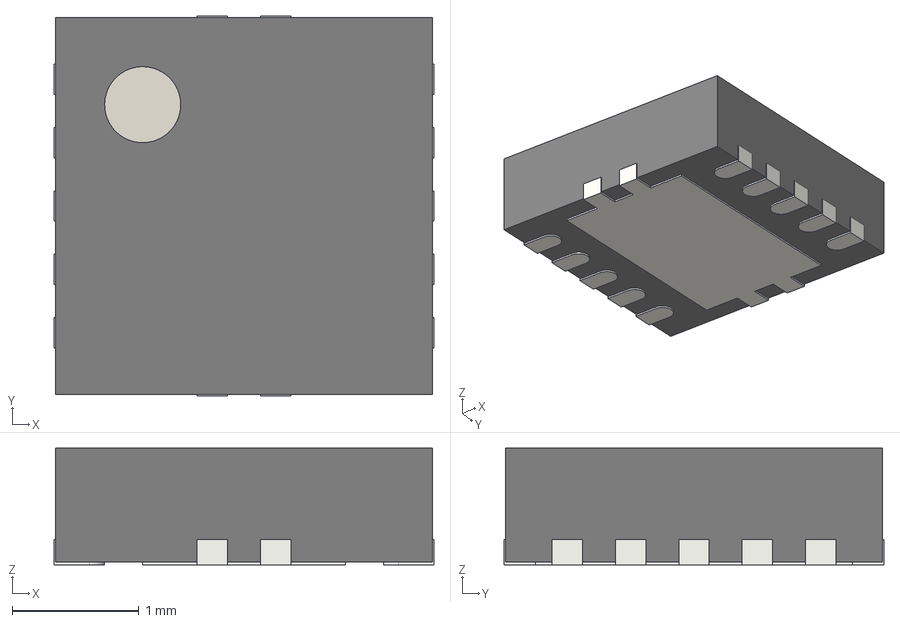
[picture p40: CAD file, 2026-10-19]
01 - FC_KiCadProj/3d/Texas_DRC0010J.step
3.00 x 3.00 x 0.92 mm
