ACwing-UAV/ACwing_HW/02 - ESC_1S_KiCadProj/3d/C_0603_1608Metric.step

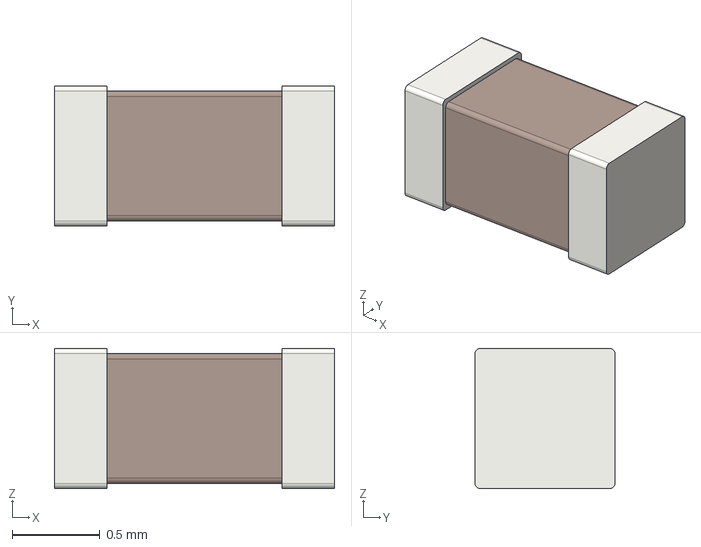
[picture p41: CAD file, 2026-10-16]
02 - ESC_1S_KiCadProj/3d/C_0603_1608Metric.step
1.60 x 0.8 x 0.8 mm
