ACwing-UAV/ACwing_HW/01 - FC_KiCadProj/3d/L_Sunlord_SWPA5040S.step

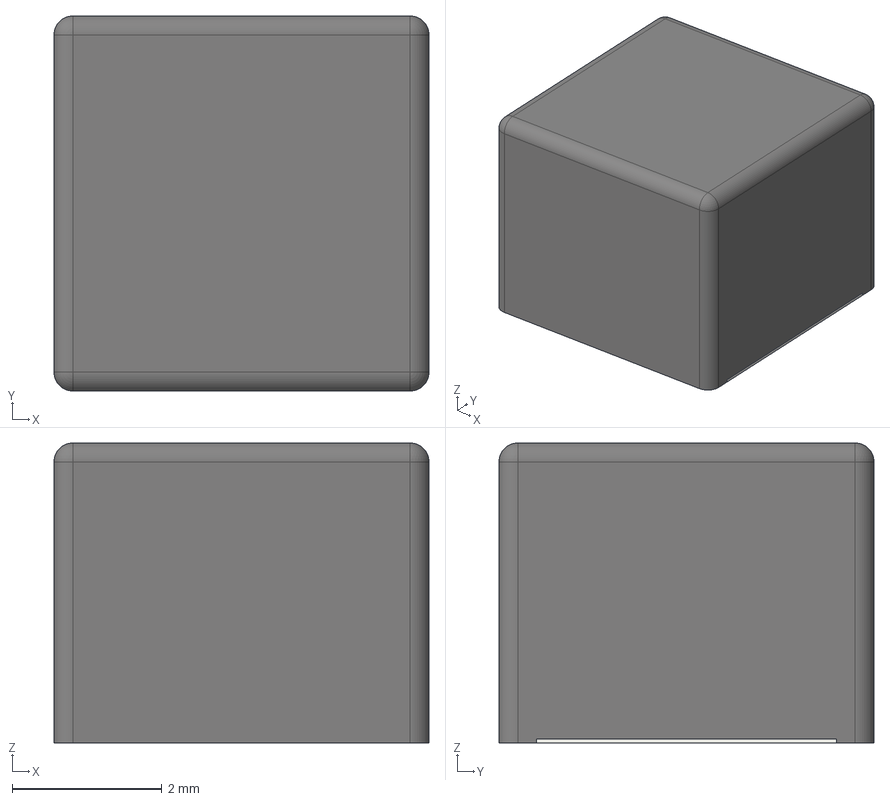
[picture p42: CAD file, 2026-10-19]
01 - FC_KiCadProj/3d/L_Sunlord_SWPA5040S.step
5.00 x 5.00 x 4.00 mm
a69dfe88-8551-11ed-a139-00155d22e2d7_part
a69dffdc-8551-11ed-a139-00155d22e2d7_part
a69e005e-8551-11ed-a139-00155d22e2d7_part
