ACwing-UAV/ACwing_HW/02 - ESC_1S_KiCadProj/3d/PowerPAK_1212-8_Single.step

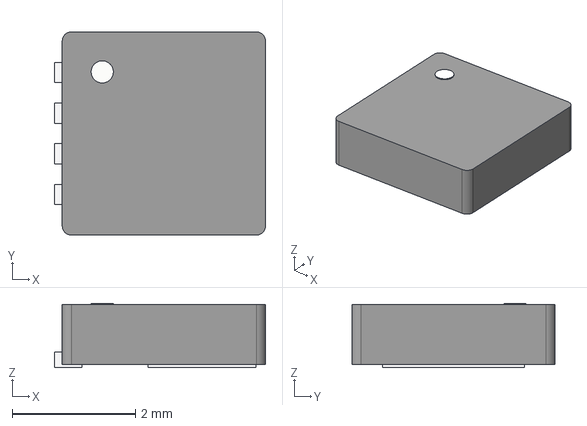
[picture p43: CAD file, 2026-10-16]
02 - ESC_1S_KiCadProj/3d/PowerPAK_1212-8_Single.step
3.42 x 3.30 x 1.04 mm
