ACwing-UAV/ACwing_HW/01 - FC_KiCadProj/3d/ST_MLPF-WB55-01E3.step

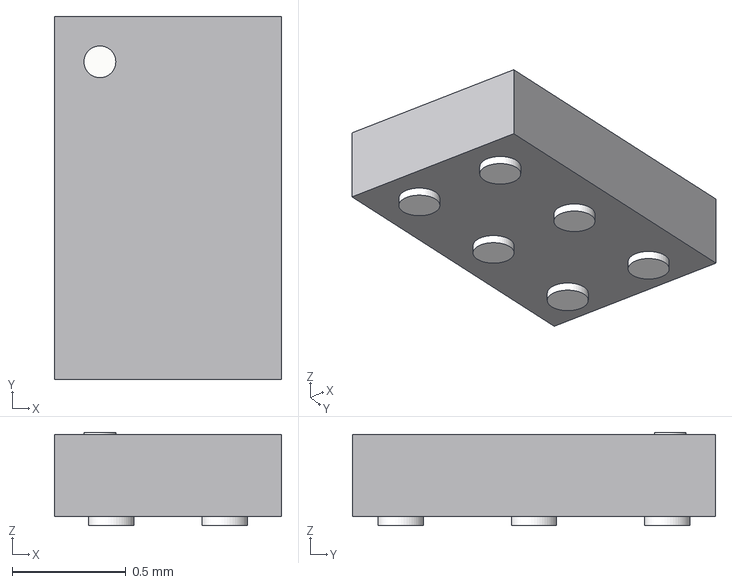
[picture p44: CAD file, 2026-10-19]
01 - FC_KiCadProj/3d/ST_MLPF-WB55-01E3.step
1.00 x 1.60 x 0.41 mm
