ACwing-UAV/ACwing_HW/02 - ESC_1S_KiCadProj/3d/CP_EIA-7343-31_Kemet-D.step

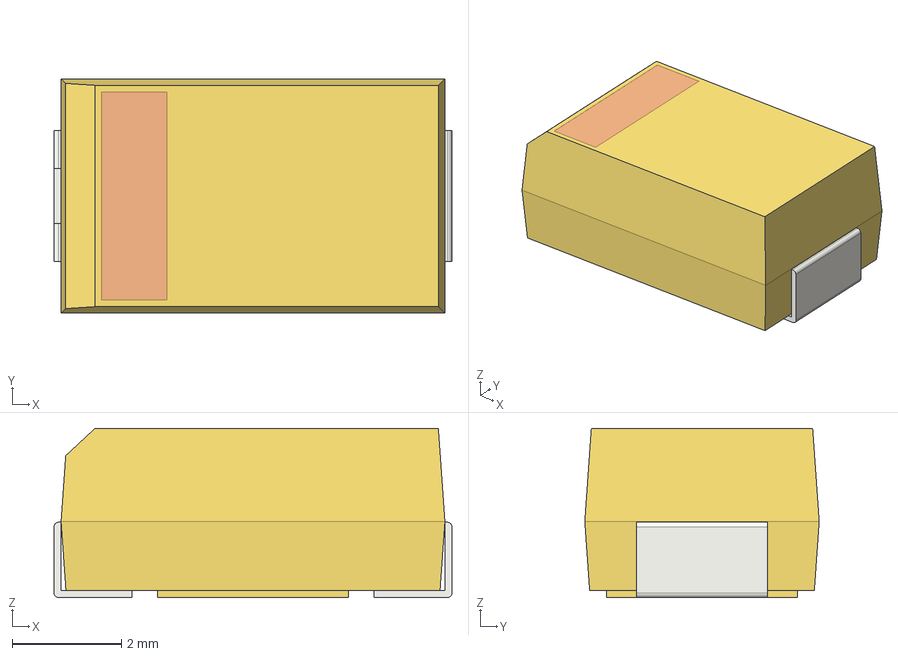
[picture p45: CAD file, 2026-10-16]
02 - ESC_1S_KiCadProj/3d/CP_EIA-7343-31_Kemet-D.step
7.30 x 4.30 x 3.10 mm
