ACwing-UAV/ACwing_HW/01 - FC_KiCadProj/3d/WSON-8-1EP_6x5mm_P1.27mm_EP3.4x4mm.step

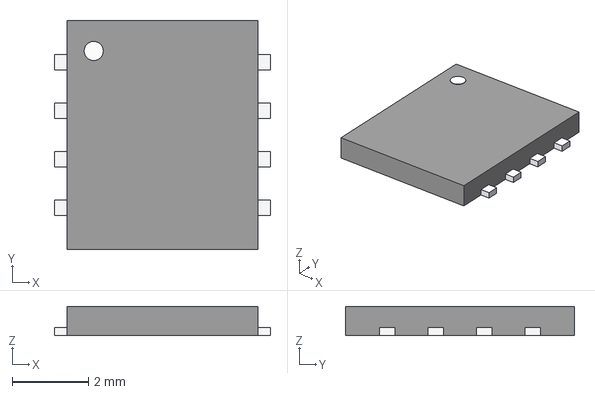
[picture p46: CAD file, 2026-10-19]
01 - FC_KiCadProj/3d/WSON-8-1EP_6x5mm_P1.27mm_EP3.4x4mm.step
5.65 x 6.00 x 0.77 mm
