ACwing-UAV/ACwing_HW/02 - ESC_1S_KiCadProj/3d/TSOT-23-5.step

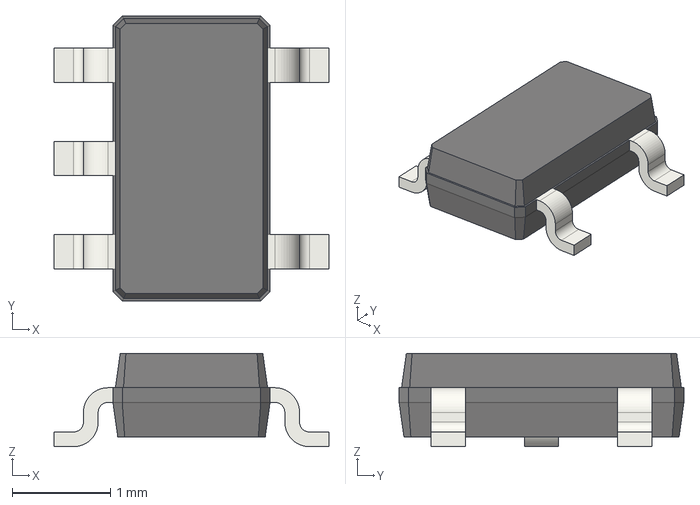
[picture p47: CAD file, 2026-10-16]
02 - ESC_1S_KiCadProj/3d/TSOT-23-5.step
2.80 x 2.90 x 0.95 mm
