ACwing-UAV/ACwing_HW/01 - FC_KiCadProj/3d/D_SOD-123F.step

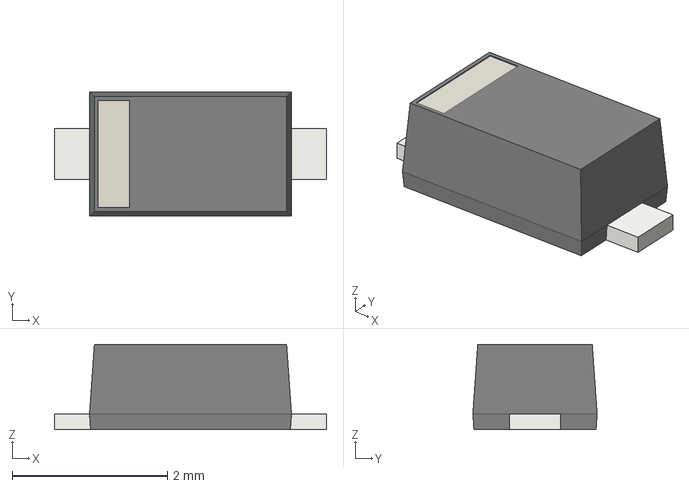
[picture p48: CAD file, 2026-10-16]
01 - FC_KiCadProj/3d/D_SOD-123F.step
3.50 x 1.60 x 1.10 mm
