ACwing-UAV/ACwing_HW/01 - FC_KiCadProj/3d/R_0603_1608Metric.step

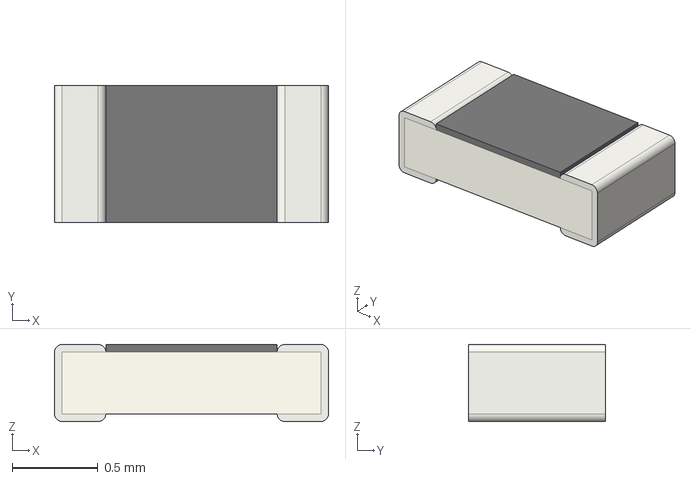
[picture p49: CAD file, 2026-10-16]
01 - FC_KiCadProj/3d/R_0603_1608Metric.step
1.60 x 0.8 x 0.45 mm
