ACwing-UAV/ACwing_HW/01 - FC_KiCadProj/3d/ST_HLGA-10_2x2mm.step

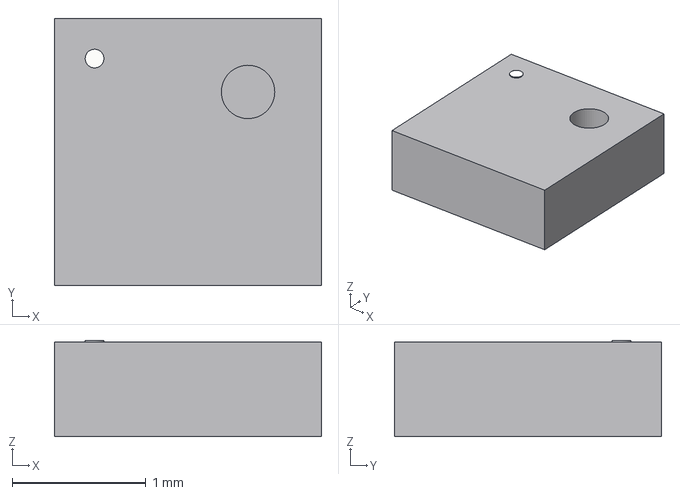
[picture p50: CAD file, 2026-10-16]
01 - FC_KiCadProj/3d/ST_HLGA-10_2x2mm.step
2.00 x 2.00 x 0.72 mm
