ACwing-UAV/ACwing_HW/01 - FC_KiCadProj/3d/SOT-23-6.step

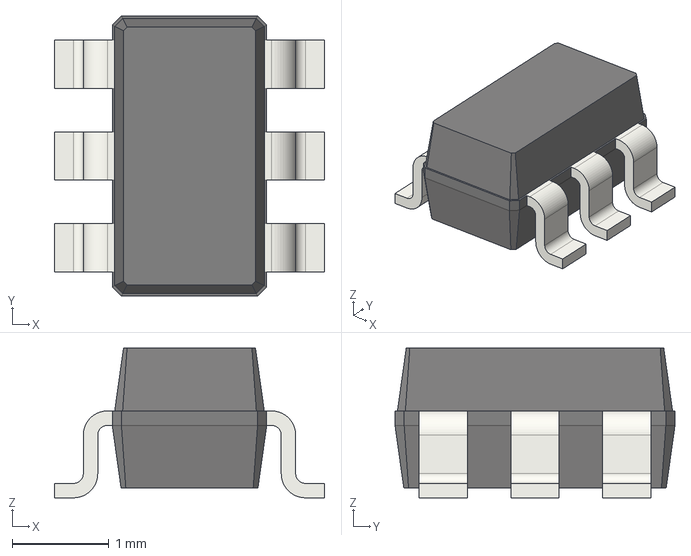
[picture p51: CAD file, 2026-10-16]
01 - FC_KiCadProj/3d/SOT-23-6.step
2.80 x 2.90 x 1.55 mm
