ACwing-UAV/ACwing_HW/01 - FC_KiCadProj/3d/LGA-14_3x2.5mm_P0.5mm_LayoutBorder3x4y.step

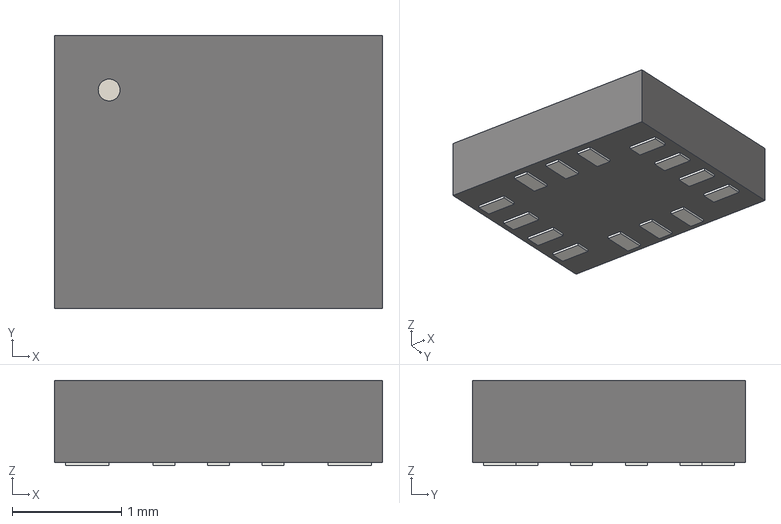
[picture p52: CAD file, 2026-10-16]
01 - FC_KiCadProj/3d/LGA-14_3x2.5mm_P0.5mm_LayoutBorder3x4y.step
3.00 x 2.50 x 0.78 mm
