ACwing-UAV/ACwing_HW/01 - FC_KiCadProj/3d/Johanson_2450AT18x100.step

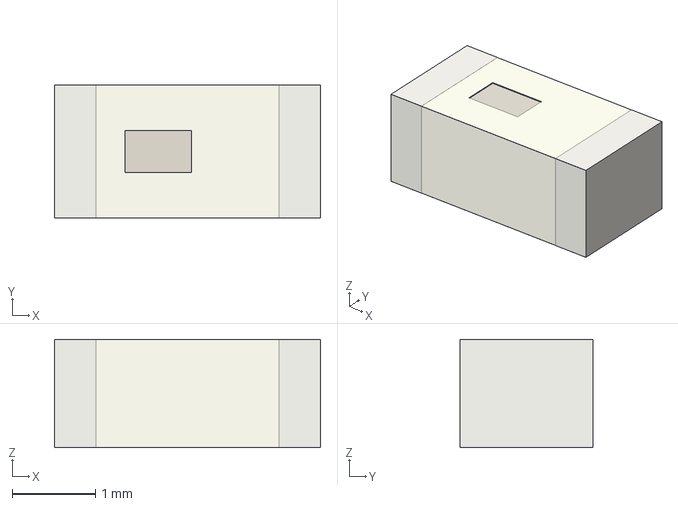
[picture p53: CAD file, 2026-10-16]
01 - FC_KiCadProj/3d/Johanson_2450AT18x100.step
3.20 x 1.60 x 1.30 mm
