ACwing-UAV/ACwing_HW/01 - FC_KiCadProj/3d/C_1206_3216Metric.step

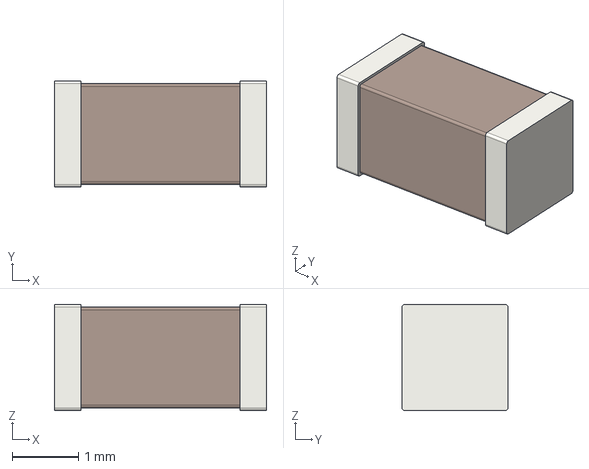
[picture p54: CAD file, 2026-10-16]
01 - FC_KiCadProj/3d/C_1206_3216Metric.step
3.20 x 1.60 x 1.60 mm
