ACwing-UAV/ACwing_HW/01 - FC_KiCadProj/3d/QFN-48-1EP_7x7mm_P0.5mm_EP5.6x5.6mm.step

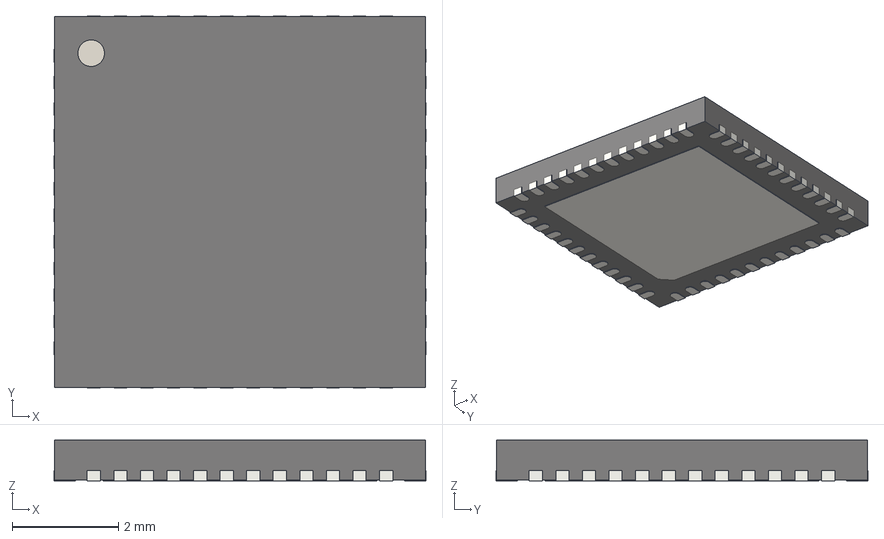
[picture p55: CAD file, 2026-10-16]
01 - FC_KiCadProj/3d/QFN-48-1EP_7x7mm_P0.5mm_EP5.6x5.6mm.step
7.00 x 7.00 x 0.77 mm
