ACwing-UAV/ACwing_HW/(list of files, cad)

Other CAD files:
01 - FC_KiCadProj/3d/JST_SH_SM04B-SRSS-TB_1x04-1MP_P1.00mm_Horizontal.step
01 - FC_KiCadProj/3d/JST_SH_SM08B-SRSS-TB_1x08-1MP_P1.00mm_Horizontal.step
01 - FC_KiCadProj/3d/L_0805_2012Metric.step
01 - FC_KiCadProj/3d/L_0402_1005Metric.step
