ACwing-UAV/ACwing_HW/00 - Docs/02 - GPS_Docs/ACwing_GPS_A_schematic.pdf

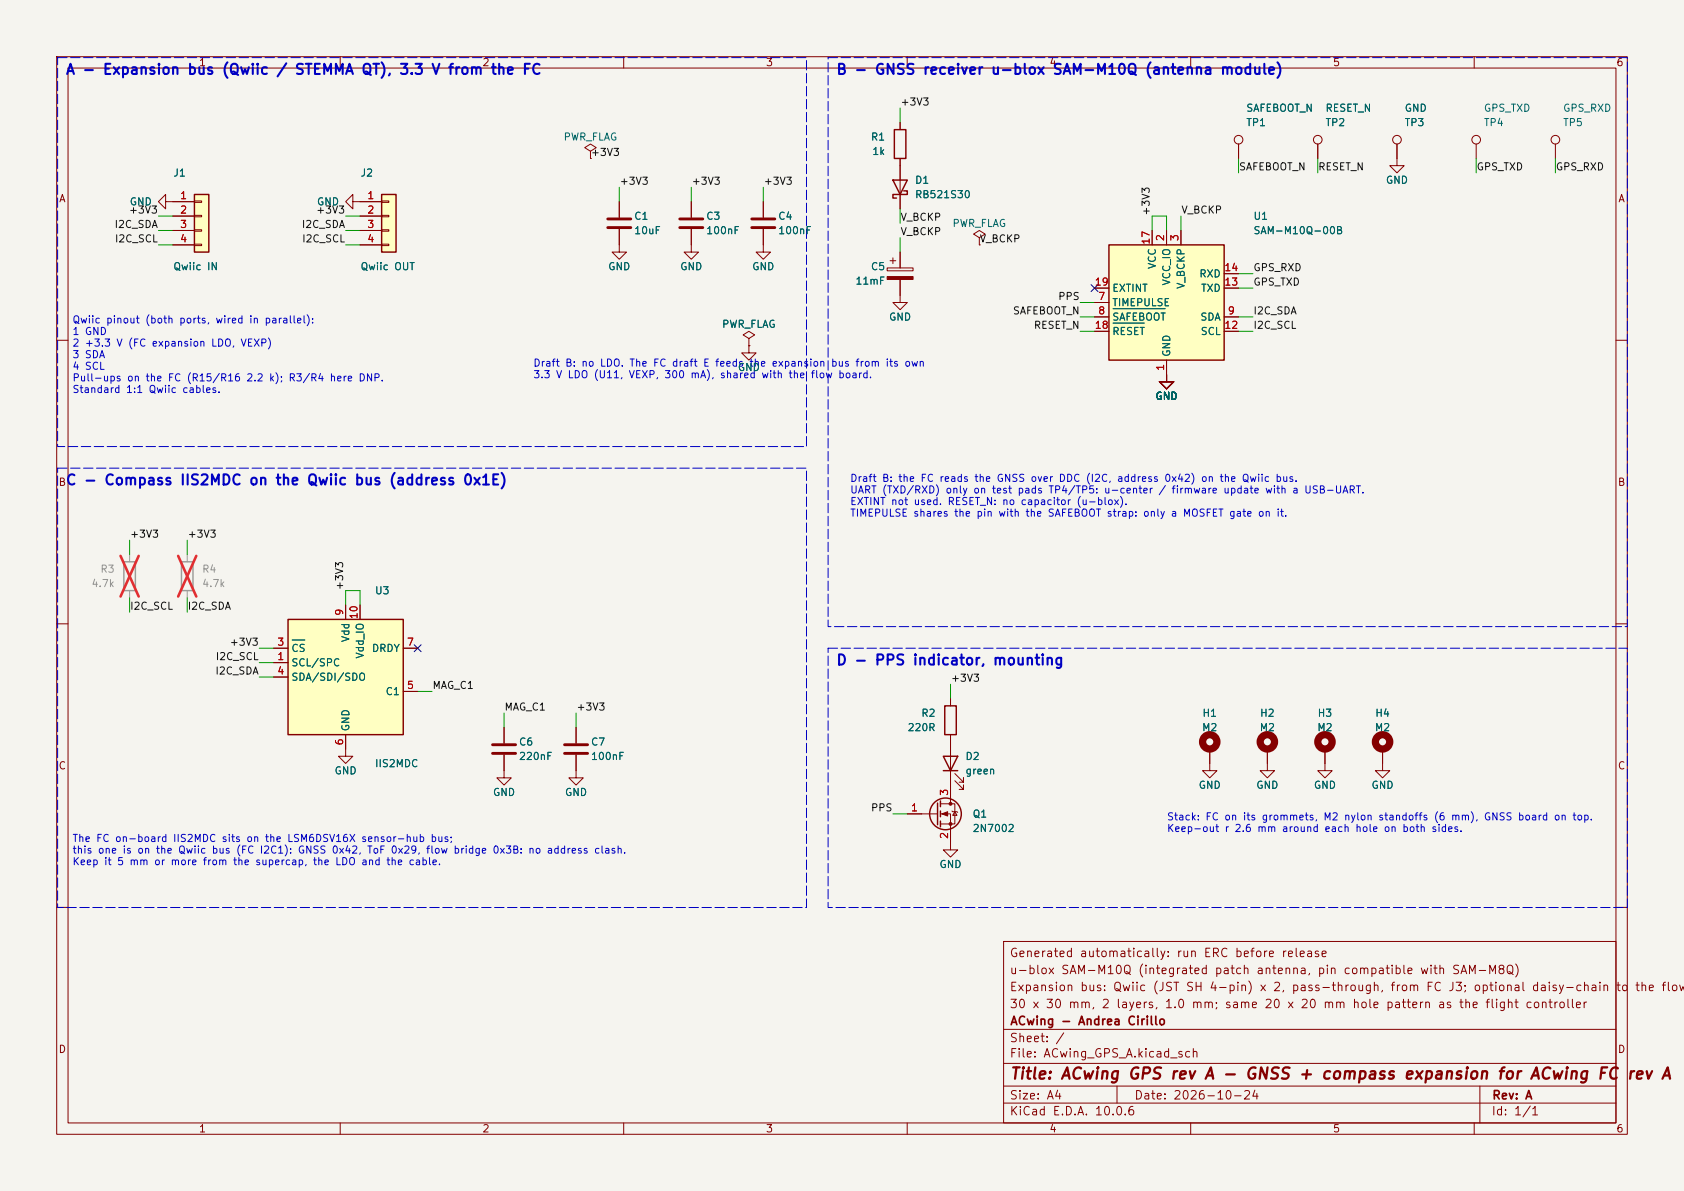
[picture p58: page 1]

Qwiic pinout (both ports, wired in parallel): 1 GND

Keep-out r 2.6 mm around each hole on both sides.

The FC on-board IIS2MDC sits on the LSM6DSV16X sensor-hub bus; this one is on the Qwiic bus (FC I2C1): GNSS 0x42, ToF 0x29, flow bridge 0x3B: no address clash. Keep it 5 mm or more from the supercap, the LDO and the cable.

Generated automatically: run ERC before release
u-blox SAM-M10Q (integrated patch antenna, pin compatible with SAM-M8Q)
30 x 30 mm, 2 layers, 1.0 mm; same 20 x 20 mm hole pattern as the flight controller
ACwing - Andrea Cirillo
Sheet: /
File: ACwing_GPS_A.kicad_sch
Title: ACwing GPS rev A - GNSS + compass expansion for ACwing FC rev A

Size: A4 | Rev: A
KiCad E.D.A. 10.0.6 | Id: 1/1
