ACwing-UAV/ACwing_HW/00 - Docs/03 - FLOW_Docs/ACwing_Flow_A_schematic.pdf

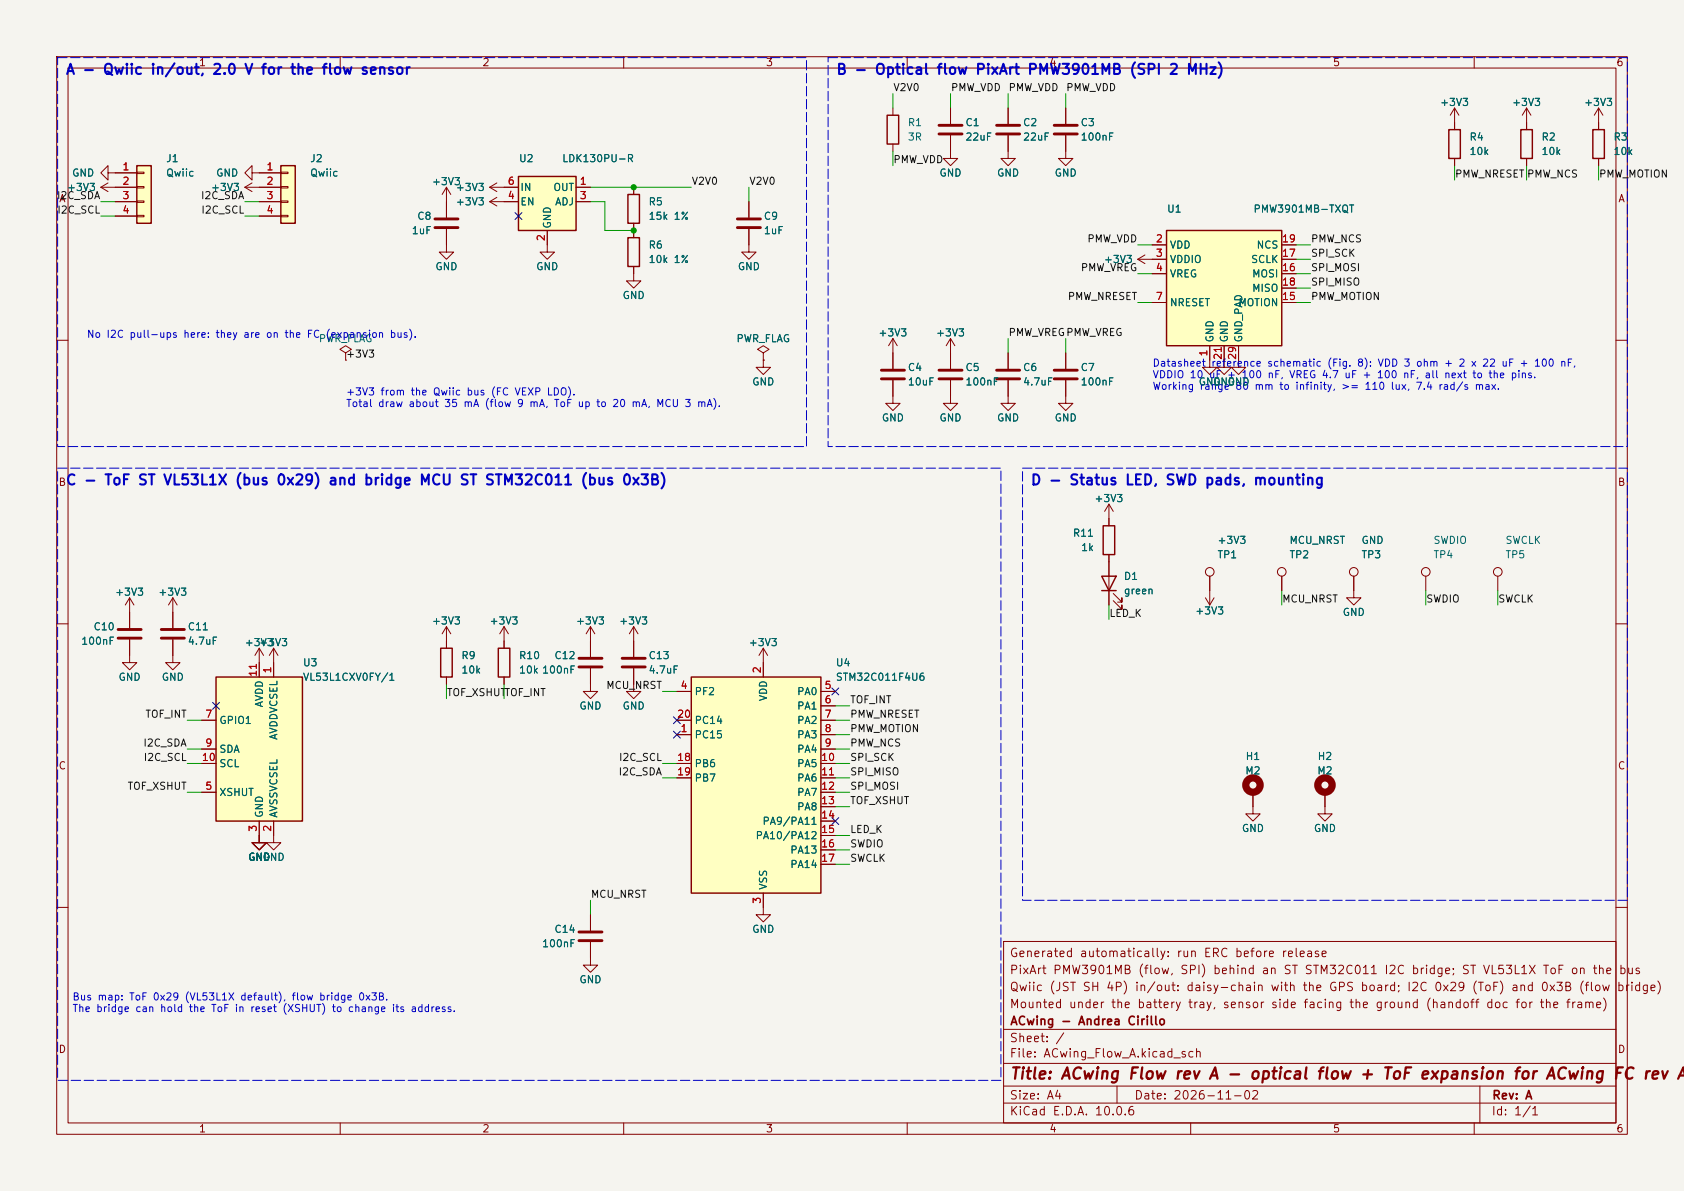
[picture p59: page 1]

100nF +3V3 GND +3V3 C10
No I2C pull-ups here: they are on the FC (expansion bus).

I2C_SCL +3V3 from the Qwiic bus (FC VEXP LDO). Total draw about 35 mA (flow 9 mA, ToF up to 20 mA, MCU 3 mA).

D - Status LED, SWD pads, mounting

Generated automatically: run ERC before release
Mounted under the battery tray, sensor side facing the ground (handoff doc for the frame)
ACwing - Andrea Cirillo
Sheet: /
File: ACwing_Flow_A.kicad_sch
Title: ACwing Flow rev A - optical flow + ToF expansion for ACwing FC rev A

Size: A4 | Rev: A
KiCad E.D.A. 10.0.6 | Id: 1/1
