ACwing-UAV/ACwing_HW/02 - ESC_1S_KiCadProj/ACwing_ESC1S_A.kicad_pcb

## KiCad design 02 - ESC_1S_KiCadProj/ACwing_ESC1S_A.kicad_pcb (2026-11-12)

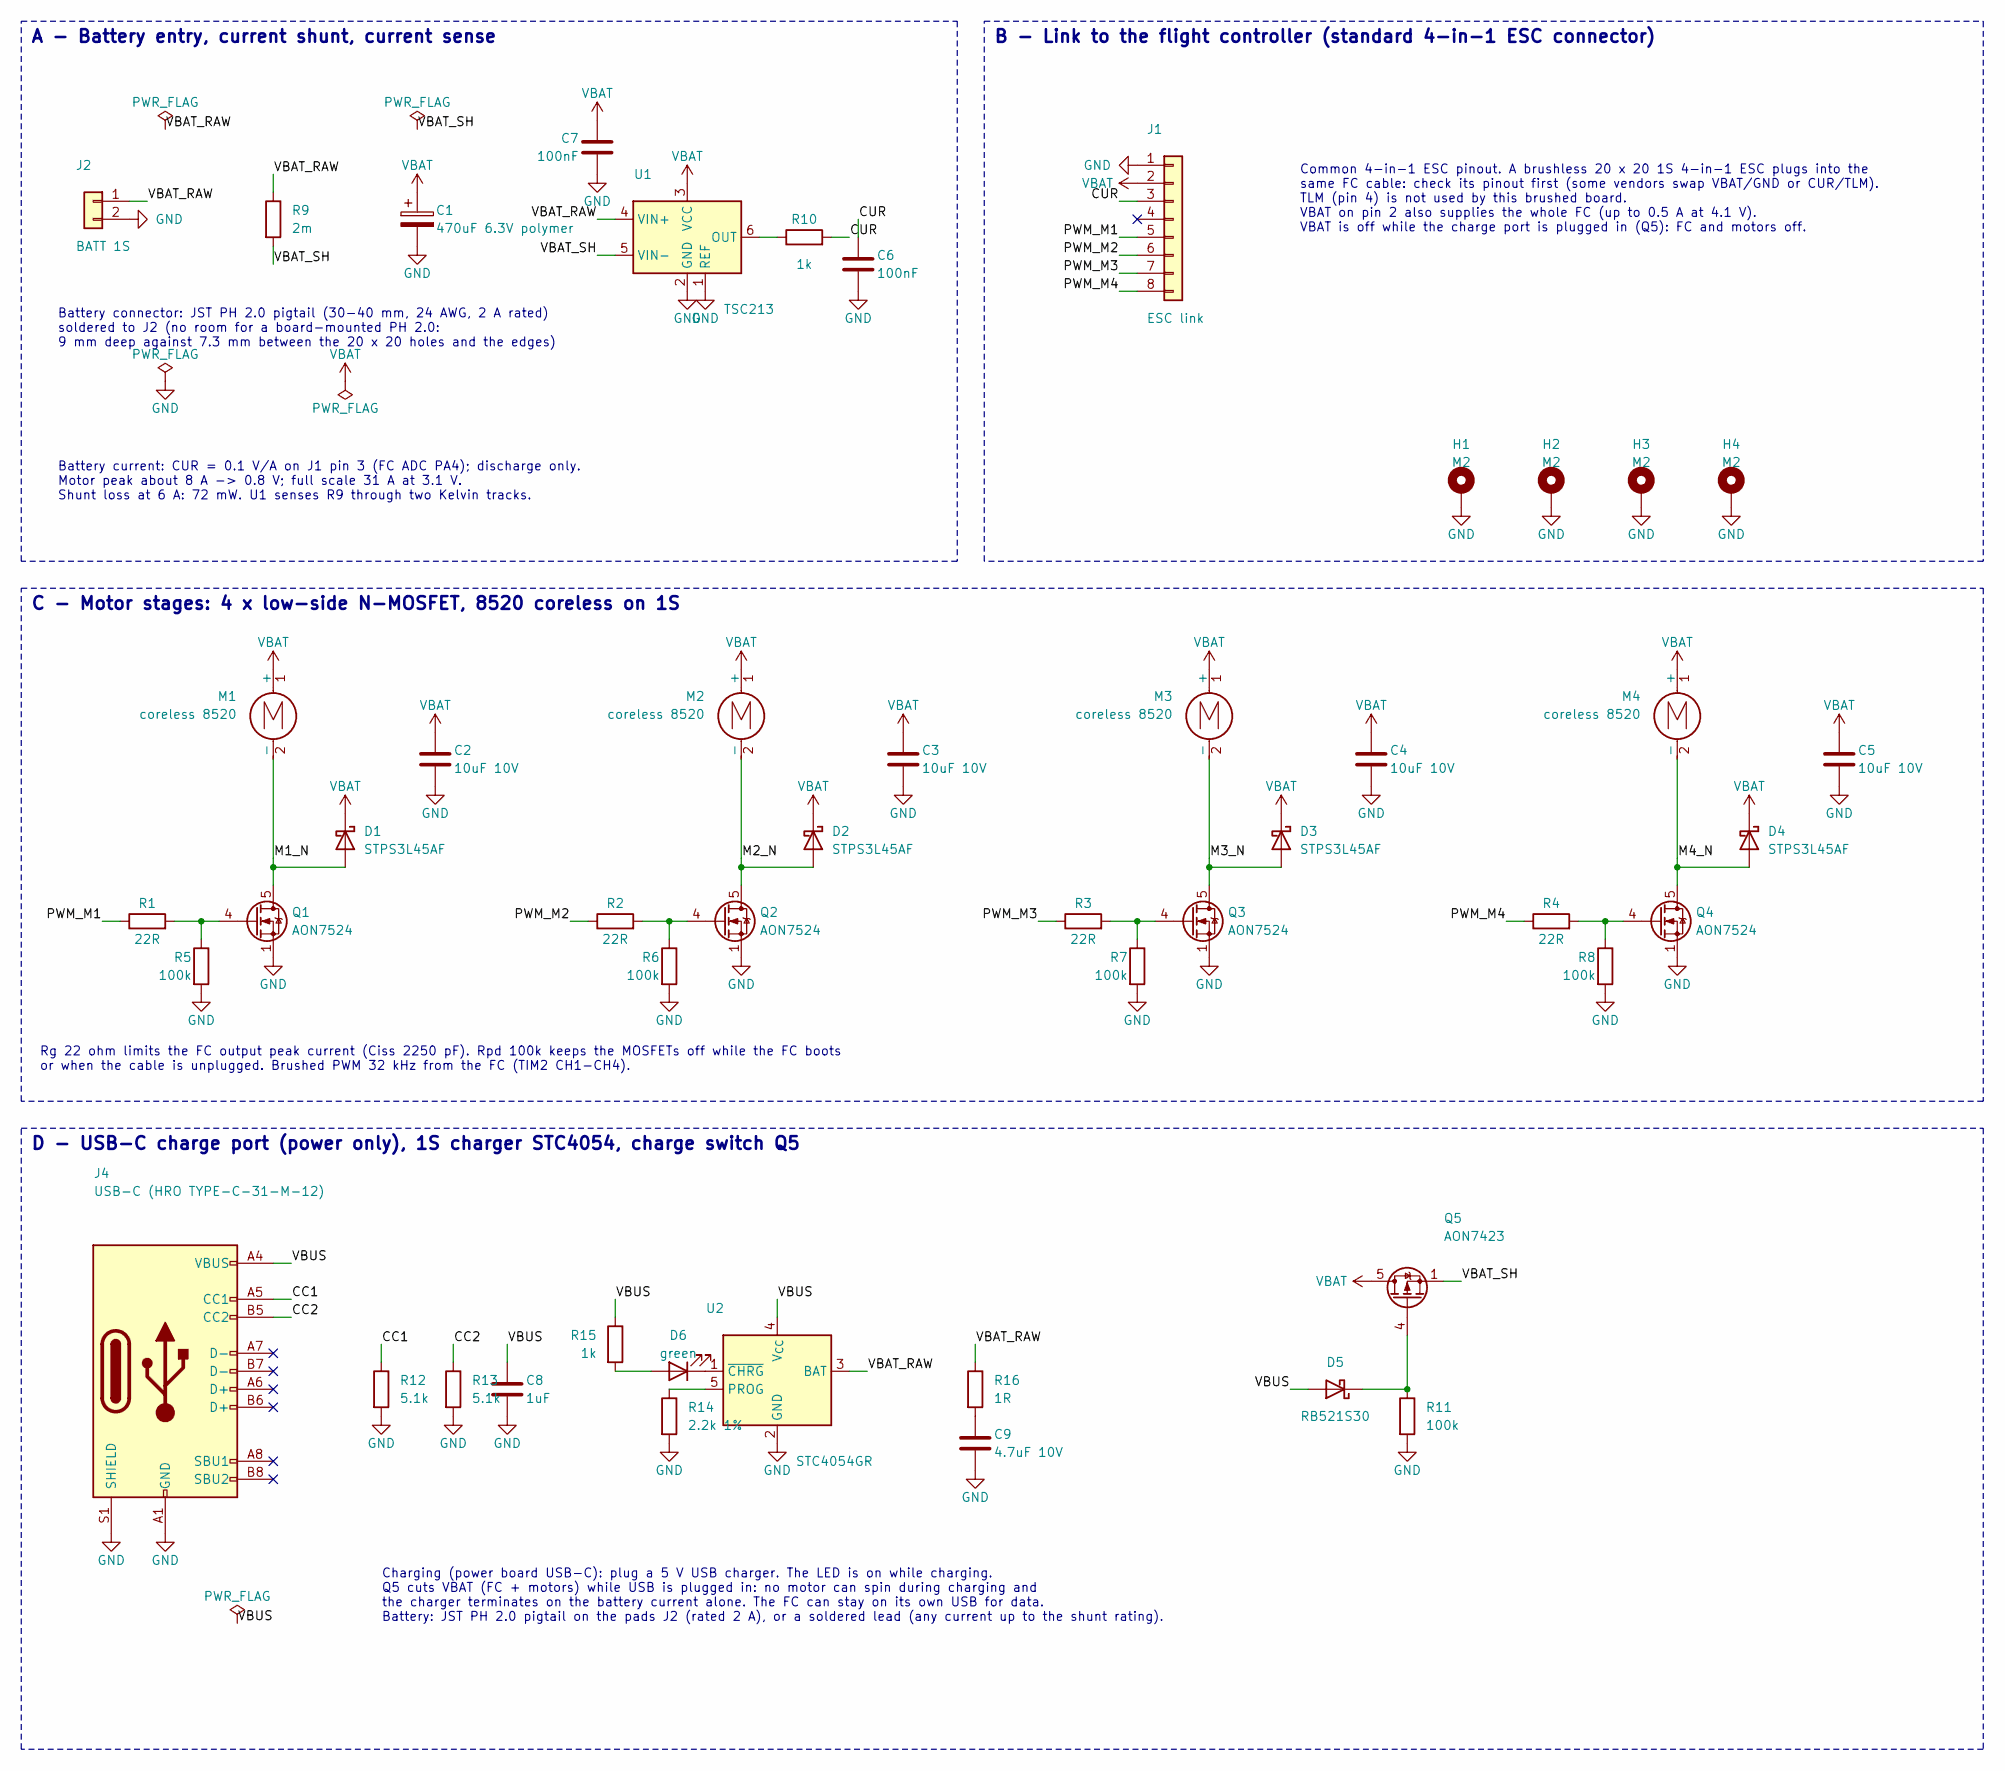
[picture p60: schematic ACwing_ESC1S_A.kicad_sch, ACwing ESC 1S rev A - 1S brushed power board with USB-C cha…]

Parts:
C1: 470uF 6.3V polymer; CP_EIA-7343-31_Kemet-D
C2, C3, C4, C5: 10uF 10V; C_0603_1608Metric
C6, C7: 100nF; C_0402_1005Metric
C8: 1uF; C_0402_1005Metric
C9: 4.7uF 10V; C_0603_1608Metric
D1, D2, D3, D4: STPS3L45AF; D_SMAflat
D5: RB521S30; D_SOD-523
D6: green; LED_0402_1005Metric
H1, H2, H3, H4: M2; MountingHole_PTH_2.2mm_M2_Pad3.6mm
J1: ESC link; JST_SH_SM08B-SRSS-TB_1x08-1MP_P1.00mm_Horizontal
J2: BATT 1S; BattPads_1x02_SMD
J4: USB-C (HRO TYPE-C-31-M-12); USB_C_Receptacle_HRO_TYPE-C-31-M-12
M1, M2, M3, M4: coreless 8520; MotorPads_1x02_SMD
Q1, Q2, Q3, Q4: AON7524; Vishay_PowerPAK_1212-8_Single
Q5: AON7423; Vishay_PowerPAK_1212-8_Single
R1, R2, R3, R4: 22R; R_0402_1005Metric
R5, R6, R7, R8, R11: 100k; R_0402_1005Metric
R9: 2m; R_1206_3216Metric
R10, R15: 1k; R_0402_1005Metric
R12, R13: 5.1k; R_0402_1005Metric
R14: 2.2k 1%; R_0402_1005Metric
R16: 1R; R_0402_1005Metric
U1: TSC213; SOT-363_SC-70-6
U2: STC4054GR; TSOT-23-5

Connections:
CC1: J4.A5 (CC1), R12.1
CC2: J4.B5 (CC2), R13.1
CUR: C6.1, J1.3, R10.2
GND: C1.2, C2.2, C3.2, C4.2, C5.2, C6.2, C7.2, C8.2, C9.2, H1.1, H2.1, H3.1, H4.1, J1.1, J2.2, J4.A1 (GND), J4.A12 (GND), J4.B1 (GND), J4.B12 (GND), J4.S1 (SHIELD), Q1.1 (S), Q1.2 (S), Q1.3 (S), Q2.1 (S), Q2.2 (S), Q2.3 (S), Q3.1 (S), Q3.2 (S), Q3.3 (S), Q4.1 (S), Q4.2 (S), Q4.3 (S), R5.2, R6.2, R7.2, R8.2, R11.2, R12.2, R13.2, R14.2, U1.1 (REF), U1.2 (GND), U2.2 (GND)
M1_N: D1.2 (A), M1.2 (-), Q1.5 (D)
M2_N: D2.2 (A), M2.2 (-), Q2.5 (D)
M3_N: D3.2 (A), M3.2 (-), Q3.5 (D)
M4_N: D4.2 (A), M4.2 (-), Q4.5 (D)
unnamed: C9.1, R16.2
unnamed: D5.1 (K), Q5.4 (G), R11.1
unnamed: D6.2 (A), R15.2
unnamed: D6.1 (K), U2.1 (~CHRG)
unnamed: Q1.4 (G), R1.2, R5.1
unnamed: Q2.4 (G), R2.2, R6.1
unnamed: Q3.4 (G), R3.2, R7.1
unnamed: Q4.4 (G), R4.2, R8.1
unnamed: R10.1, U1.6 (OUT)
unnamed: R14.1, U2.5 (PROG)
PWM_M1: J1.5, R1.1
PWM_M2: J1.6, R2.1
PWM_M3: J1.7, R3.1
PWM_M4: J1.8, R4.1
VBAT: C1.1, C2.1, C3.1, C4.1, C5.1, C7.1, D1.1 (K), D2.1 (K), D3.1 (K), D4.1 (K), J1.2, M1.1 (+), M2.1 (+), M3.1 (+), M4.1 (+), Q5.5 (D), U1.3 (VCC)
VBAT_RAW: J2.1, R9.1, R16.1, U1.4 (VIN+), U2.3 (BAT)
VBAT_SH: Q5.1 (S), Q5.2 (S), Q5.3 (S), R9.2, U1.5 (VIN-)
VBUS: C8.1, D5.2 (A), J4.A4 (VBUS), J4.A9 (VBUS), J4.B4 (VBUS), J4.B9 (VBUS), R15.1, U2.4 (V_{CC})

Notes on the sheet:
Common 4-in-1 ESC pinout. A brushless 20 x 20 1S 4-in-1 ESC plugs into the same FC cable: check its pinout first (some vendors swap VBAT/GND or CUR/TLM). TLM (pin 4) is not used by this brushed board. VBAT on pin 2 also supplies the whole FC (up to 0.5 A at 4.1 V). VBAT is off while the charge port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
C - Motor stages: 4 x low-side N-MOSFET, 8520 coreless on 1S
Charging (power board USB-C): plug a 5 V USB charger. The LED is on while charging. Q5 cuts VBAT (FC + motors) while USB is plugged in: no motor can spin during charging and the charger terminates on the battery current alone. The FC can stay on its own USB for data. Battery: JST PH 2.0 pigtail on 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
Battery connector: JST PH 2.0 pigtail (30-40 mm, 24 AWG, 2 A rated) soldered to J2 (no room for a board-mounted PH 2.0: 9 mm deep against 7.3 mm between the 20 x 20 holes and the edges)
Battery current: CUR = 0.1 V/A on J1 pin 3 (FC ADC PA4); discharge only. Motor peak about 8 A -> 0.8 V; full scale 31 A at 3.1 V. Shunt loss at 6 A: 72 mW. U1 senses R9 through two Kelvin tracks.
D - USB-C charge port (power only), 1S charger STC4054, charge switch Q5
A - Battery entry, current shunt, current sense
Rg 22 ohm limits the FC output peak current (Ciss 2250 pF). Rpd 100k keeps the MOSFETs off while the FC boots or when the cable is unplugged. Brushed PWM 32 kHz from the FC (TIM2 CH1-CH4).
B - Link to the flight controller (standard 4-in-1 ESC connector)

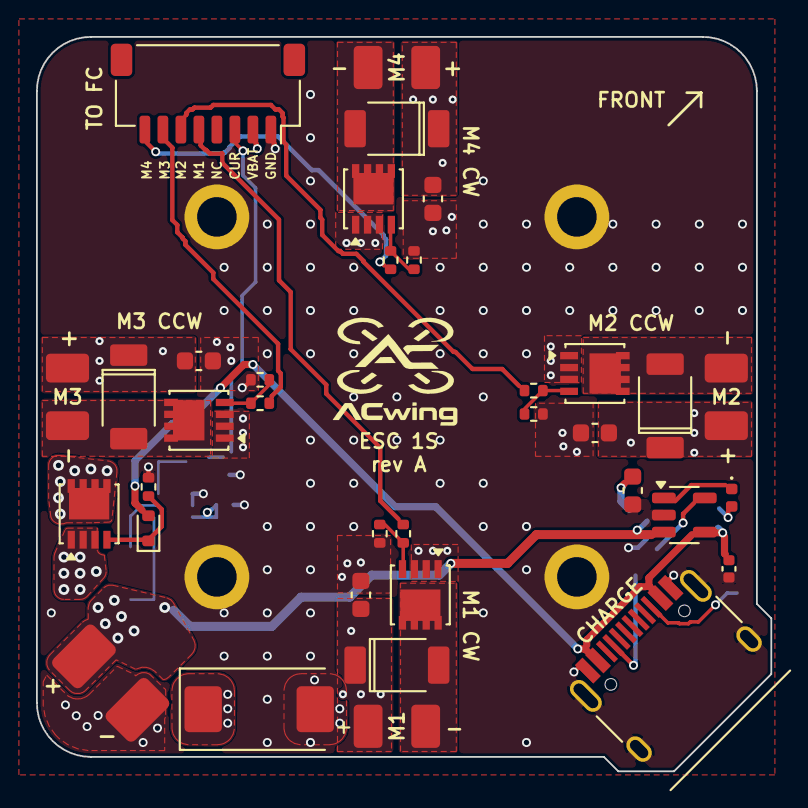
[picture p61: board ACwing_ESC1S_A.kicad_pcb from above]

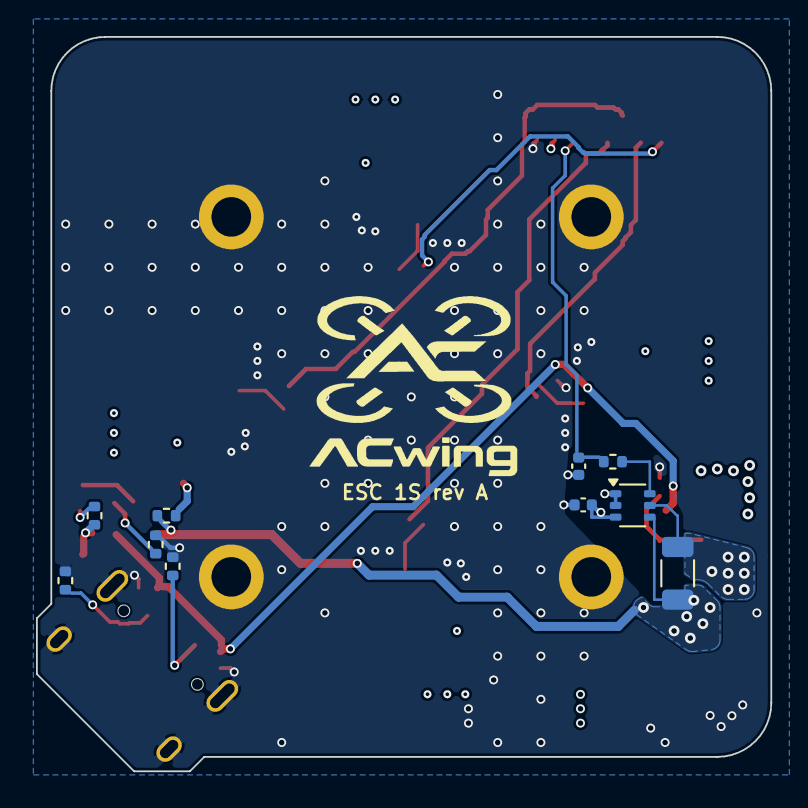
[picture p62: board ACwing_ESC1S_A.kicad_pcb from below]

Board: 4 copper layers, 40.8 x 40.8 mm, 51 parts (11 on the bottom side), 26 nets.

Other parts of the board:
LOGO1: ACwing_Logo_Full_6mm
LOGO2: ACwing_Logo_Full_10mm
