ACwing-UAV/ACwing_HW/01 - FC_KiCadProj/ACwing_FC_A.kicad_pcb

## KiCad design 01 - FC_KiCadProj/ACwing_FC_A.kicad_pcb (2026-11-12)

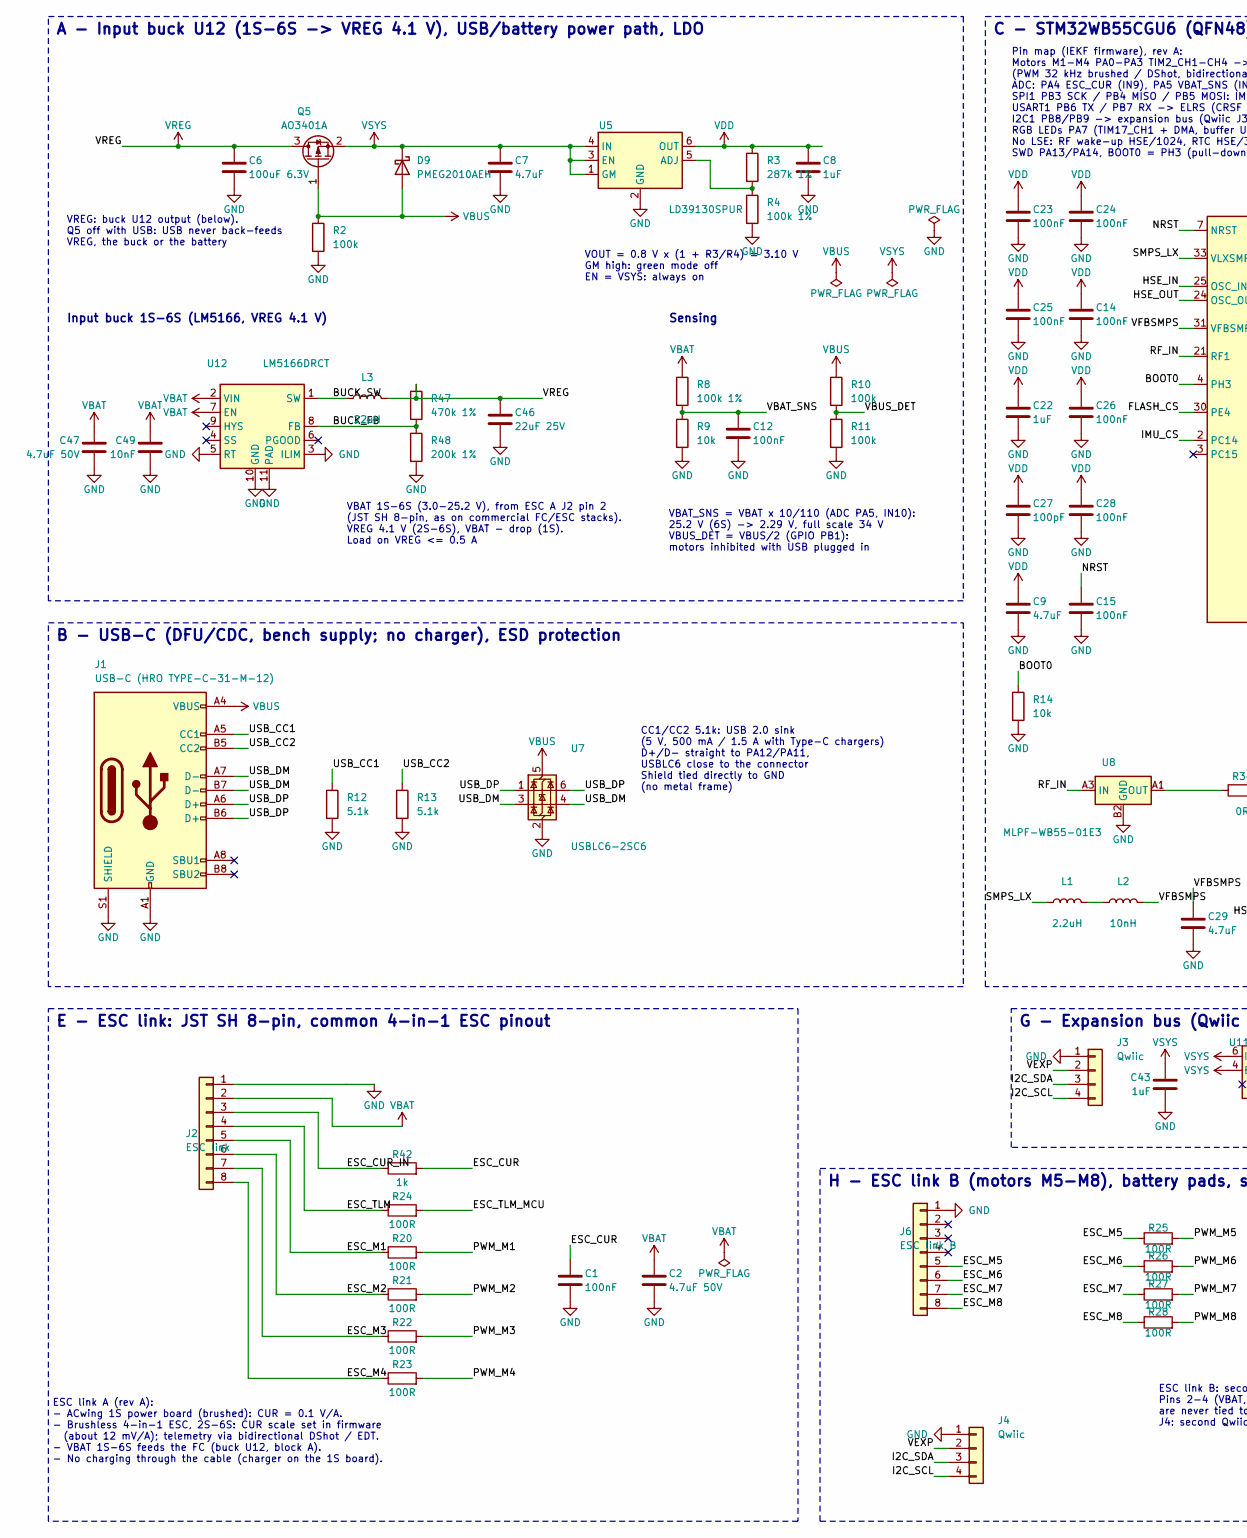
[picture p63: schematic ACwing_FC_A.kicad_sch, ACwing FC rev A - 1S-6S flight controller (STM32WB55CGU6), …, part in row 1, column 1]

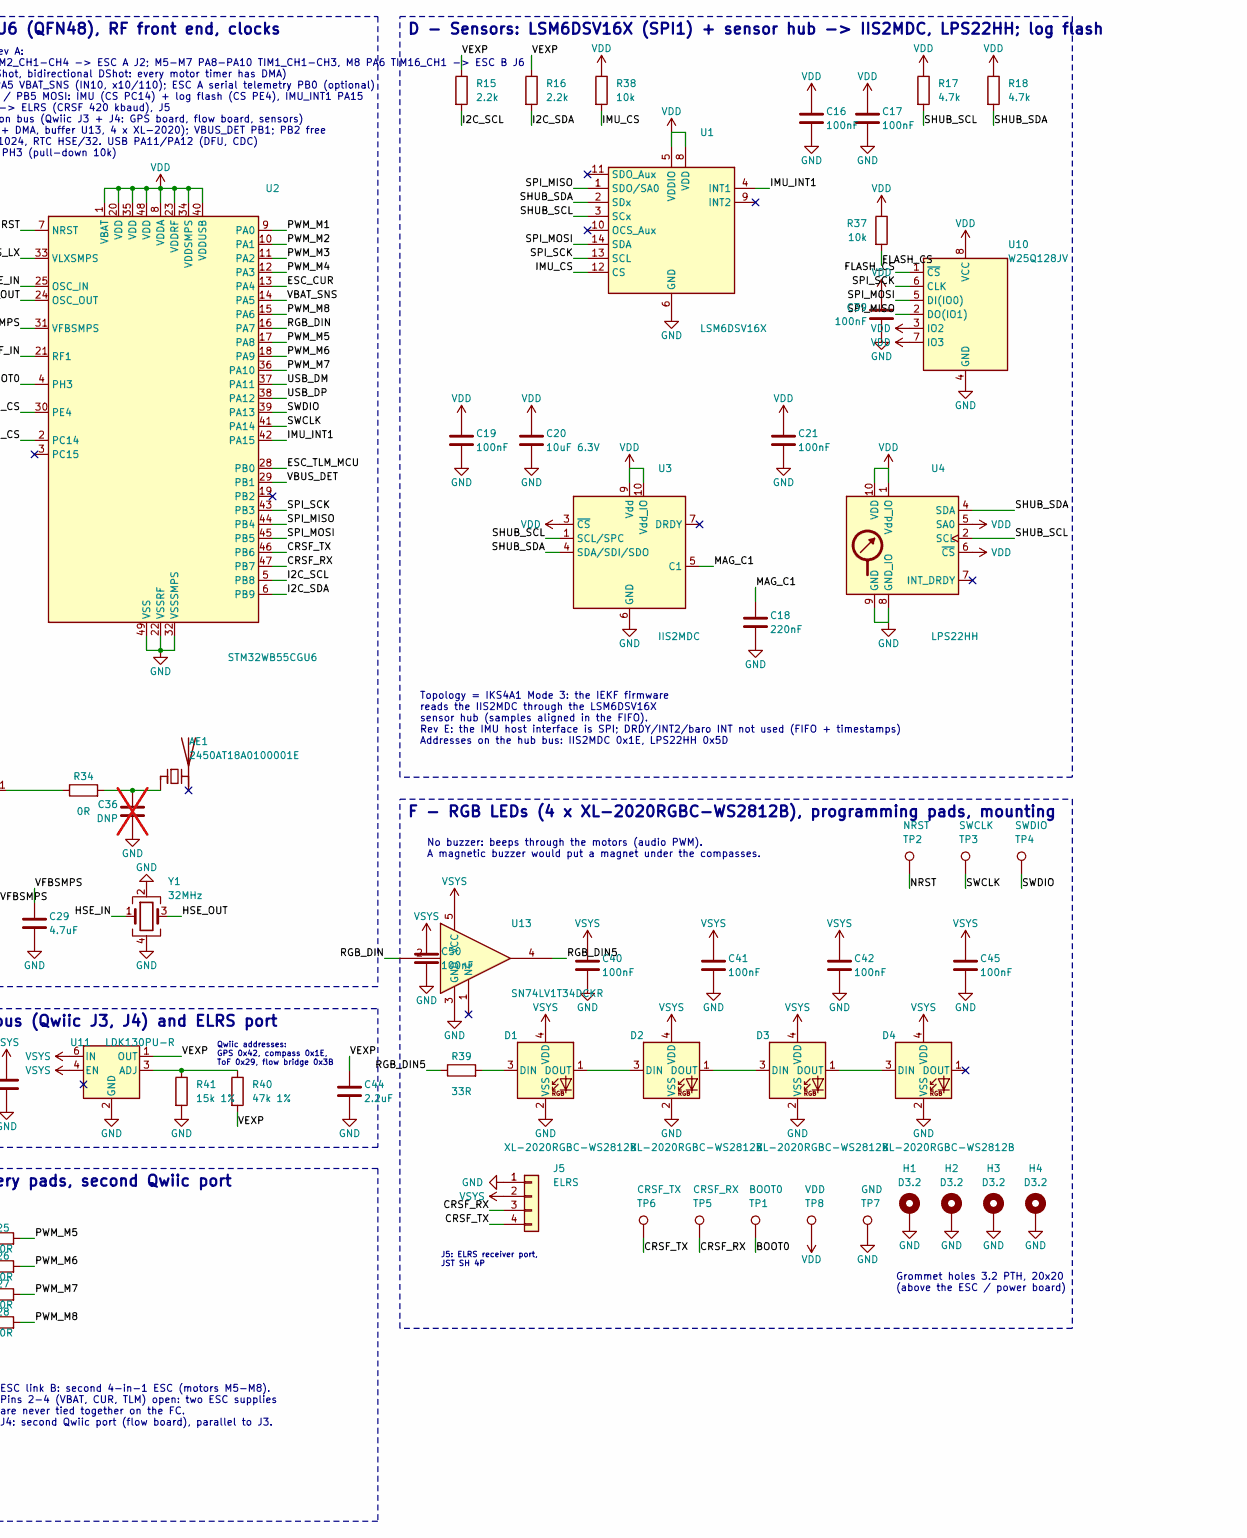
[picture p64: schematic ACwing_FC_A.kicad_sch, ACwing FC rev A - 1S-6S flight controller (STM32WB55CGU6), …, part in row 1, column 2]

Parts:
AE1: 2450AT18A0100001E; Johanson_2450AT18x100
C1, C12, C14, C15, C16, C17, C19, C21, C23, C24, C25, C26, C28, C39, C40, C41, C42, C45, C50: 100nF; C_0402_1005Metric
C2, C47: 4.7uF 50V; C_1206_3216Metric
C6: 100uF 6.3V; C_1206_3216Metric
C7, C9: 4.7uF; C_0603_1608Metric
C8, C22, C43: 1uF; C_0402_1005Metric
C18: 220nF; C_0402_1005Metric
C20: 10uF 6.3V; C_0603_1608Metric
C27: 100pF; C_0402_1005Metric
C29: 4.7uF; C_0402_1005Metric
C36: DNP; C_0402_1005Metric; not fitted
C44: 2.2uF; C_0402_1005Metric
C46: 22uF 25V; C_0805_2012Metric
C49: 10nF; C_0402_1005Metric
D1, D2, D3, D4: XL-2020RGBC-WS2812B; LED_WS2812B-2020_PLCC4_2.0x2.0mm
D9: PMEG2010AEH; D_SOD-123F
H1, H2, H3, H4: D3.2; Grommet_PTH_3.2mm_Pad5.0mm
J1: USB-C (HRO TYPE-C-31-M-12); USB_C_Receptacle_HRO_TYPE-C-31-M-12
J2: ESC link; JST_SH_SM08B-SRSS-TB_1x08-1MP_P1.00mm_Horizontal
J3, J4: Qwiic; JST_SH_SM04B-SRSS-TB_1x04-1MP_P1.00mm_Horizontal
J5: ELRS; JST_SH_SM04B-SRSS-TB_1x04-1MP_P1.00mm_Horizontal
J6: ESC link B; JST_SH_SM08B-SRSS-TB_1x08-1MP_P1.00mm_Horizontal
L1: 2.2uH; L_0805_2012Metric
L2: 10nH; L_0402_1005Metric
L3: 22uH; L_Sunlord_SWPA5040S
Q5: AO3401A; SOT-23
R2, R10, R11: 100k; R_0402_1005Metric
R3: 287k 1%; R_0402_1005Metric
R4, R8: 100k 1%; R_0402_1005Metric
R9, R14, R37, R38: 10k; R_0402_1005Metric
R12, R13: 5.1k; R_0402_1005Metric
R15, R16: 2.2k; R_0402_1005Metric
R17, R18: 4.7k; R_0402_1005Metric
R20, R21, R22, R23, R24, R25, R26, R27, R28: 100R; R_0402_1005Metric
R34: 0R; R_0402_1005Metric
R39: 33R; R_0402_1005Metric
R40: 47k 1%; R_0402_1005Metric
R41: 15k 1%; R_0402_1005Metric
R42: 1k; R_0402_1005Metric
R47: 470k 1%; R_0402_1005Metric
R48: 200k 1%; R_0402_1005Metric
TP1: BOOT0; TestPoint_Pad_D1.0mm
TP2: NRST; TestPoint_Pad_D1.0mm
TP3: SWCLK; TestPoint_Pad_D1.0mm
TP4: SWDIO; TestPoint_Pad_D1.0mm
TP5: CRSF_RX; TestPoint_Pad_D1.0mm
TP6: CRSF_TX; TestPoint_Pad_D1.0mm
TP7: GND; TestPoint_Pad_D1.0mm
TP8: VDD; TestPoint_Pad_D1.0mm
U1: LSM6DSV16X; LGA-14_3x2.5mm_P0.5mm_LayoutBorder3x4y
U2: STM32WB55CGU6; QFN-48-1EP_7x7mm_P0.5mm_EP5.6x5.6mm
U3: IIS2MDC; LGA-12_2x2mm_P0.5mm
U4: LPS22HH; ST_HLGA-10_2x2mm_P0.5mm_LayoutBorder3x2y
U5: LD39130SPUR; DFN-6_1.3x1.2mm_P0.4mm
U7: USBLC6-2SC6; SOT-23-6
U8: MLPF-WB55-01E3; ST_MLPF-WB55-01E3_CSP-6
U10: W25Q128JV; WSON-8-1EP_6x5mm_P1.27mm_EP3.4x4mm
U11: LDK130PU-R; DFN-6_1.3x1.2mm_P0.4mm
U12: LM5166DRCT; Texas_DRC0010J
U13: SN74LV1T34DCKR; SOT-353_SC-70-5
Y1: 32MHz; Crystal_SMD_2016-4Pin_2.0x1.6mm

Connections:
BOOT0: R14.1, TP1.1, U2.4 (PH3)
BUCK_FB: R47.2, R48.1, U12.8 (FB)
BUCK_SW: L3.1, U12.1 (SW)
CRSF_RX: J5.3, TP5.1, U2.47 (PB7)
CRSF_TX: J5.4, TP6.1, U2.46 (PB6)
ESC_CUR: C1.1, R42.2, U2.13 (PA4)
ESC_CUR_IN: J2.3, R42.1
ESC_M1: J2.5, R20.1
ESC_M2: J2.6, R21.1
ESC_M3: J2.7, R22.1
ESC_M4: J2.8, R23.1
ESC_M5: J6.5, R25.1
ESC_M6: J6.6, R26.1
ESC_M7: J6.7, R27.1
ESC_M8: J6.8, R28.1
ESC_TLM: J2.4, R24.1
ESC_TLM_MCU: R24.2, U2.28 (PB0)
FLASH_CS: R37.2, U2.30 (PE4), U10.1 (~CS)
GND: C1.2, C2.2, C6.2, C7.2, C8.2, C9.2, C12.2, C14.2, C15.2, C16.2, C17.2, C18.2, C19.2, C20.2, C21.2, C22.2, C23.2, C24.2, C25.2, C26.2, C27.2, C28.2, C29.2, C36.2, C39.2, C40.2, C41.2, C42.2, C43.2, C44.2, C45.2, C46.2, C47.2, C49.2, C50.2, D1.2 (VSS), D2.2 (VSS), D3.2 (VSS), D4.2 (VSS), H1.1, H2.1, H3.1, H4.1, J1.A1 (GND), J1.A12 (GND), J1.B1 (GND), J1.B12 (GND), J1.S1 (SHIELD), J2.1, J3.1, J4.1, J5.1, J6.1, R2.2, R4.2, R9.2, R11.2, R12.2, R13.2, R14.2, R41.2, R48.2, TP7.1, U1.6 (GND), U1.7 (GND), U2.22 (VSSRF), U2.32 (VSSSMPS), U2.49 (VSS), U3.6 (GND), U3.8 (GND), U4.3 (GND), U4.8 (GND_IO), U4.9 (GND), U5.2 (GND), U7.2 (GND), U8.A2 (GND), U8.B1 (GND), U8.B2 (GND), U8.B3 (GND), U10.4 (GND), U11.2 (GND), U12.3 (ILIM), U12.5 (RT), U12.10 (GND), U12.11 (PAD), U13.3 (GND), Y1.2, Y1.4
HSE_IN: U2.25 (OSC_IN), Y1.1
HSE_OUT: U2.24 (OSC_OUT), Y1.3
I2C_SCL: J3.4, J4.4, R15.2, U2.5 (PB8)
I2C_SDA: J3.3, J4.3, R16.2, U2.6 (PB9)
IMU_CS: R38.2, U1.12 (CS), U2.2 (PC14)
IMU_INT1: U1.4 (INT1), U2.42 (PA15)
MAG_C1: C18.1, U3.5 (C1)
NRST: C15.1, TP2.1, U2.7 (NRST)
unnamed: AE1.1 (FEED), C36.1, R34.2
unnamed: D1.3 (DIN), R39.2
unnamed: D1.1 (DOUT), D2.3 (DIN)
unnamed: D2.1 (DOUT), D3.3 (DIN)
unnamed: D3.1 (DOUT), D4.3 (DIN)
unnamed: L1.2, L2.1
unnamed: R3.2, R4.1, U5.5 (ADJ)
unnamed: R34.1, U8.A1 (OUT)
unnamed: R40.1, R41.1, U11.3 (ADJ)
PWM_M1: R20.2, U2.9 (PA0)
PWM_M2: R21.2, U2.10 (PA1)
PWM_M3: R22.2, U2.11 (PA2)
PWM_M4: R23.2, U2.12 (PA3)
PWM_M5: R25.2, U2.17 (PA8)
PWM_M6: R26.2, U2.18 (PA9)
PWM_M7: R27.2, U2.36 (PA10)
PWM_M8: R28.2, U2.15 (PA6)
RF_IN: U2.21 (RF1), U8.A3 (IN)
RGB_DIN: U2.16 (PA7), U13.2
RGB_DIN5: R39.1, U13.4
SHUB_SCL: R17.2, U1.3 (SCx), U3.1 (SCL/SPC), U4.2 (SCL)
SHUB_SDA: R18.2, U1.2 (SDx), U3.4 (SDA/SDI/SDO), U4.4 (SDA)
SMPS_LX: L1.1, U2.33 (VLXSMPS)
SPI_MISO: U1.1 (SDO/SA0), U2.44 (PB4), U10.2 (DO(IO1))
SPI_MOSI: U1.14 (SDA), U2.45 (PB5), U10.5 (DI(IO0))
SPI_SCK: U1.13 (SCL), U2.43 (PB3), U10.6 (CLK)
SWCLK: TP3.1, U2.41 (PA14)
SWDIO: TP4.1, U2.39 (PA13)
USB_CC1: J1.A5 (CC1), R12.1
USB_CC2: J1.B5 (CC2), R13.1
USB_DM: J1.A7 (D-), J1.B7 (D-), U2.37 (PA11), U7.3 (I/O2), U7.4 (I/O2)
USB_DP: J1.A6 (D+), J1.B6 (D+), U2.38 (PA12), U7.1 (I/O1), U7.6 (I/O1)
VBAT: C2.1, C47.1, C49.1, J2.2, R8.1, U12.2 (VIN), U12.7 (EN)
VBAT_SNS: C12.1, R8.2, R9.1, U2.14 (PA5)
VBUS: D9.2 (A), J1.A4 (VBUS), J1.A9 (VBUS), J1.B4 (VBUS), J1.B9 (VBUS), Q5.1 (G), R2.1, R10.1, U7.5 (VBUS)
VBUS_DET: R10.2, R11.1, U2.29 (PB1)
VDD: C8.1, C9.1, C14.1, C16.1, C17.1, C19.1, C20.1, C21.1, C22.1, C23.1, C24.1, C25.1, C26.1, C27.1, C28.1, C39.1, R3.1, R17.1, R18.1, R37.1, R38.1, TP8.1, U1.5 (VDDIO), U1.8 (VDD), U2.1 (VBAT), U2.8 (VDDA), U2.20 (VDD), U2.23 (VDDRF), U2.34 (VDDSMPS), U2.35 (VDD), U2.40 (VDDUSB), U2.48 (VDD), U3.3 (~CS), U3.9 (Vdd), U3.10 (Vdd_IO), U4.1 (Vdd_IO), U4.5 (SA0), U4.6 (~CS), U4.10 (VDD), U5.6 (OUT), U10.3 (IO2), U10.7 (IO3), U10.8 (VCC)
VEXP: C44.1, J3.2, J4.2, R15.1, R16.1, R40.2, U11.1 (OUT)
VFBSMPS: C29.1, L2.2, U2.31 (VFBSMPS)
VREG: C6.1, C46.1, L3.2, Q5.3 (D), R47.1
VSYS: C7.1, C40.1, C41.1, C42.1, C43.1, C45.1, C50.1, D1.4 (VDD), D2.4 (VDD), D3.4 (VDD), D4.4 (VDD), D9.1 (K), J5.2, Q5.2 (S), U5.1 (GM), U5.3 (EN), U5.4 (IN), U11.4 (EN), U11.6 (IN), U13.5 (VCC)

Notes on the sheet:
ESC link B: second 4-in-1 ESC (motors M5-M8). Pins 2-4 (VBAT, CUR, TLM) open: two ESC supplies are never tied together on the FC. J4: second Qwiic port (flow board), parallel to J3.
F - RGB LEDs (4 x XL-2020RGBC-WS2812B), programming pads, mounting
VOUT = 0.8 V x (1 + R3/R4) = 3.10 V GM high: green mode off EN = VSYS: always on
A - Input buck U12 (1S-6S -> VREG 4.1 V), USB/battery power path, LDO
ESC link A (rev A): - ACwing 1S power board (brushed): CUR = 0.1 V/A. - Brushless 4-in-1 ESC, 2S-6S: CUR scale set in firmware (about 12 mV/A); telemetry via bidirectional DShot / EDT. - VBAT 1S-6S feeds the FC (buck U12, block A). - No charging through the cable (charger on the 1S board).
Grommet holes 3.2 PTH, 20x20 (above the ESC / power board)
B - USB-C (DFU/CDC, bench supply; no charger), ESD protection
D - Sensors: LSM6DSV16X (SPI1) + sensor hub -> IIS2MDC, LPS22HH; log flash
Pin map (IEKF firmware), rev A: Motors M1-M4 PA0-PA3 TIM2_CH1-CH4 -> ESC A J2; M5-M7 PA8-PA10 TIM1_CH1-CH3, M8 PA6 TIM16_CH1 -> ESC B J6 (PWM 32 kHz brushed / DShot, bidirectional DShot: every motor timer has DMA) ADC: PA4 ESC_CUR (IN9), PA5 VBAT_SNS (IN10, x10/110); ESC A serial telemetry PB0 (opt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
VBAT_SNS = VBAT x 10/110 (ADC PA5, IN10): 25.2 V (6S) -> 2.29 V, full scale 34 V VBUS_DET = VBUS/2 (GPIO PB1): motors inhibited with USB plugged in
Qwiic addresses: GPS 0x42, compass 0x1E, ToF 0x29, flow bridge 0x3B
J5: ELRS receiver port, JST SH 4P
Sensing
VREG: buck U12 output (below). Q5 off with USB: USB never back-feeds VREG, the buck or the battery
H - ESC link B (motors M5-M8), battery pads, second Qwiic port
No buzzer: beeps through the motors (audio PWM). A magnetic buzzer would put a magnet under the compasses.
E - ESC link: JST SH 8-pin, common 4-in-1 ESC pinout
C - STM32WB55CGU6 (QFN48), RF front end, clocks
CC1/CC2 5.1k: USB 2.0 sink (5 V, 500 mA / 1.5 A with Type-C chargers) D+/D- straight to PA12/PA11, USBLC6 close to the connector Shield tied directly to GND (no metal frame)
Topology = IKS4A1 Mode 3: the IEKF firmware reads the IIS2MDC through the LSM6DSV16X sensor hub (samples aligned in the FIFO). Rev E: the IMU host interface is SPI; DRDY/INT2/baro INT not used (FIFO + timestamps) Addresses on the hub bus: IIS2MDC 0x1E, LPS22HH 0x5D
VBAT 1S-6S (3.0-25.2 V), from ESC A J2 pin 2 (JST SH 8-pin, as on commercial FC/ESC stacks). VREG 4.1 V (2S-6S), VBAT - drop (1S). Load on VREG <= 0.5 A
G - Expansion bus (Qwiic J3, J4) and ELRS port
Input buck 1S-6S (LM5166, VREG 4.1 V)

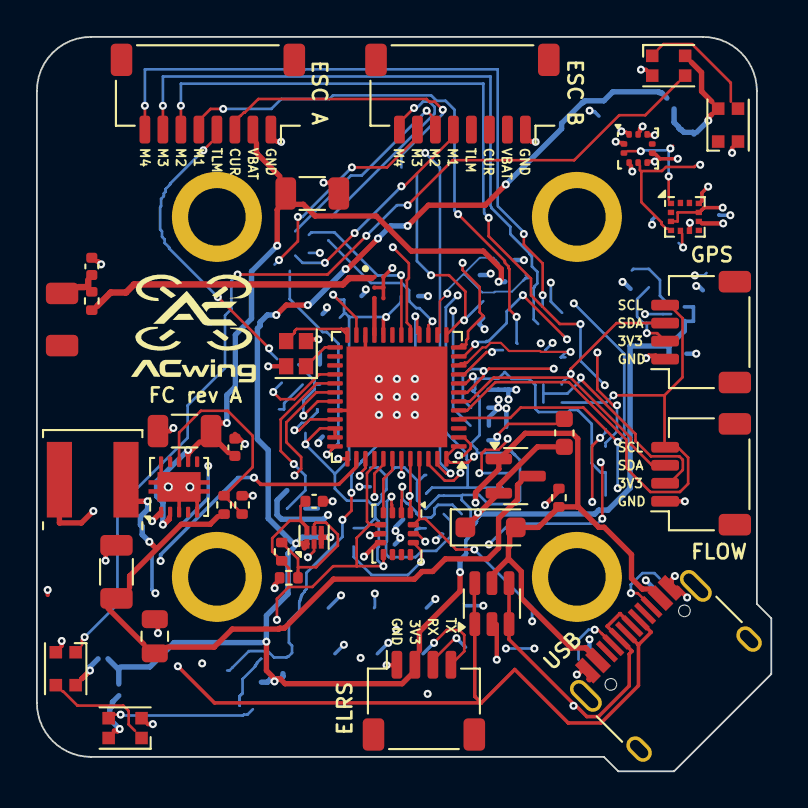
[picture p65: board ACwing_FC_A.kicad_pcb from above]

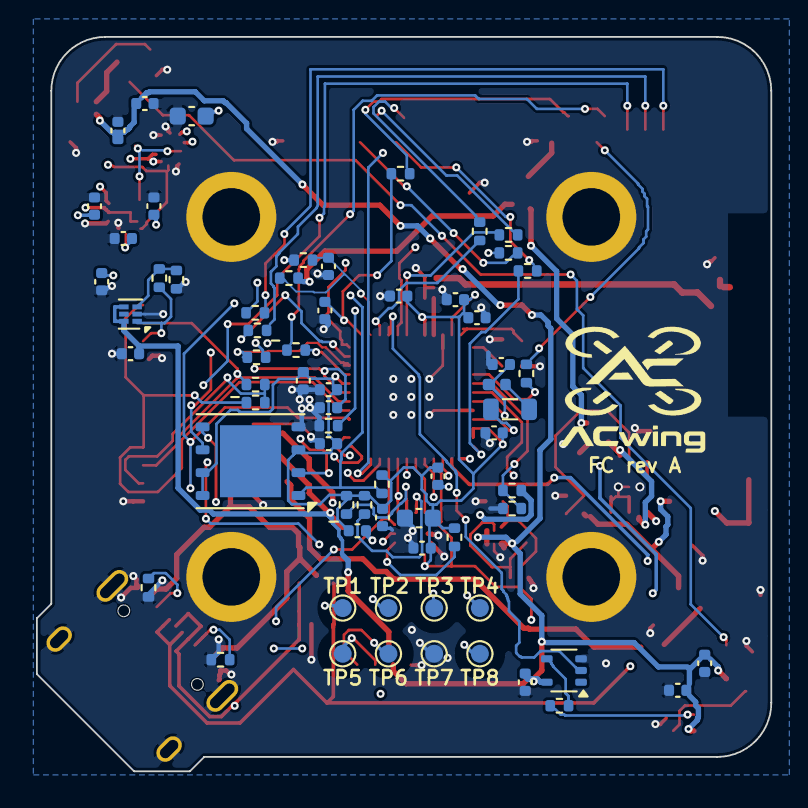
[picture p66: board ACwing_FC_A.kicad_pcb from below]

Board: 4 copper layers, 40.8 x 40.8 mm, 109 parts (67 on the bottom side), 68 nets.

Other parts of the board:
LOGO1: ACwing_Logo_Full_6mm
LOGO2: ACwing_Logo_Full_7mm
