ACwing-UAV/ACwing_HW/03 - GPS_KiCadProj/ACwing_GPS_A.kicad_pcb

## KiCad design 03 - GPS_KiCadProj/ACwing_GPS_A.kicad_pcb (2026-11-12)

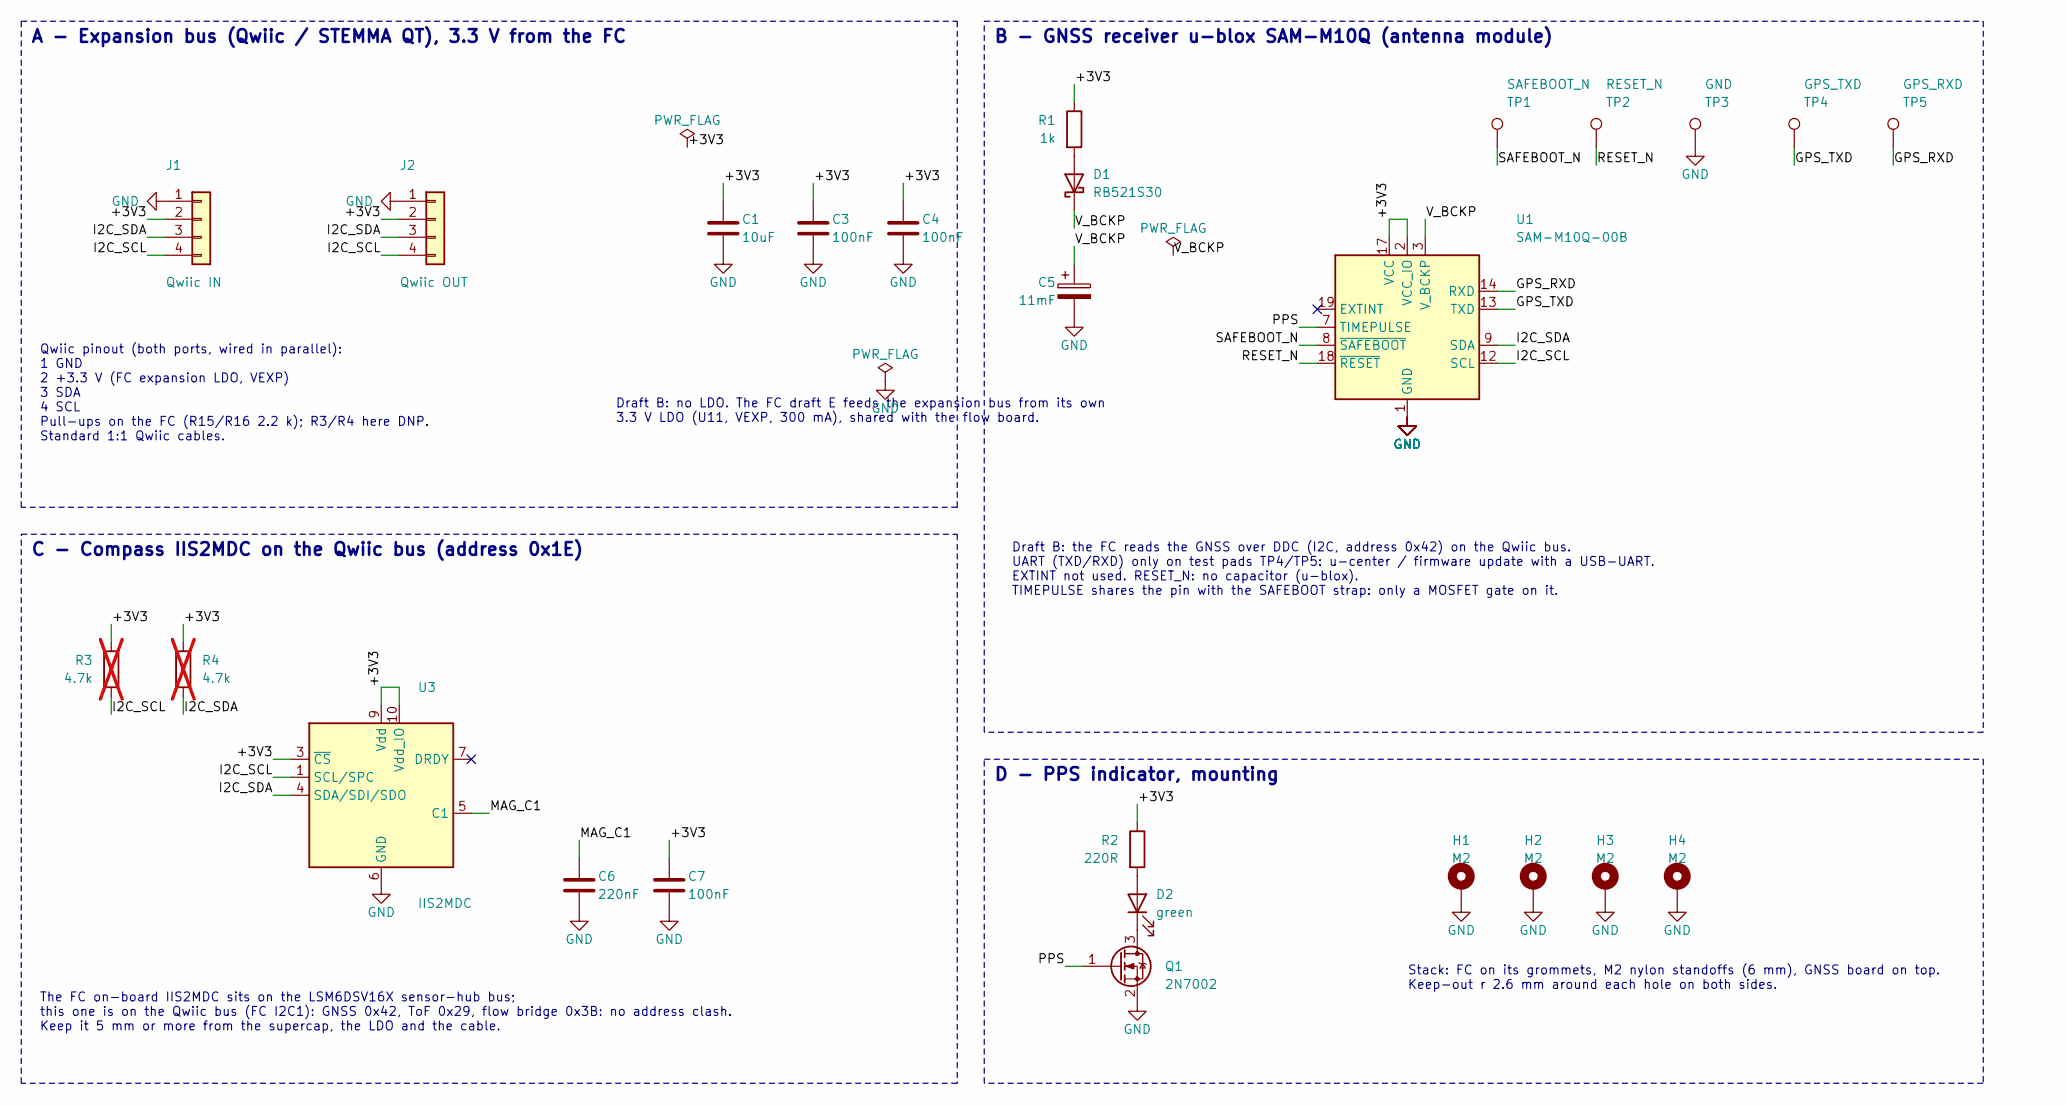
[picture p67: schematic ACwing_GPS_A.kicad_sch, ACwing GPS rev A - GNSS + compass expansion for ACwing FC r…]

Parts:
C1: 10uF; C_0603_1608Metric
C3, C4, C7: 100nF; C_0402_1005Metric
C5: 11mF; C_1210_3225Metric
C6: 220nF; C_0402_1005Metric
D1: RB521S30; D_SOD-523
D2: green; LED_0402_1005Metric
H1, H2, H3, H4: M2; MountingHole_PTH_2.2mm_M2_Pad3.6mm
J1: Qwiic IN; JST_SH_SM04B-SRSS-TB_1x04-1MP_P1.00mm_Horizontal
J2: Qwiic OUT; JST_SH_SM04B-SRSS-TB_1x04-1MP_P1.00mm_Horizontal
Q1: 2N7002; SOT-23
R1: 1k; R_0402_1005Metric
R2: 220R; R_0402_1005Metric
R3, R4: 4.7k; R_0402_1005Metric; not fitted
TP1: SAFEBOOT_N; TestPoint_Pad_D1.0mm
TP2: RESET_N; TestPoint_Pad_D1.0mm
TP3: GND; TestPoint_Pad_D1.0mm
TP4: GPS_TXD; TestPoint_Pad_D1.0mm
TP5: GPS_RXD; TestPoint_Pad_D1.0mm
U1: SAM-M10Q-00B; ublox_SAM-M8Q
U3: IIS2MDC; LGA-12_2x2mm_P0.5mm

Connections:
+3V3: C1.1, C3.1, C4.1, C7.1, J1.2, J2.2, R1.1, R2.1, R3.1, R4.1, U1.2 (VCC_IO), U1.17 (VCC), U3.3 (~CS), U3.9 (Vdd), U3.10 (Vdd_IO)
GND: C1.2, C3.2, C4.2, C5.2, C6.2, C7.2, H1.1, H2.1, H3.1, H4.1, J1.1, J2.1, Q1.2 (S), TP3.1, U1.1 (GND), U1.4 (GND), U1.5 (GND), U1.6 (GND), U1.10 (GND), U1.11 (GND), U1.15 (GND), U1.16 (GND), U1.20 (GND), U3.6 (GND), U3.8 (GND)
GPS_RXD: TP5.1, U1.14 (RXD)
GPS_TXD: TP4.1, U1.13 (TXD)
I2C_SCL: J1.4, J2.4, R3.2, U1.12 (SCL), U3.1 (SCL/SPC)
I2C_SDA: J1.3, J2.3, R4.2, U1.9 (SDA), U3.4 (SDA/SDI/SDO)
MAG_C1: C6.1, U3.5 (C1)
unnamed: D1.2 (A), R1.2
unnamed: D2.2 (A), R2.2
unnamed: D2.1 (K), Q1.3 (D)
PPS: Q1.1 (G), U1.7 (TIMEPULSE)
RESET_N: TP2.1, U1.18 (~RESET)
SAFEBOOT_N: TP1.1, U1.8 (~SAFEBOOT)
V_BCKP: C5.1, D1.1 (K), U1.3 (V_BCKP)

Notes on the sheet:
Stack: FC on its grommets, M2 nylon standoffs (6 mm), GNSS board on top. Keep-out r 2.6 mm around each hole on both sides.
Qwiic pinout (both ports, wired in parallel): 1 GND 2 +3.3 V (FC expansion LDO, VEXP) 3 SDA 4 SCL Pull-ups on the FC (R15/R16 2.2 k); R3/R4 here DNP. Standard 1:1 Qwiic cables.
Draft B: no LDO. The FC draft E feeds the expansion bus from its own 3.3 V LDO (U11, VEXP, 300 mA), shared with the flow board.
B - GNSS receiver u-blox SAM-M10Q (antenna module)
Draft B: the FC reads the GNSS over DDC (I2C, address 0x42) on the Qwiic bus. UART (TXD/RXD) only on test pads TP4/TP5: u-center / firmware update with a USB-UART. EXTINT not used. RESET_N: no capacitor (u-blox). TIMEPULSE shares the pin with the SAFEBOOT strap: only a MOSFET gate on it.
A - Expansion bus (Qwiic / STEMMA QT), 3.3 V from the FC
The FC on-board IIS2MDC sits on the LSM6DSV16X sensor-hub bus; this one is on the Qwiic bus (FC I2C1): GNSS 0x42, ToF 0x29, flow bridge 0x3B: no address clash. Keep it 5 mm or more from the supercap, the LDO and the cable.
C - Compass IIS2MDC on the Qwiic bus (address 0x1E)
D - PPS indicator, mounting

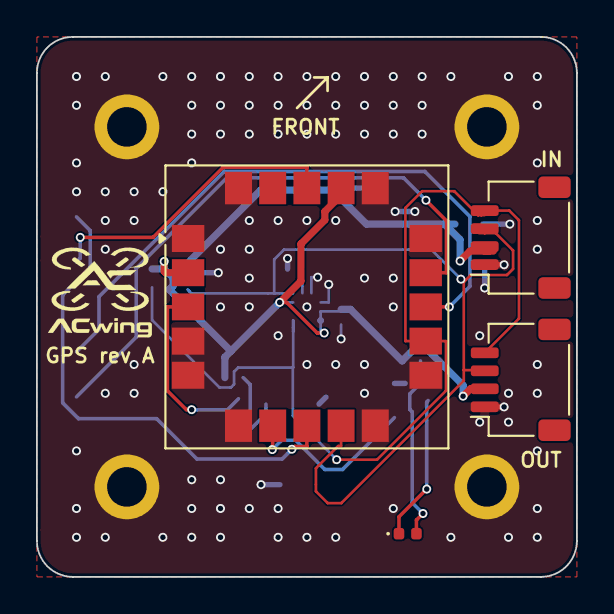
[picture p68: board ACwing_GPS_A.kicad_pcb from above]

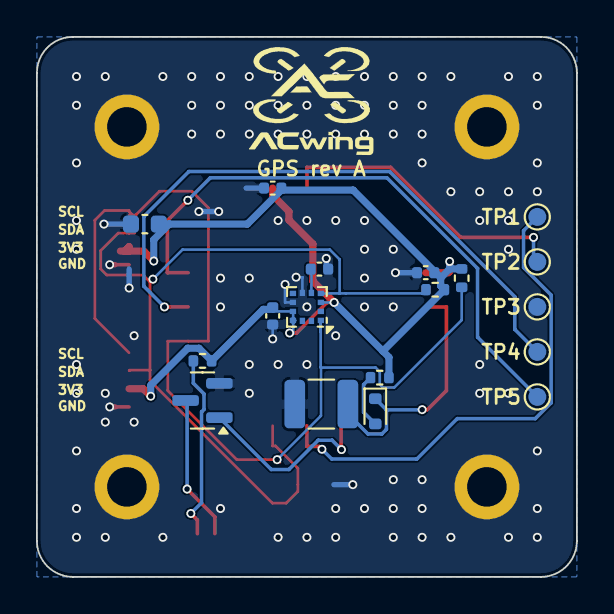
[picture p69: board ACwing_GPS_A.kicad_pcb from below]

Board: 2 copper layers, 30.0 x 30.0 mm, 28 parts (19 on the bottom side), 14 nets.

Other parts of the board:
LOGO1: ACwing_Logo_Full_5mm
LOGO2: ACwing_Logo_Full_6mm
