ACwing-UAV/ACwing_HW/04 - FLOW_KiCadProj/ACwing_Flow_A.kicad_pcb

## KiCad design 04 - FLOW_KiCadProj/ACwing_Flow_A.kicad_pcb (2026-11-12)

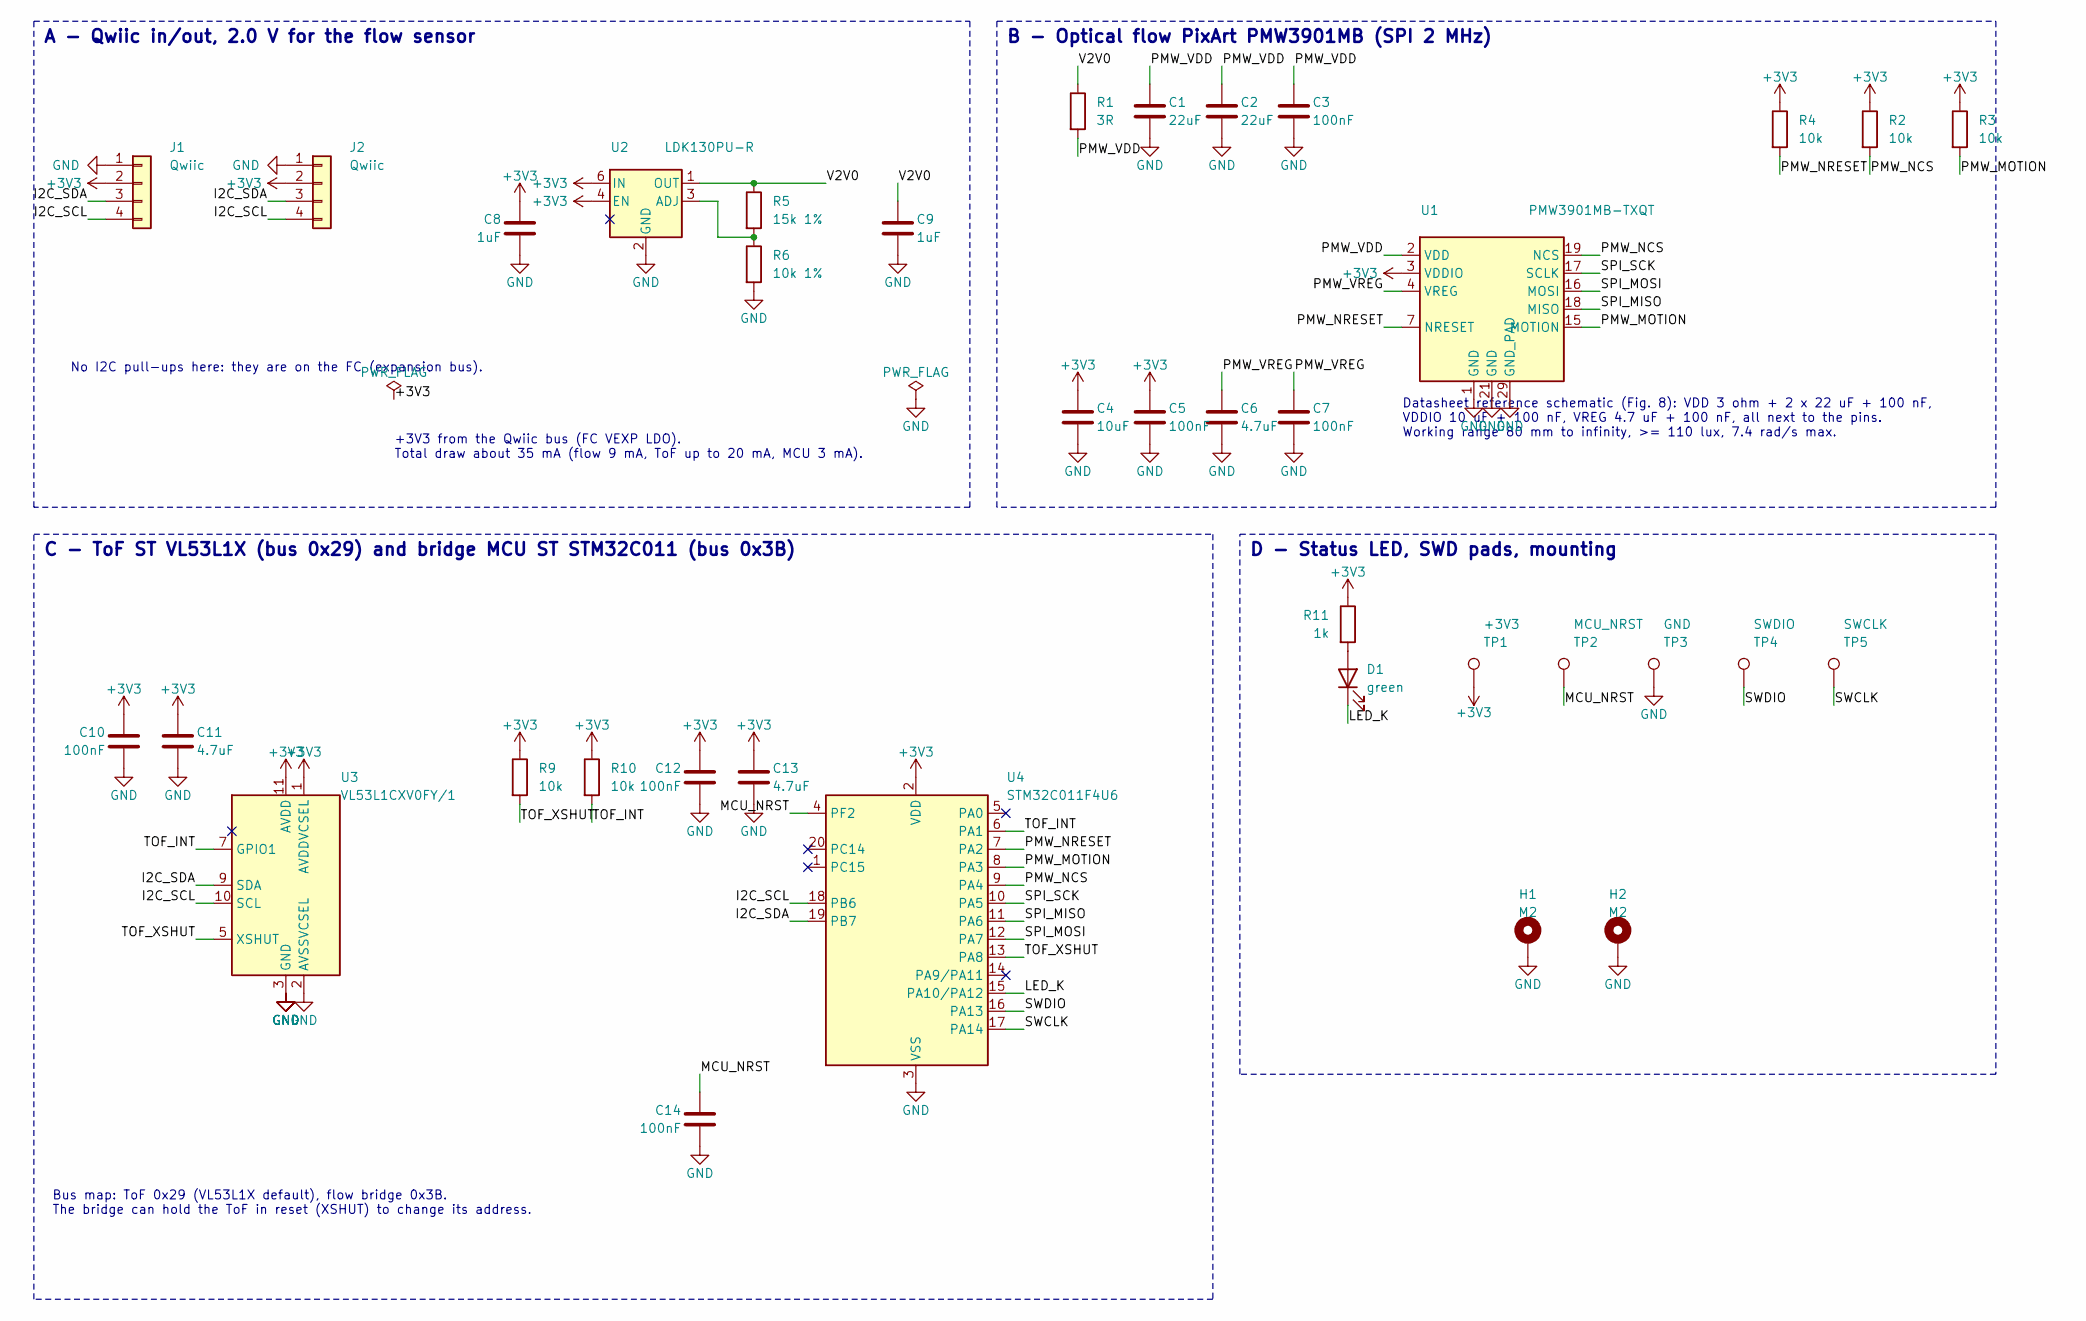
[picture p70: schematic ACwing_Flow_A.kicad_sch, ACwing Flow rev A - optical flow + ToF expansion for ACwing…]

Parts:
C1, C2: 22uF; C_0603_1608Metric
C3, C5, C7, C10, C12, C14: 100nF; C_0402_1005Metric
C4: 10uF; C_0603_1608Metric
C6, C11, C13: 4.7uF; C_0603_1608Metric
C8, C9: 1uF; C_0402_1005Metric
D1: green; LED_0402_1005Metric
H1, H2: M2; MountingHole_PTH_2.2mm_M2_Pad3.6mm
J1, J2: Qwiic; JST_SH_SM04B-SRSS-TB_1x04-1MP_P1.00mm_Horizontal
R1: 3R; R_0402_1005Metric
R2, R3, R4, R9, R10: 10k; R_0402_1005Metric
R5: 15k 1%; R_0402_1005Metric
R6: 10k 1%; R_0402_1005Metric
R11: 1k; R_0402_1005Metric
TP1: +3V3; TestPoint_Pad_D1.0mm
TP2: MCU_NRST; TestPoint_Pad_D1.0mm
TP3: GND; TestPoint_Pad_D1.0mm
TP4: SWDIO; TestPoint_Pad_D1.0mm
TP5: SWCLK; TestPoint_Pad_D1.0mm
U1: PMW3901MB-TXQT; PixArt_PMW3901MB_COB-28_6x6mm
U2: LDK130PU-R; DFN-6_1.3x1.2mm_P0.4mm
U3: VL53L1CXV0FY/1; ST_VL53L1x
U4: STM32C011F4U6; ST_UFQFPN-20_3x3mm_P0.5mm

Connections:
+3V3: C4.1, C5.1, C8.1, C10.1, C11.1, C12.1, C13.1, J1.2, J2.2, R2.1, R3.1, R4.1, R9.1, R10.1, R11.1, TP1.1, U1.3 (VDDIO), U2.4 (EN), U2.6 (IN), U3.1 (AVDDVCSEL), U3.11 (AVDD), U4.2 (VDD)
GND: C1.2, C2.2, C3.2, C4.2, C5.2, C6.2, C7.2, C8.2, C9.2, C10.2, C11.2, C12.2, C13.2, C14.2, H1.1, H2.1, J1.1, J2.1, R6.2, TP3.1, U1.1 (GND), U1.21 (GND), U1.29 (GND_PAD), U2.2 (GND), U3.2 (AVSSVCSEL), U3.3 (GND), U3.4 (GND), U3.6 (GND), U3.12 (GND), U4.3 (VSS)
I2C_SCL: J1.4, J2.4, U3.10 (SCL), U4.18 (PB6)
I2C_SDA: J1.3, J2.3, U3.9 (SDA), U4.19 (PB7)
LED_K: D1.1 (K), U4.15 (PA10/PA12)
MCU_NRST: C14.1, TP2.1, U4.4 (PF2)
unnamed: D1.2 (A), R11.2
unnamed: R5.2, R6.1, U2.3 (ADJ)
PMW_MOTION: R3.2, U1.15 (MOTION), U4.8 (PA3)
PMW_NCS: R2.2, U1.19 (NCS), U4.9 (PA4)
PMW_NRESET: R4.2, U1.7 (NRESET), U4.7 (PA2)
PMW_VDD: C1.1, C2.1, C3.1, R1.2, U1.2 (VDD)
PMW_VREG: C6.1, C7.1, U1.4 (VREG)
SPI_MISO: U1.18 (MISO), U4.11 (PA6)
SPI_MOSI: U1.16 (MOSI), U4.12 (PA7)
SPI_SCK: U1.17 (SCLK), U4.10 (PA5)
SWCLK: TP5.1, U4.17 (PA14)
SWDIO: TP4.1, U4.16 (PA13)
TOF_INT: R10.2, U3.7 (GPIO1), U4.6 (PA1)
TOF_XSHUT: R9.2, U3.5 (XSHUT), U4.13 (PA8)
V2V0: C9.1, R1.1, R5.1, U2.1 (OUT)

Notes on the sheet:
Bus map: ToF 0x29 (VL53L1X default), flow bridge 0x3B. The bridge can hold the ToF in reset (XSHUT) to change its address.
C - ToF ST VL53L1X (bus 0x29) and bridge MCU ST STM32C011 (bus 0x3B)
No I2C pull-ups here: they are on the FC (expansion bus).
+3V3 from the Qwiic bus (FC VEXP LDO). Total draw about 35 mA (flow 9 mA, ToF up to 20 mA, MCU 3 mA).
B - Optical flow PixArt PMW3901MB (SPI 2 MHz)
Datasheet reference schematic (Fig. 8): VDD 3 ohm + 2 x 22 uF + 100 nF, VDDIO 10 uF + 100 nF, VREG 4.7 uF + 100 nF, all next to the pins. Working range 80 mm to infinity, >= 110 lux, 7.4 rad/s max.
D - Status LED, SWD pads, mounting
A - Qwiic in/out, 2.0 V for the flow sensor

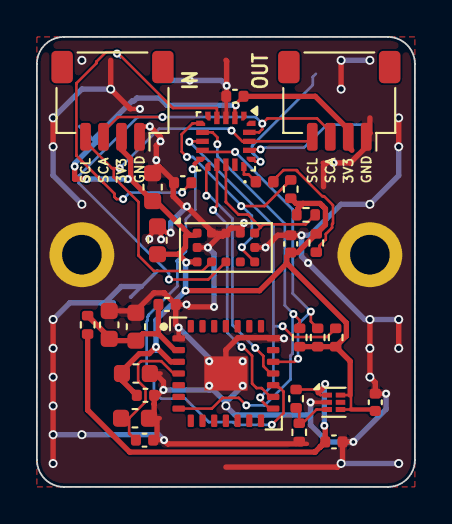
[picture p71: board ACwing_Flow_A.kicad_pcb from above]

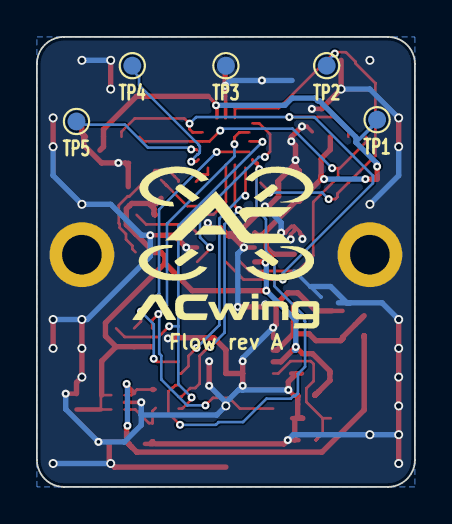
[picture p72: board ACwing_Flow_A.kicad_pcb from below]

Board: 2 copper layers, 21.0 x 25.0 mm, 38 parts (6 on the bottom side), 21 nets.

Other parts of the board:
LOGO1: ACwing_Logo_Full_9mm
