ACwing-UAV/ACwing_HW/01 - FC_KiCadProj/generator/jlc_parts.py

# Parts as assembled by JLCPCB: LCSC/JLCPCB part number for every BoM line, with the equivalents chosen where the
# original MPN is not stocked by LCSC/JLC (checked on lcsc.com / jlcpcb.com, 2026-10-16).
# key (value, footprint name) -> (MPN, manufacturer, LCSC #, JLC comment, description or None, note or None)
LCSC = {
 ('LM5166DRCT', 'Texas_DRC0010J'): ('LM5166DRCT', 'Texas Instruments', 'C181495', 'LM5166DRCT buck 3-65V 0.5A VSON-10',
     'Step-down converter, 3-65 V in, 500 mA, PFET high side (100% duty cycle), VSON-10 3x3', '350 in stock at LCSC on 2026-10-18: check before ordering'),
 ('22uH', 'L_Sunlord_SWPA5040S'): ('SWPA5040S220MT', 'Sunlord', 'C68434', 'SWPA5040S220MT 22uH 1.5A 5x5x4',
     'Inductor, shielded power, 22 uH, 20%, Irated 1.5 A, Isat 1.9 A, DCR 168 mOhm, 5 x 5 x 4 mm', None),
 ('4.7uF 50V', 'C_1206_3216Metric'): ('1206B475K500NT', 'FH (Guangdong Fenghua)', 'C29823', '4.7uF 50V X7R 1206',
     'Capacitor, MLCC, 4.7 uF, 50 V, X7R, 10%', 'JLC Basic part'),
 ('470k 1%', 'R_0402_1005Metric'): ('0402WGF4703TCE', 'UNI-ROYAL', 'C25790', '470k 1% 0402', None, 'JLC Basic part'),
 ('200k 1%', 'R_0402_1005Metric'): ('0402WGF2003TCE', 'UNI-ROYAL', 'C25764', '200k 1% 0402', None, 'JLC Basic part'),
 ('22uF 25V', 'C_0805_2012Metric'): ('CL21A226MAQNNNE', 'Samsung Electro-Mechanics', 'C45783', '22uF 25V X5R 0805', 'Capacitor, MLCC, 22 uF, 25 V, X5R, 20%', 'JLC Basic part'),
 ('10uF 25V', 'C_0805_2012Metric'): ('CL21A106KAYNNNE', 'Samsung Electro-Mechanics', 'C15850', '10uF 25V X5R 0805', 'Capacitor, MLCC, 10 uF, 25 V, X5R, 10%', 'JLC Basic part'),
 ('402k 1%', 'R_0402_1005Metric'): ('0402WGF4023TCE', 'UNI-ROYAL', 'C25785', '402k 1% 0402', None, None),
 ('100R', 'R_0402_1005Metric'): ('0402WGF1000TCE', 'UNI-ROYAL', 'C25076', '100R 1% 0402', None, 'JLC Basic part'),
 ('ESC link', 'JST_SH_SM08B-SRSS-TB_1x08-1MP_P1.00mm_Horizontal'): ('SM08B-SRSS-TB(LF)(SN)', 'JST', 'C160407', 'JST SH 8P side entry',
     'Connector, JST SH, 8 positions, 1.0 mm pitch, side entry', None),
 ('ESC link B', 'JST_SH_SM08B-SRSS-TB_1x08-1MP_P1.00mm_Horizontal'): ('SM08B-SRSS-TB(LF)(SN)', 'JST', 'C160407', 'JST SH 8P side entry',
     'Connector, JST SH, 8 positions, 1.0 mm pitch, side entry', None),
 ('2450AT18A0100001E', 'Johanson_2450AT18x100'): ('2450AT18A0100001E', 'Johanson Technology', 'C17430588', '2450AT18A0100001E 2.4GHz chip antenna', None, None),
 ('470uF 6.3V polymer', 'CP_EIA-7343-31_Kemet-D'): ('T520D477M006ATE015', 'KEMET', 'C696809', '470uF 6.3V tantalum polymer', None, None),
 ('10uF 10V', 'C_0603_1608Metric'): ('CL10A106KP8NNNC', 'Samsung Electro-Mechanics', 'C19702', '10uF 10V X5R 0603',
     'Capacitor, MLCC, 10 uF, 10 V, X5R, 10%', 'JLC Basic part (replaces Murata GRM188R61A106KE69D)'),
 ('10uF 6.3V', 'C_0603_1608Metric'): ('CL10A106KP8NNNC', 'Samsung Electro-Mechanics', 'C19702', '10uF 10V X5R 0603',
     'Capacitor, MLCC, 10 uF, 10 V, X5R, 10%', 'JLC Basic part, 10 V rating (replaces Murata GRM188R60J106ME47D)'),
 ('100uF 6.3V', 'C_1206_3216Metric'): ('CL31A107MQHNNNE', 'Samsung Electro-Mechanics', 'C15008', '100uF 6.3V X5R 1206',
     'Capacitor, MLCC, 100 uF, 6.3 V, X5R, 20%', 'Replaces Murata GRM31CR60J107ME39L'),
 ('4.7uF', 'C_0603_1608Metric'): ('CL10A475KO8NNNC', 'Samsung Electro-Mechanics', 'C19666', '4.7uF 16V X5R 0603',
     'Capacitor, MLCC, 4.7 uF, 16 V, X5R, 10%', 'JLC Basic part, 16 V rating (replaces Murata GRM188R61A475KE15D)'),
 ('4.7uF 10V', 'C_0603_1608Metric'): ('CL10A475KO8NNNC', 'Samsung Electro-Mechanics', 'C19666', '4.7uF 16V X5R 0603',
     'Capacitor, MLCC, 4.7 uF, 16 V, X5R, 10%', 'JLC Basic part, 16 V rating (replaces Murata GRM188R61A475KE15D)'),
 ('1uF', 'C_0402_1005Metric'): ('CL05A105KA5NQNC', 'Samsung Electro-Mechanics', 'C52923', '1uF 25V X5R 0402',
     'Capacitor, MLCC, 1 uF, 25 V, X5R, 10%', 'JLC Basic part (replaces Murata GRM155R61A105KE15D)'),
 ('1uF 10V', 'C_0402_1005Metric'): ('CL05A105KA5NQNC', 'Samsung Electro-Mechanics', 'C52923', '1uF 25V X5R 0402',
     'Capacitor, MLCC, 1 uF, 25 V, X5R, 10%', 'JLC Basic part (replaces Murata GRM155R61A105KE15D)'),
 ('100nF', 'C_0402_1005Metric'): ('CL05B104KO5NNNC', 'Samsung Electro-Mechanics', 'C1525', '100nF 16V X7R 0402',
     'Capacitor, MLCC, 100 nF, 16 V, X7R, 10%', 'JLC Basic part (replaces Murata GRM155R71C104KA88D)'),
 ('220nF', 'C_0402_1005Metric'): ('CL05B224KO5NNNC', 'Samsung Electro-Mechanics', 'C16772', '220nF 16V X7R 0402',
     'Capacitor, MLCC, 220 nF, 16 V, X7R, 10%', 'Replaces Murata GRM155R71C224KA12D'),
 ('100pF', 'C_0402_1005Metric'): ('0402CG101J500NT', 'FH (Guangdong Fenghua)', 'C1546', '100pF 50V C0G 0402',
     'Capacitor, MLCC, 100 pF, 50 V, C0G, 5%', 'JLC Basic part (replaces Murata GRM1555C1H101JA01D)'),
 ('4.7uF', 'C_0402_1005Metric'): ('CL05A475MP5NRNC', 'Samsung Electro-Mechanics', 'C23733', '4.7uF 10V X5R 0402',
     'Capacitor, MLCC, 4.7 uF, 10 V, X5R, 20%', 'Replaces Murata GRM155R61A475MEAAD'),
 ('white', 'LED_0402_1005Metric'): ('XL-1005UWC', 'XINGLIGHT', 'C20613596', 'LED white 0402',
     'LED, white, 0402, Vf 2.8 V', 'Replaces Inolux IN-S42ATUW. LCSC C20613596 (the C965796 listing of the same part is short); alternative Hongzhi Forest HS-0402-UW (C1322306)'),
 ('red', 'LED_0402_1005Metric'): ('XL-1005SURC', 'XINGLIGHT', 'C25503345', 'LED red 0402',
     'LED, red 625 nm, 0402, Vf 1.8-2.4 V', 'Replaces Inolux IN-S42ATR'),
 ('green', 'LED_0402_1005Metric'): ('XL-1005UGC', 'XINGLIGHT', 'C965793', 'LED green 0402',
     'LED, green 525 nm, 0402, Vf ~3 V', 'Replaces Inolux IN-S42ATG (about 2 mA with the 1 k resistor from VBUS)'),
 ('STPS3L45AF', 'D_SMAflat'): ('SS34F', 'GOODWORK', 'C908669', 'SS34F Schottky 40V 3A SMAF',
     'Diode, Schottky, 40 V, 3 A, Vf 0.55 V @ 3 A, SMAF (DO-221AC)', 'Replaces STPS3L45AF (only 3 pcs at LCSC); same DO-221AC outline'),
 ('PMEG2010AEH', 'D_SOD-123F'): ('PMEG2010AEH,115', 'Nexperia', 'C110921', 'PMEG2010AEH Schottky SOD-123F', None, None),
 ('USB-C (HRO TYPE-C-31-M-12)', 'USB_C_Receptacle_HRO_TYPE-C-31-M-12'): ('TYPE-C-31-M-12', 'HRO (Korea Hroparts)', 'C165948', 'USB-C receptacle TYPE-C-31-M-12', None, None),
 ('GPS port', 'JST_SH_SM06B-SRSS-TB_1x06-1MP_P1.00mm_Horizontal'): ('SM06B-SRSS-TB(LF)(SN)', 'JST', 'C160405', 'JST SH 6P 1.0 mm side entry',
     'Connector, JST SH, 6 positions, 1.0 mm pitch, side entry, SMD, 2.9 mm high', 'Rev D GPS port; 1:1 6-pin JST SH cable to the GPS board'),
 ('AON7524', 'Vishay_PowerPAK_1212-8_Single'): ('AON7524', 'Alpha & Omega Semiconductor', 'C431195', 'AON7524 N-MOSFET DFN3x3', None, None),
 ('AO3401A', 'SOT-23'): ('AO3401A', 'Alpha & Omega Semiconductor', 'C15127', 'AO3401A P-MOSFET SOT-23', None, None),
 ('2N7002DW', 'SOT-363_SC-70-6'): ('2N7002DW-7-F', 'Diodes Inc.', 'C83571', '2N7002DW dual N-MOSFET SOT-363', None, None),
 ('1R', 'R_0603_1608Metric'): ('HRC0603F1R00ENTN', 'HWA CHN', 'C54920875', '1R 1% 0603', 'Resistor, 1 Ohm, 1%, 0.1 W', 'Replaces Yageo RC0603FR-071RL'),
 ('100k', 'R_0402_1005Metric'): ('0402WGF1003TCE', 'UNI-ROYAL', 'C25741', '100k 1% 0402', None, 'JLC Basic part'),
 ('100k 1%', 'R_0402_1005Metric'): ('0402WGF1003TCE', 'UNI-ROYAL', 'C25741', '100k 1% 0402', None, 'JLC Basic part'),
 ('287k 1%', 'R_0402_1005Metric'): ('RC-02K2873FT', 'FH (Guangdong Fenghua)', 'C42921050', '287k 1% 0402', None, None),
 ('3.3k 1%', 'R_0402_1005Metric'): ('0402WGF3301TCE', 'UNI-ROYAL', 'C25890', '3.3k 1% 0402', None, 'JLC Basic part'),
 ('1k', 'R_0402_1005Metric'): ('0402WGF1001TCE', 'UNI-ROYAL', 'C11702', '1k 1% 0402', None, 'JLC Basic part'),
 ('1R', 'R_0402_1005Metric'): ('FRC0402F1R00TS', 'FOJAN', 'C2909329', '1R 1% 0402', None, None),
 ('470k 1%', 'R_0402_1005Metric'): ('0402WGF4703TCE', 'UNI-ROYAL', 'C25790', '470k 1% 0402', None, 'JLC Basic part'),
 ('5.1k', 'R_0402_1005Metric'): ('0402WGF5101TCE', 'UNI-ROYAL', 'C25905', '5.1k 1% 0402', None, 'JLC Basic part'),
 ('10k', 'R_0402_1005Metric'): ('0402WGF1002TCE', 'UNI-ROYAL', 'C25744', '10k 1% 0402', None, 'JLC Basic part'),
 ('2.2k', 'R_0402_1005Metric'): ('0402WGF2201TCE', 'UNI-ROYAL', 'C25879', '2.2k 1% 0402', None, 'JLC Basic part'),
 ('4.7k', 'R_0402_1005Metric'): ('0402WGF4701TCE', 'UNI-ROYAL', 'C25900', '4.7k 1% 0402', None, 'JLC Basic part'),
 ('22R', 'R_0402_1005Metric'): ('0402WGF220JTCE', 'UNI-ROYAL', 'C25092', '22R 0402', None, 'JLC Basic part'),
 ('220R', 'R_0402_1005Metric'): ('0402WGF2200TCE', 'UNI-ROYAL', 'C25091', '220R 1% 0402', None, 'JLC Basic part'),
 ('470R', 'R_0402_1005Metric'): ('0402WGF4700TCE', 'UNI-ROYAL', 'C25117', '470R 1% 0402', None, 'JLC Basic part'),
 ('0R', 'R_0402_1005Metric'): ('0402WGF0000TCE', 'UNI-ROYAL', 'C17168', '0R 0402', None, 'JLC Basic part'),
 ('LSM6DSV16X', 'LGA-14_3x2.5mm_P0.5mm_LayoutBorder3x4y'): ('LSM6DSV16XTR', 'STMicroelectronics', 'C5267406', 'LSM6DSV16XTR IMU', None, None),
 ('STM32WB55CGU6', 'QFN-48-1EP_7x7mm_P0.5mm_EP5.6x5.6mm'): ('STM32WB55CGU6', 'STMicroelectronics', 'C404023', 'STM32WB55CGU6', None,
     'Out of stock at LCSC/JLC (2026-10-27): consigned part (buy at Mouser/DigiKey/ST and ship to JLC) or JLC Global Sourcing'),
 ('MLPF-WB55-01E3', 'ST_MLPF-WB55-01E3_CSP-6'): ('MLPF-WB55-01E3', 'STMicroelectronics', 'C2651048', 'MLPF-WB55-01E3 RF filter', None, None),
 ('32MHz', 'Crystal_SMD_2016-4Pin_2.0x1.6mm'): ('NX2016SA-32MHZ-STD-CZS-5', 'NDK', 'C843260', '32MHz crystal 8pF 2016',
     'Crystal, 32 MHz, 8 pF, +-10 ppm, SMD 2016, HSE for the STM32WB radio', 'Same NDK NX2016SA family and load capacitance (8 pF) as the ST-listed EXS00A-CS06654; no load capacitors (internal HSE trimming)'),
 ('2.2uH', 'L_0805_2012Metric'): ('MPH201210S2R2MT', 'Sunlord', 'C55755', '2.2uH 0805 power inductor',
     'Inductor, multilayer power, 2.2 uH, 20%, 420 mA, DCR 0.25 Ohm, 2.0 x 1.2 x 1.0 mm', 'SMPS inductor, 8 MHz SMPS clock; replaces Wurth 74479774222 (not at LCSC)'),
 ('10nH', 'L_0402_1005Metric'): ('LQG15HS10NJ02D', 'Murata', 'C77103', '10nH 5% 0402',
     'Inductor, multilayer, 10 nH, 5%, 500 mA', 'Replaces LQG15WZ10NJ02D (same value, LCSC stocked)'),
 ('IIS2MDC', 'LGA-12_2x2mm_P0.5mm'): ('IIS2MDCTR', 'STMicroelectronics', 'C2655002', 'IIS2MDCTR magnetometer', None, None),
 ('LPS22HH', 'ST_HLGA-10_2x2mm_P0.5mm_LayoutBorder3x2y'): ('LPS22HHTR', 'STMicroelectronics', 'C2827824', 'LPS22HHTR barometer', None,
     'Replaces LPS22HBTR (out of stock): same HLGA-10 2 x 2 footprint and pinout; low LCSC stock on 2026-10-27, check before ordering'),
 ('LD39130SPUR', 'DFN-6_1.3x1.2mm_P0.4mm'): ('LD39130SPUR', 'STMicroelectronics', 'C2798213', 'LD39130SPUR LDO', None, None),
 ('STC4054GR', 'TSOT-23-5'): ('STC4054GR', 'STMicroelectronics', 'C262930', 'STC4054GR Li-ion charger', None, None),
 ('USBLC6-2SC6', 'SOT-23-6'): ('USBLC6-2SC6', 'STMicroelectronics', 'C7519', 'USBLC6-2SC6 ESD', None, None),
 # ---- rev E additions (LCSC, checked 2026-10-17)
 ('2.2uF', 'C_0402_1005Metric'): ('CL05A225MQ5NSNC', 'Samsung Electro-Mechanics', 'C12530', '2.2uF 6.3V X5R 0402',
     'Capacitor, MLCC, 2.2 uF, 6.3 V, X5R, 20%', 'JLC Basic part'),
 ('10nF', 'C_0402_1005Metric'): ('CL05B103KB5NNNC', 'Samsung Electro-Mechanics', 'C15195', '10nF 50V X7R 0402',
     'Capacitor, MLCC, 10 nF, 50 V, X7R, 10%', 'JLC Basic part'),
 ('XL-2020RGBC-WS2812B', 'LED_WS2812B-2020_PLCC4_2.0x2.0mm'): ('XL-2020RGBC-WS2812B', 'XINGLIGHT', 'C5349955', 'XL-2020RGBC-WS2812B RGB LED',
     'LED, RGB addressable, integrated driver, 2.0 x 2.0 mm', None),
 ('RB521S30', 'D_SOD-523'): ('RB521S30T1G', 'onsemi', 'C8523', 'RB521S30 Schottky SOD-523', 'Diode, Schottky, 30 V, 200 mA, SOD-523', None),
 ('Qwiic', 'JST_SH_SM04B-SRSS-TB_1x04-1MP_P1.00mm_Horizontal'): ('SM04B-SRSS-TB(LF)(SN)', 'JST', 'C160404', 'JST SH 4P 1.0 mm side entry',
     'Connector, JST SH, 4 positions, 1.0 mm pitch, side entry, SMD', 'Qwiic / STEMMA QT expansion port'),
 ('ELRS', 'JST_SH_SM04B-SRSS-TB_1x04-1MP_P1.00mm_Horizontal'): ('SM04B-SRSS-TB(LF)(SN)', 'JST', 'C160404', 'JST SH 4P 1.0 mm side entry',
     'Connector, JST SH, 4 positions, 1.0 mm pitch, side entry, SMD', 'ELRS receiver port (CRSF)'),
 ('SN74LV1T34DCKR', 'SOT-353_SC-70-5'): ('SN74LV1T34DCKR', 'Texas Instruments', 'C78541', 'SN74LV1T34DCKR level-shift buffer SC-70-5',
     'Single buffer, single supply 1.6-5.5 V, TTL-level inputs (VIH 2.0 V at 5 V), 5 V tolerant, SC-70-5', 'LED data level shifter; ~24k in stock at LCSC on 2026-10-27'),
 ('TSC213', 'SOT-363_SC-70-6'): ('TSC213ICT', 'STMicroelectronics', 'C1858319', 'TSC213ICT current sense amplifier', 'Current-sense amplifier, gain 50 V/V, SC70-6', None),
 ('W25Q128JV', 'WSON-8-1EP_6x5mm_P1.27mm_EP3.4x4mm'): ('W25Q128JVPIQ', 'Winbond', 'C190862', 'W25Q128JVPIQ 128 Mbit SPI flash WSON-8',
     'NOR flash, 128 Mbit (16 MB), SPI/QSPI 133 MHz, WSON-8 6x5 mm', None),
 ('LDK130PU-R', 'DFN-6_1.3x1.2mm_P0.4mm'): ('LDK130PU-R', 'STMicroelectronics', 'C157446', 'LDK130PU-R adjustable LDO DFN-6',
     'LDO, adjustable 0.8-5.1 V, 300 mA, DFN-6 1.2 x 1.3 mm', 'Set to 3.31 V by R40/R41 (47k/15k)'),
 ('2m', 'R_1206_3216Metric'): ('RLM12FTCMR002', 'TA-I Tech', 'C710257', '2mR 1% 1W 1206 current sense',
     'Resistor, current sense, 2 mOhm, 1%, 1 W, 1206', 'Battery current shunt'),
 ('33R', 'R_0402_1005Metric'): ('0402WGF330JTCE', 'UNI-ROYAL', 'C25105', '33R 0402', None, 'JLC Basic part'),
 ('47k 1%', 'R_0402_1005Metric'): ('0402WGF4702TCE', 'UNI-ROYAL', 'C25792', '47k 1% 0402', None, 'JLC Basic part'),
 ('15k 1%', 'R_0402_1005Metric'): ('0402WGF1502TCE', 'UNI-ROYAL', 'C25756', '15k 1% 0402', None, 'JLC Basic part'),
}
