ACwing-UAV/ACwing_HW/(commit log)

2026-10-16 First stable release of the PCB for the Flight Controller board.
    [C2_bottom_targets.csv, CP_EIA-7343-31_Kemet-D.step, C_0402_1005Metric.step, C_0603_1608Metric.step, C_1206_3216Metric.step, Crystal_SMD_2016-4Pin_2.0x1.6mm.step, DFN-6_1.3x1.2mm_P0.4mm.step, D_SMAflat.step]
2026-10-19 Added the Flow board, the GPS board and the ESC 1S board.
    New revision for the FC board.
    [C2_bottom_targets.csv, CP_EIA-7343-31_Kemet-D.step, C_0402_1005Metric.step, C_0603_1608Metric.step, C_0805_2012Metric.step, C_1210_3225Metric.step, Crystal_SMD_2016-4Pin_2.0x1.6mm.step, DFN-6_1.3x1.2mm_P0.4mm.step]
2026-10-19 Rename all projects to ACwing (files, libraries, texts)
    Claude-Session: https://claude.ai/code/session_0189Xg6tRAL4bRZ656VQBtPX
    [ACwing_ESC1S_B-B_Cu.gbl, ACwing_ESC1S_B-B_Mask.gbs, ACwing_ESC1S_B-B_Paste.gbp, ACwing_ESC1S_B-B_Silkscreen.gbo, ACwing_ESC1S_B-Edge_Cuts.gm1, ACwing_ESC1S_B-F_Cu.gtl, ACwing_ESC1S_B-F_Mask.gts, ACwing_ESC1S_B-F_Paste.gtp]
2026-10-19 Fix FC board rename
    [ACwing_FC_H.kicad_pcb]
2026-10-19 ACwing silkscreen: logos, board names, author, connector labels (DRC clean)
    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
    [ACwing_ESC1S_B.kicad_pcb, ACwing_FC_H.kicad_pcb, ACwing_Flow_A.kicad_pcb, ACwing_GPS_D.kicad_pcb]
2026-10-19 Reorganize docs, regenerate outputs, remove author name from the PCBs
    - fabrication outputs, schematics, STEP and PCB views moved to 00 - Docs/<board>_Docs
    - single mechanical handoff and stack check in 04 - System_Docs, brand files in 05 - Brand
    - silkscreen: ACwing logo, board name and labels only (no author name)
    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
    [ACwing_ESC1S_B-B_Cu.gbl, ACwing_ESC1S_B-B_Mask.gbs, ACwing_ESC1S_B-B_Paste.gbp, ACwing_ESC1S_B-B_Silkscreen.gbo, ACwing_ESC1S_B-Edge_Cuts.gm1, ACwing_ESC1S_B-F_Cu.gtl, ACwing_ESC1S_B-F_Mask.gts, ACwing_ESC1S_B-F_Paste.gtp]
2026-10-19 Release naming: all boards become rev A
    - FC H, ESC 1S B, GPS D renamed to rev A (files, title blocks, silkscreen, BoM titles, docs); Flow stays rev A
    - earlier pre-release iterations are called drafts in the docs (never manufactured)
    - Gerber, STEP, schematic PDFs, DRC reports and PCB views regenerated (DRC 0 on all boards)
    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
    [ACwing_ESC1S_A.kicad_pcb, ACwing_ESC1S_A.kicad_sch, ACwing_ESC1S_A.step, ACwing_ESC1S_A_BoM.xlsx, ACwing_ESC1S_A_BoM_JLCPCB.xlsx, ACwing_ESC1S_B.kicad_pcb, ACwing_ESC1S_B.kicad_sch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]
2026-10-24 FC/GPS layout update (still rev A): MCU centred, J6 on the front edge, buck on the left edge, EMI fixes
    - FC: MCU at the board centre, IMU south of it (rot 270, axes remapped in firmware), ESC link B J6 next to J5 on
    the front edge, input buck L3/U12 on the left edge (out of the corner between the rear LEDs)
    - FC: LEDs D3/D4 rotated, LED supply pre-routed away from the magnetometer; EMI check script and results
    - GPS: Qwiic J1 moved to v = +3.6, right above FC J3
    - re-routed, DRC 0 on both boards; Gerber, STEP, PDF, BoM/CPL, views, stack check regenerated; docs updated
    Claude-Session: https://claude.ai/code/session_0189Xg6tRAL4bRZ656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
    [ACwing_FC_A.kicad_pcb, ACwing_FC_A.kicad_sch, ACwing_FC_A.step, ACwing_FC_A_BoM.xlsx, ACwing_FC_A_BoM_JLCPCB.xlsx, ACwing_FC_A_outline.dxf, ACwing_GPS_A.kicad_pcb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]
2026-10-27 FC BoM fixes: R40 LCSC number, LPS22HH barometer, MCU sourcing note
    - R40 47k 0402: C25819 (0603) -> C25792 (0402WGF4702TCE)
    - U4: LPS22HBTR (out of stock) -> LPS22HHTR C2827824, same HLGA-10 footprint and pinout
    - U2 STM32WB55CGU6 out of stock at LCSC/JLC: consigned part / Global Sourcing note
    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
    [ACwing_FC_A.kicad_pcb, ACwing_FC_A.kicad_sch, ACwing_FC_A_BoM.xlsx, ACwing_FC_A_BoM_JLCPCB.xlsx]
2026-10-27 FC: XL-2020RGBC-WS2812B LEDs, D11 Schottky replaced by 0R link R49
    - D1-D4: XINGLIGHT XL-2020RGBC-WS2812B (C5349955), same footprint and pinout (WS2812B-2020 out of stock)
    - D11 RB521S30 -> R49 0R 0402 at the same place: VLED = VSYS, LEDs above their 3.5 V minimum on 1S
    - BoM, JLC BoM, CPL, schematic PDF, Gerber, STEP, PCB view regenerated; DRC 0
    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
    [ACwing_FC_A.kicad_pcb, ACwing_FC_A.kicad_sch, ACwing_FC_A.step, ACwing_FC_A_BoM.xlsx, ACwing_FC_A_BoM_JLCPCB.xlsx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]
2026-10-27 FC rev A: LED data level shifter U13, LEDs on VSYS (R49 removed)
    - U13 SN74LV1T34DCKR (TI, LCSC C78541, SC-70-5) single-supply buffer powered
    from VSYS: TTL-level input (VIH <= 2.0 V), push-pull output at VSYS, so the
    XL-2020RGBC-WS2812B data input (VIH = 0.7 x VDD) is met on battery and on
    USB alone. C50 100 nF decoupling; R39 33R between U13 and D1.
    - R49 0R removed: VLED merged into VSYS (LED supply unchanged in geometry,
    EMI at the magnetometer unchanged).
    - PCB: U13/C50/R39 on the bottom next to D1, RGB data rerouted; DRC 0
    violations, 0 unconnected.
    - BoM/JLC BoM/CPL (U13 correction 270 deg), costing, schematic PDF, Gerber,
    STEP, views regenerated; README and pin map update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
    [ACwing_FC_A.kicad_pcb, ACwing_FC_A.kicad_sch, ACwing_FC_A.step, ACwing_FC_A_BoM.xlsx, ACwing_FC_A_BoM_JLCPCB.xlsx, SOT-353_SC-70-5.step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]
2026-10-27 FC rev A: CPL fixes from the JLC placement preview
    - Bottom side: rotation = 180 - KiCad rotation + correction (JLC mirrors
    bottom parts about the Y axis); U10, U11, U13 were 90/180 deg off.
    - Corrections: U10 WSON-8 270, U13 SOT-353 180, U12 VSON-10 0 (was 270),
    LEDs D1-D4 (XL-2020) 180.
    - J1 USB-C: CPL position moved 1.46 mm toward the pins (JLC origin = pad-area
    centre, KiCad origin = body centre).
    - README: CPL notes and checks updated.
    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
    [ACwing_FC_A_CPL.xlsx]
2026-10-27 Silkscreen review: board names, connector labels on the right side
    - Board name + revision only, same on every board and layer: "FC rev A",
    "ESC 1S rev A", "GPS rev A", "Flow rev A" (was "ACwing ... rev A" on some).
    - FC: USB and ESC A labels moved to the top (with J1 / J2); GPS and FLOW
    centred on J3 / J4; ESC B and ELRS on one line; BAT beside J7 / J8.
    - Same fix on ESC 1S (CHARGE to the top, TO FC centred on J1) and GPS
    (QWIIC IN / OUT to the top, outside the SAM-M10Q outline).
    - silk_brand.py: labels stay on the connector's side and never under a part;
    brand README rules updated. Gerbers, DRC (0 / 0 on all boards), views.
    C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
    [ACwing_ESC1S_A.kicad_pcb, ACwing_FC_A.kicad_pcb, ACwing_Flow_A.kicad_pcb, ACwing_GPS_A.kicad_pcb]
2026-10-28 Removed references of the passive components and of the ICs on the top and bottom silkscreen. Left only the labels of the connectors.
    [ACwing_FC_A.kicad_pcb]
2026-10-31 Repository hygiene and links to the ACwing-UAV organization
    - untrack the three KiCad .history folders: they were committed as gitlinks
    (mode 160000) without a .gitmodules entry, which breaks recursive clones
    - untrack __pycache__ and the per-user .kicad_prl files; add .gitignore
    - README: links to ACwing_FW, ACwing_Mechs and the ACwing system repository
    Claude-Session: https://claude.ai/code/session_01Td5hUdt9aKLnh1mFddNDQp
2026-10-31 README: rev A for all boards; brand folder moved to the ACwing system repository
    - Boards table: FC, ESC 1S, GPS and Flow all rev A (no PCB produced yet)
    - remove 00 - Docs/05 - Brand (now ACwing/brand); logos and links point there
    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
2026-11-01 Docs: frame drafts renamed "preliminary draft", released mechanics is Mech A1
    - System_Docs: frame C2 answer and electronics reply renamed to
    ACwing_frame_preliminary_draft_{mechanical_answer,electronics_reply}.md
    - Handoff, README files: "frame C" / "frame C2" become "preliminary draft frame";
    the stack and GPS notes point to Mech A1 (ACwing_Mechs)
    - Generator scripts and KiCad files are not touched (comments only)
    Claude-Session: https://claude.ai/code/session_019Nr6Xnv8axshXV5pw79JDM
2026-11-02 HW rev A: routing rework, no via in pad, JLC solder-mask rule, connector moves
    - FC: ESC link A (J2) moved to the front edge next to J6, ELRS (J5) to the rear edge;
    C2/R42/R21-R23 follow; test pads TP1-TP8 renumbered in reading order (bottom view);
    J7/J8 marked + / -; U8 CSP pads 0.25 mm; U1/U3/U4 LGA pads narrowed so every gap >= 0.19 mm
    - GPS: Qwiic IN/OUT both on the right edge, labels re-placed; IIS2MDC pads resized
    - Flow: Qwiic IN/OUT on the top edge, SWD pads on the perimeter (symmetric), schematic
    renumbered (TP1 3V3, TP2 NRST, TP3 GND, TP4 SWDIO, TP5 SWCLK); XSHUT PA8, LED PA10
    - ESC 1S: motor labels fitted to the new mask expansion
    - All boards: no via in SMD pads (exposed th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
    [ACwing_ESC1S_A.kicad_pcb, ACwing_ESC1S_A.step, ACwing_FC_A.kicad_pcb, ACwing_FC_A.kicad_sch, ACwing_FC_A.step, ACwing_FC_A_BoM.xlsx, ACwing_FC_A_BoM_JLCPCB.xlsx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]
2026-11-03 flow tp moved on the bottom perimeter. Silkscreen of all boards adjusted.
    [ACwing_ESC1S_A.kicad_pcb, ACwing_FC_A.kicad_pcb, ACwing_Flow_A.kicad_pcb, ACwing_GPS_A.kicad_pcb]
2026-11-03 HW rev A: plated GND-ring mounting holes, Flow test pads on the bottom
    - ESC 1S, GPS, Flow: M2 holes now PTH 2.2 mm with a 3.6 mm copper ring on both sides,
    tied to GND as on the FC (new footprint MountingHole_PTH_2.2mm_M2_Pad3.6mm,
    schematics: MountingHole_Pad + GND); ESC PWM_M3/PWM_M4/VBAT_RAW re-routed around the rings
    - Flow: TP1-TP5 moved to B.Cu at the positions set in 44dc112, SWD / NRST / 3V3 re-routed
    - GPS: board BOM/DNP attributes synced with the schematic (R3/R4 DNP, TPs)
    - Silkscreen of all boards kept as edited in 44dc112
    - Outputs regenerated; ESC gerbers include In1/In2 again (missing in 9b54241)
    - DRC: 0 errors / 0 unconnected on all boards; remaining silkscreen warnings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
    [ACwing_ESC1S_A.kicad_pcb, ACwing_ESC1S_A.kicad_sch, ACwing_ESC1S_A.step, ACwing_ESC1S_A_BoM.xlsx, ACwing_ESC1S_A_BoM_JLCPCB.xlsx, ACwing_FC_A.kicad_pcb, ACwing_FC_A.step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]
2026-11-03 Silkscreen: clear the remaining DRC warnings (GPS back logo, Flow TP2/TP4 labels)
    - GPS: back logo + "GPS rev A" moved 1.8 mm toward the front edge, clear of the C3 outline and of the mask openings
    - Flow: TP2 / TP4 labels beside their pads (they were cut by the board edge)
    - GPS and Flow outputs regenerated; DRC 0 violations / 0 unconnected on both
    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
    [ACwing_Flow_A.kicad_pcb, ACwing_Flow_A.step, ACwing_GPS_A.kicad_pcb, ACwing_GPS_A.step]
2026-11-03 Flow: SWD test pads on the back side along the top edge, short SWD lines
    - TP1-TP5 mirrored from the bottom edge to the top edge (still B.Cu), Qwiic connectors unchanged
    - SWDIO 41 -> 7 mm, SWCLK 17 -> 6 mm, NRST stub 1 via; GND stitching via removed from TP3
    - Labels under the pads; DRC 0 / 0, schematic parity OK, no via in SMD or test pads
    - Outputs and docs updated
    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
    [ACwing_Flow_A.kicad_pcb, ACwing_Flow_A.step, ACwing_Flow_A_BoM.xlsx, ACwing_Flow_A_BoM_JLCPCB.xlsx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]
2026-11-03 final review, silkscreen adjusted on the flow board.
    [ACwing_ESC1S_A.kicad_pcb, ACwing_FC_A.kicad_pcb, ACwing_Flow_A.kicad_pcb]
2026-11-03 Gerber of the Flow board updated after silkscreen review
    [ACwing_Flow_A.kicad_pcb]
2026-11-03 flow updated
    [ACwing_Flow_A.kicad_pcb]
2026-11-06 Boards rev A: 1.6 mm PCB thickness
    All four rev A boards (FC, ESC 1S, GPS, Flow) go from 1.0 to 1.6 mm FR-4.
    - kicad_pcb general thickness 1.6; STEP models re-exported (KiCad 10.0.6).
    - Gerber job files: BoardThickness 1.6 and stack-up (copper/drill files unchanged).
    - READMEs, Readme.md and the mechanical handoff updated; FC note on RF_IN width
    and via aspect ratio for the 1.6 mm stack-up.
    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
    [ACwing_ESC1S_A.kicad_pcb, ACwing_ESC1S_A.step, ACwing_FC_A.kicad_pcb, ACwing_FC_A.step, ACwing_Flow_A.kicad_pcb, ACwing_Flow_A.step, ACwing_GPS_A.kicad_pcb, ACwing_GPS_A.step]
2026-11-06 ESC 1S: link connector J1 on the front edge (short cable to FC J2); new renders
    - ESC 1S J1 moved from the rear to the front edge, centre (+9.6, +16.88), mouth +v, pin 1 at the +u end as FC J2:
    the FC -> ESC cable becomes a ~25-30 mm 1:1 U-loop instead of ~100 mm around the stack
    - PWM_M1-M4, CUR and the J1 GND / VBAT stubs re-routed; GND stitching vias under J1 removed;
    logo to the rear-right corner, "TO FC" under J1; DRC 0 / 0, no via in pads
    - Stack check (ESC + FC + GPS, all plugs mated): no clash
    - Realistic renders of all four boards and of the stack; handoff §0.14 (all inter-board cables), ESC/system READMEs
    Claude-Session: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
    [ACwing_ESC1S_A.kicad_pcb, ACwing_ESC1S_A.step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]
2026-11-07 All boards 1.6 mm, KiCad 10 files and outputs
    - Board thickness 1.6 mm with the stack-up stored in the board files: FC and ESC 1S JLC04161H-7628
    (F.Cu / 0.21 mm 7628 / In1 / 1.065 mm core / In2 / 0.21 mm 7628 / B.Cu), GPS and Flow 1.51 mm core
    - Same F.Cu -> In1 prepreg as before: 50 ohm RF line (0.36 mm) and USB pair unchanged; vias 0.45/0.2 and up, standard at 1.6 mm
    - Schematics, boards and libraries upgraded to KiCad 10 format; footprint fields synced with the schematics
    - Checks with KiCad 10: DRC 0 / 0, netlist 0 errors, no via in SMD pads (exposed pads excepted, ESC 0),
    stack check with 1.6 mm boards and all plugs mated: no clash
    - Outputs regenerated with KiCad 10 (gerbers, drill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
    [ACwing_ESC1S_A.kicad_pcb, ACwing_ESC1S_A.kicad_sch, ACwing_ESC1S_A.step, ACwing_ESC1S_A_BoM.xlsx, ACwing_ESC1S_A_BoM_JLCPCB.xlsx, ACwing_FC_A.kicad_pcb, ACwing_FC_A.kicad_sch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]
2026-11-07 Docs: stack check page note matches its data (1.6 mm boards)
    The merge kept the 2026-11-07 data (1.6 mm boards, ESC link on the front edge) but also the note from a32c23c
    saying the data predated those changes; the note now states what the page shows.
    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
2026-11-07 Docs: mechanical handoff brought up to rev A (1.6 mm boards)
    - Status note with the rev A stack heights (frame z and from the ESC bottom).
    - Restored the 1.6 mm notes lost in the merge (motor board, FC, GPS).
    - Flow: plated holes with GND ring, mass 2.1 g.
    - Qwiic table, configurations and cable C route match §0.14.
    - ELRS J5 on the rear edge; GPS rev A 30 x 30 x 1.6, stack top 13.9 mm above the FC.
    - Header, §0.13, §7 and §8 updated.
    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
2026-11-07 Mechanical answer to handoff 0.14/0.15; pre-order checks (ERC KiCad 10, stock, land patterns)
    - Handoff 0.16: ESC J1 on the front edge needs the motors at RM 53 (guard ring above the
    plug); cable A 20 mm, cable C 60 mm via a deck slot behind the rear grommets; flow board
    turned with the connector edge to +X; cover and stack screws; rev B keep-out note.
    - READMEs, To check before ordering: ERC run with KiCad 10.0.6 (no real errors: power-flag
    cases, one double PWR_FLAG on the ESC), LCSC stock on 2026-11-07, land-pattern notes
    (AON7423, SAM-M10Q, CPH3225A, PMW3901), lens supply, C6/C46 decision.
    Claude-Session: https://claude.ai/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
2026-11-07 ESC 1S rev A: J1 toward the front corner (frame A1 guard ring)
    - J1 moved 3.7 mm toward the front corner and 0.8 mm inward: (+9.6, +16.88) -> (+13.3, +16.08), mouth +v.
    Limits: R3 corner (pad >= 0.3 mm from the edge) and the +10, +10 grommet (0.31 mm).
    - PWM_M1-M4, CUR and the J1 GND / VBAT stubs re-routed; "TO FC" label moved.
    - DRC 0 / 0, no via in pads; stack check with all plugs mated: no clash.
    - ESC outputs regenerated (KiCad 10); stack page data and stack render updated.
    - Handoff 0.17 for the frame (rerun the guard ring check, choose the RM); ESC README.
    Claude-Session: https://claude.ai/code/session_0189Xg6tRAL4bRZ656VQBtPX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
    [ACwing_ESC1S_A.kicad_pcb, ACwing_ESC1S_A.step, ACwing_ESC1S_A_BoM.xlsx, ACwing_ESC1S_A_BoM_JLCPCB.xlsx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]
2026-11-07 Mechanical answer to handoff 0.17 (ESC J1 toward the front corner): frame back to RM 51
    - 0.18: with J1 at (+13.3, +16.08) the frame keeps RM 51 (RM 53 of 0.16 dropped);
    cable A clears the front-left guard ring by 0.42 mm, 15.4 mm of wire (make 20 mm);
    cable C unchanged (60 mm), deck slot u 20.5-23.7, v -13.5...-10.1; all checks 0.
    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
2026-11-08 HW rev A: layout update 2 (ESC A front-left, corner LEDs), boards back to 1.0 mm
    FC:
    - ESC A (J2) on the front edge just after the front-left arc (-10.5, +16.85), right above ESC 1S J1;
    ESC B (J6) to the old ESC A place (+3.64, +16.85). M1-M4 run as a B.Cu bus under J2 / J6.
    - Front-left corner back to R3. RGB LEDs at the corner tips, point-symmetric on both corners.
    - Battery pads J7 / J8 and the BLE antenna lower on the left edge; RF line 16 mm, straight.
    - Magnetometer U3 and barometer U4 right of the MCU (front-right quadrant), ~36 mm from the buck.
    ESC 1S:
    - USB-C charge port and charger to the rear-right chamfer, under the FC USB-C (same step outline);
    front-left corner R3; J1 at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
    [ACwing_ESC1S_A.kicad_pcb, ACwing_ESC1S_A.step, ACwing_ESC1S_A_BoM.xlsx, ACwing_ESC1S_A_BoM_JLCPCB.xlsx, ACwing_FC_A.kicad_pcb, ACwing_FC_A.step, ACwing_FC_A_BoM.xlsx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]
2026-11-08 HW rev A: 45-degree routing on all boards, no FC battery pads, ESC J1 at the FC edge distance
    All boards:
    - Every track segment at 0 / 45 / 90 deg (exact coordinates). Off-angle runs replaced by octilinear
    doglegs / pad-end slides / short octilinear A* detours, same end points, pads and vias.
    FC 374 runs, ESC 51, Flow 165, GPS 11; 0 segments off 45 deg left. Duplicated segments and
    dangling stubs left by Freerouting removed. Zone fills refilled.
    - Tool and rule in tools/route45.
    - Battery pads J7 / J8 and the "- BAT +" label removed (PCB, schematic, netlist checks, BoM,
    generator). The FC is supplied only through ESC link A J2 pin 2, as on commercial FC/ESC stacks.
    - J1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
    [ACwing_ESC1S_A.kicad_pcb, ACwing_FC_A.kicad_pcb, ACwing_FC_A.kicad_sch, ACwing_FC_A_BoM.xlsx, ACwing_Flow_A.kicad_pcb, ACwing_GPS_A.kicad_pcb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]
2026-11-08 HW rev A: everything checked and regenerated with KiCad 10.0.6; ESC battery pads across the corner
    - All four boards opened, zone-filled, DRC-checked and saved with KiCad 10.0.6: DRC 0 / 0 / 0 on every board,
    schematic parity without missing or extra footprints, ERC unchanged. 45-degree rule still met (0 off-angle segments).
    - Gerber + drill, STEP, schematic PDFs, DRC reports regenerated with kicad-cli 10; CPL checked against the
    KiCad position export.
    - Realistic renders of all boards (kicad-cli pcb render, high quality) and FC routing plot regenerated.
    - Stack check page: new stack check on the KiCad 10 boards (195 objects, 1 expected clash: the USB-C plug pair),
    new meshes; stack re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
    [ACwing_ESC1S_A.kicad_pcb, ACwing_ESC1S_A.step, ACwing_FC_A.kicad_pcb, ACwing_FC_A.step, ACwing_Flow_A.kicad_pcb, ACwing_Flow_A.step, ACwing_GPS_A.kicad_pcb, ACwing_GPS_A.step]
2026-11-08 Silkscreen adjusted for ESC and FC boards
    [ACwing_ESC1S_A.kicad_pcb, ACwing_FC_A.kicad_pcb]
2026-11-12 Silkscreen for PCBs modified adding the connector pin names
    [ACwing_ESC1S_A.kicad_pcb, ACwing_FC_A.kicad_pcb, ACwing_Flow_A.kicad_pcb, ACwing_GPS_A.kicad_pcb]
2026-11-12 Board renders with the silkscreen pin names; handoff §0.22 (print-first frame)
    - FC / ESC 1S / GPS / Flow: *_pcb.png and *_3D.png regenerated with the KiCad 10.0.6
    raytracer after the silkscreen update of 568e74d (connector pin names); stack render
    regenerated (Blender Cycles, KiCad 10 GLB exports). README notes per board.
    - Mechanical handoff §0.22: Mech A1 print-first frame (wave guards, still open toward
    the body), closed wire eyelets for the connector-less motors, flat-roof cover; USB-C
    plug clearances 1.20 / 0.77 mm, first frame mode 93.9 Hz, checks 0 overlaps.
    Claude-Session: https://claude.ai/code/session_019Nr6Xnv8axs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
2026-11-13 Stack check page: board models with the silkscreen pin names
    - stack_data.js regenerated from STEP exports with silkscreen and pads
    (KiCad 10.0.6) of the boards after 568e74d; stack check rerun: same 195
    objects and 20 findings (only the known USB-C plug clash).
    - step_mesh.py: works with cadquery-ocp 7.8 and 8 (TDF_LabelSequence,
    TopoDS.Face names).
    - Page note and READMEs updated.
    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
2026-11-13 Mechanical handoff §0.23: one-piece motor holders, foot ring, motor-lead path
    ACwing_Mechs Mech A1 §13 (2026-11-13): holders rebuilt as one body with a
    foot ring (no landing loop, frame 28.0 mm tall); motor leads through the
    holder floor hole, a closed channel under the arm and 3 holes in the arm.
    ESC pads, stack and plug clearances unchanged; checks 0 overlaps.
    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
2026-11-13 Mechanical handoff §0.24: frame core rev R, flow board cover
    Frame A1 rev R (ACwing_Mechs Mech A1 §14): core regenerated as one body,
    deck ribs under the ESC (0.96 mm from its bottom-side parts; keep-out above
    z -3.2), frame 32.5 mm tall. New PETG flow board cover: only the PMW3901
    lens, VL53L1X window and LED open; flow screws M2 x 6 nylon from below.
    Flow README notes the cover.
    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
