ACwing-UAV/ACwing_HW/(notices)

Notices in the files:
01 - FC_KiCadProj/3d/C_1206_3216Metric.step:
Copyright (C) 2017, kicad StepUp
This work is licensed under the [Creative Commons CC-BY-SA 4.0 License](https://creativecommons.org/licenses/by-sa/4.0/legalcode),
with the following exception:
To the extent that the creation of electronic designs that use 'Licensed Material' can be considered to be 'Adapted Material',
You are free to use the library data in your own projects without the obligation to share your project files under this or any other license agreement.
01 - FC_KiCadProj/3d/R_0603_1608Metric.step:
Copyright (C) 2018, kicad StepUp
01 - FC_KiCadProj/3d/D_SOD-123F.step:
This program is free software: you can redistribute it and/or modify
it under the terms of the GNU General Public License as published by
the Free Software Foundation, either version 3 of the License, or
any later version.
itself might be covered by the GNU General Public License.
01 - FC_KiCadProj/3d/Johanson_2450AT18x100.step:
Copyright (C) 2020, kicad StepUp
